MuriloVAlves/TG/Dados/MOTOR_1_ANTI.txt

PWM: 0.00 | RPM: 0.00;PWM: 0.10 | RPM: 0.00;PWM: 0.20 | RPM: 0.00;PWM: 0.29 | RPM: 0.00;PWM: 0.39 | RPM: 0.00;PWM: 0.49 | RPM: 0.00;PWM: 0.59 | RPM: 0.00;PWM: 0.68 | RPM: 0.00;PWM: 0.78 | RPM: 0.00;PWM: 0.88 | RPM: 0.00;PWM: 0.98 | RPM: 0.00;PWM: 1.08 | RPM: 0.00;PWM: 1.17 | RPM: 0.00;PWM: 1.27 | RPM: 0.00;PWM: 1.37 | RPM: 0.00;PWM: 1.47 | RPM: 0.00;PWM: 1.56 | RPM: 0.00;PWM: 1.66 | RPM: 0.00;PWM: 1.76 | RPM: 0.00;PWM: 1.86 | RPM: 0.00;PWM: 1.96 | RPM: 0.00;PWM: 2.05 | RPM: 0.00;PWM: 2.15 | RPM: 0.00;PWM: 2.25 | RPM: 0.00;PWM: 2.35 | RPM: 0.00;PWM: 2.44 | RPM: 0.00;PWM: 2.54 | RPM: 0.00;PWM: 2.64 | RPM: 0.00;PWM: 2.74 | RPM: 0.00;PWM: 2.83 | RPM: 0.00;PWM: 2.93 | RPM: 0.00;PWM: 3.03 | RPM: 0.00;PWM: 3.13 | RPM: 0.00;PWM: 3.23 | RPM: 0.00;PWM: 3.32 | RPM: 0.00;PWM: 3.42 | RPM: 0.00;PWM: 3.52 | RPM: 0.00;PWM: 3.62 | RPM: 0.00;PWM: 3.71 | RPM: 0.00;PWM: 3.81 | RPM: 0.00;PWM: 3.91 | RPM: 0.00;PWM: 4.01 | RPM: 0.00;PWM: 4.11 | RPM: 0.00;PWM: 4.20 | RPM: 0.00;PWM: 4.30 | RPM: 0.00;PWM: 4.40 | RPM: 0.00;PWM: 4.50 | RPM: 0.00;PWM: 4.59 | RPM: 0.00;PWM: 4.69 | RPM: 0.00;PWM: 4.79 | RPM: 0.00;PWM: 4.89 | RPM: 0.00;PWM: 4.99 | RPM: 0.00;PWM: 5.08 | RPM: 0.00;PWM: 5.18 | RPM: 0.00;PWM: 5.28 | RPM: 0.00;PWM: 5.38 | RPM: 0.00;PWM: 5.47 | RPM: 0.00;PWM: 5.57 | RPM: 0.00;PWM: 5.67 | RPM: 0.00;PWM: 5.77 | RPM: 0.00;PWM: 5.87 | RPM: 0.00;PWM: 5.96 | RPM: 0.00;PWM: 6.06 | RPM: 0.00;PWM: 6.16 | RPM: 0.00;PWM: 6.26 | RPM: 0.00;PWM: 6.35 | RPM: 0.00;PWM: 6.45 | RPM: 0.00;PWM: 6.55 | RPM: 0.00;PWM: 6.65 | RPM: 0.00;PWM: 6.74 | RPM: 0.00;PWM: 6.84 | RPM: 0.00;PWM: 6.94 | RPM: 0.00;PWM: 7.04 | RPM: 0.00;PWM: 7.14 | RPM: 0.00;PWM: 7.23 | RPM: 0.00;PWM: 7.33 | RPM: 0.00;PWM: 7.43 | RPM: 0.00;PWM: 7.53 | RPM: 0.00;PWM: 7.62 | RPM: 0.00;PWM: 7.72 | RPM: 0.00;PWM: 7.82 | RPM: 0.00;PWM: 7.92 | RPM: 0.00;PWM: 8.02 | RPM: 0.00;PWM: 8.11 | RPM: 0.00;PWM: 8.21 | RPM: 0.00;PWM: 8.31 | RPM: 0.00;PWM: 8.41 | RPM: 0.00;PWM: 8.50 | RPM: 0.00;PWM: 8.60 | RPM: 0.00;PWM: 8.70 | RPM: 0.00;PWM: 8.80 | RPM: 0.00;PWM: 8.90 | RPM: 0.00;PWM: 8.99 | RPM: 0.00;PWM: 9.09 | RPM: 0.00;PWM: 9.19 | RPM: 0.00;PWM: 9.29 | RPM: 0.00;PWM: 9.38 | RPM: 0.00;PWM: 9.48 | RPM: 0.00;PWM: 9.58 | RPM: 0.00;PWM: 9.68 | RPM: 0.00;PWM: 9.78 | RPM: 0.00;PWM: 9.87 | RPM: 0.00;PWM: 9.97 | RPM: 0.00;PWM: 10.07 | RPM: 0.00;PWM: 10.17 | RPM: 0.00;PWM: 10.26 | RPM: 0.00;PWM: 10.36 | RPM: 0.00;PWM: 10.46 | RPM: 0.00;PWM: 10.56 | RPM: 0.00;PWM: 10.65 | RPM: 0.00;PWM: 10.75 | RPM: 0.00;PWM: 10.85 | RPM: 0.00;PWM: 10.95 | RPM: 0.00;PWM: 11.05 | RPM: 0.00;PWM: 11.14 | RPM: 0.00;PWM: 11.24 | RPM: 0.00;PWM: 11.34 | RPM: 0.00;PWM: 11.44 | RPM: 0.00;PWM: 11.53 | RPM: 0.00;PWM: 11.63 | RPM: 0.00;PWM: 11.73 | RPM: 0.00;PWM: 11.83 | RPM: 0.00;PWM: 11.93 | RPM: 0.00;PWM: 12.02 | RPM: 0.00;PWM: 12.12 | RPM: 0.00;PWM: 12.22 | RPM: 0.00;PWM: 12.32 | RPM: 0.00;PWM: 12.41 | RPM: 0.00;PWM: 12.51 | RPM: 0.00;PWM: 12.61 | RPM: 0.00;PWM: 12.71 | RPM: 0.00;PWM: 12.81 | RPM: 0.00;PWM: 12.90 | RPM: 0.00;PWM: 13.00 | RPM: 0.00;PWM: 13.10 | RPM: 0.00;PWM: 13.20 | RPM: 0.00;PWM: 13.29 | RPM: 0.00;PWM: 13.39 | RPM: 0.00;PWM: 13.49 | RPM: 0.00;PWM: 13.59 | RPM: 0.00;PWM: 13.69 | RPM: 0.00;PWM: 13.78 | RPM: 0.00;PWM: 13.88 | RPM: 0.00;PWM: 13.98 | RPM: 0.00;PWM: 14.08 | RPM: 0.00;PWM: 14.17 | RPM: 0.00;PWM: 14.27 | RPM: 0.00;PWM: 14.37 | RPM: 0.00;PWM: 14.47 | RPM: 0.00;PWM: 14.57 | RPM: 0.00;PWM: 14.66 | RPM: 0.00;PWM: 14.76 | RPM: 0.00;PWM: 14.86 | RPM: 0.00;PWM: 14.96 | RPM: 0.00;PWM: 15.05 | RPM: 0.00;PWM: 15.15 | RPM: 0.00;PWM: 15.25 | RPM: 0.00;PWM: 15.35 | RPM: 0.00;PWM: 15.44 | RPM: 0.00;PWM: 15.54 | RPM: 0.00;PWM: 15.64 | RPM: 0.00;PWM: 15.74 | RPM: 0.00;PWM: 15.84 | RPM: 0.00;PWM: 15.93 | RPM: 0.00;PWM: 16.03 | RPM: 0.00;PWM: 16.13 | RPM: 0.00;PWM: 16.23 | RPM: 0.00;PWM: 16.32 | RPM: 0.00;PWM: 16.42 | RPM: 0.00;PWM: 16.52 | RPM: 0.00;PWM: 16.62 | RPM: 0.00;PWM: 16.72 | RPM: 0.00;PWM: 16.81 | RPM: 0.00;PWM: 16.91 | RPM: 0.00;PWM: 17.01 | RPM: 0.00;PWM: 17.11 | RPM: 0.00;PWM: 17.20 | RPM: 0.00;PWM: 17.30 | RPM: 0.00;PWM: 17.40 | RPM: 0.00;PWM: 17.50 | RPM: 0.00;PWM: 17.60 | RPM: 0.00;PWM: 17.69 | RPM: 0.00;PWM: 17.79 | RPM: 0.00;PWM: 17.89 | RPM: 0.00;PWM: 17.99 | RPM: 0.00;PWM: 18.08 | RPM: 0.00;PWM: 18.18 | RPM: 0.00;PWM: 18.28 | RPM: 0.00;PWM: 18.38 | RPM: 0.00;PWM: 18.48 | RPM: 0.00;PWM: 18.57 | RPM: 0.00;PWM: 18.67 | RPM: 0.00;PWM: 18.77 | RPM: 0.00;PWM: 18.87 | RPM: 0.00;PWM: 18.96 | RPM: 0.00;PWM: 19.06 | RPM: 0.00;PWM: 19.16 | RPM: 0.00;PWM: 19.26 | RPM: 0.00;PWM: 19.35 | RPM: 0.00;PWM: 19.45 | RPM: 0.00;PWM: 19.55 | RPM: 0.00;PWM: 19.65 | RPM: 0.00;PWM: 19.75 | RPM: 0.00;PWM: 19.84 | RPM: 0.00;PWM: 19.94 | RPM: 0.00;PWM: 20.04 | RPM: 0.00;PWM: 20.14 | RPM: 0.00;PWM: 20.23 | RPM: 0.00;PWM: 20.33 | RPM: 0.00;PWM: 20.43 | RPM: 0.00;PWM: 20.53 | RPM: 0.00;PWM: 20.63 | RPM: 0.00;PWM: 20.72 | RPM: 0.00;PWM: 20.82 | RPM: 0.00;PWM: 20.92 | RPM: 0.00;PWM: 21.02 | RPM: 0.00;PWM: 21.11 | RPM: 0.00;PWM: 21.21 | RPM: 0.00;PWM: 21.31 | RPM: 0.00;PWM: 21.41 | RPM: 0.00;PWM: 21.51 | RPM: 0.00;PWM: 21.60 | RPM: 0.00;PWM: 21.70 | RPM: 0.00;PWM: 21.80 | RPM: 0.00;PWM: 21.90 | RPM: 0.00;PWM: 21.99 | RPM: 0.00;PWM: 22.09 | RPM: 0.00;PWM: 22.19 | RPM: 0.00;PWM: 22.29 | RPM: 0.00;PWM: 22.39 | RPM: 0.00;PWM: 22.48 | RPM: 0.00;PWM: 22.58 | RPM: 0.00;PWM: 22.68 | RPM: 0.00;PWM: 22.78 | RPM: 0.00;PWM: 22.87 | RPM: 0.00;PWM: 22.97 | RPM: 0.00;PWM: 23.07 | RPM: 0.00;PWM: 23.17 | RPM: 0.00;PWM: 23.26 | RPM: 0.00;PWM: 23.36 | RPM: 0.00;PWM: 23.46 | RPM: 0.00;PWM: 23.56 | RPM: 0.00;PWM: 23.66 | RPM: 0.00;PWM: 23.75 | RPM: 0.00;PWM: 23.85 | RPM: 0.00;PWM: 23.95 | RPM: 0.00;PWM: 24.05 | RPM: 0.00;PWM: 24.14 | RPM: 0.00;PWM: 24.24 | RPM: 0.00;PWM: 24.34 | RPM: 0.00;PWM: 24.44 | RPM: 0.00;PWM: 24.54 | RPM: 0.00;PWM: 24.63 | RPM: 0.00;PWM: 24.73 | RPM: 0.00;PWM: 24.83 | RPM: 0.00;PWM: 24.93 | RPM: 0.00;PWM: 25.02 | RPM: 0.00;PWM: 25.12 | RPM: 0.00;PWM: 25.22 | RPM: 0.00;PWM: 25.32 | RPM: 0.00;PWM: 25.42 | RPM: 0.00;PWM: 25.51 | RPM: 0.00;PWM: 25.61 | RPM: 0.00;PWM: 25.71 | RPM: 0.00;PWM: 25.81 | RPM: 0.00;PWM: 25.90 | RPM: 0.00;PWM: 26.00 | RPM: 0.00;PWM: 26.10 | RPM: 0.00;PWM: 26.20 | RPM: 0.00;PWM: 26.30 | RPM: 0.00;PWM: 26.39 | RPM: 0.00;PWM: 26.49 | RPM: 0.00;PWM: 26.59 | RPM: 0.00;PWM: 26.69 | RPM: 0.00;PWM: 26.78 | RPM: 0.00;PWM: 26.88 | RPM: 0.00;PWM: 26.98 | RPM: 0.00;PWM: 27.08 | RPM: 0.00;PWM: 27.17 | RPM: 0.00;PWM: 27.27 | RPM: 0.00;PWM: 27.37 | RPM: 0.00;PWM: 27.47 | RPM: 0.00;PWM: 27.57 | RPM: 0.00;PWM: 27.66 | RPM: 0.00;PWM: 27.76 | RPM: 0.00;PWM: 27.86 | RPM: 0.00;PWM: 27.96 | RPM: 0.00;PWM: 28.05 | RPM: 0.00;PWM: 28.15 | RPM: 0.00;PWM: 28.25 | RPM: 0.00;PWM: 28.35 | RPM: 0.00;PWM: 28.45 | RPM: 0.00;PWM: 28.54 | RPM: 0.00;PWM: 28.64 | RPM: 0.00;PWM: 28.74 | RPM: 0.00;PWM: 28.84 | RPM: 0.00;PWM: 28.93 | RPM: 0.00;PWM: 29.03 | RPM: 0.00;PWM: 29.13 | RPM: 0.00;PWM: 29.23 | RPM: 0.00;PWM: 29.33 | RPM: 0.00;PWM: 29.42 | RPM: 0.00;PWM: 29.52 | RPM: 0.00;PWM: 29.62 | RPM: 0.00;PWM: 29.72 | RPM: 0.00;PWM: 29.81 | RPM: 0.00;PWM: 29.91 | RPM: 0.00;PWM: 30.01 | RPM: 0.00;PWM: 30.11 | RPM: 0.00;PWM: 30.21 | RPM: 0.00;PWM: 30.30 | RPM: 0.00;PWM: 30.40 | RPM: 0.00;PWM: 30.50 | RPM: 0.00;PWM: 30.60 | RPM: 0.00;PWM: 30.69 | RPM: 0.00;PWM: 30.79 | RPM: 0.00;PWM: 30.89 | RPM: 0.00;PWM: 30.99 | RPM: 0.00;PWM: 31.09 | RPM: 0.00;PWM: 31.18 | RPM: 0.00;PWM: 31.28 | RPM: 0.00;PWM: 31.38 | RPM: 0.00;PWM: 31.48 | RPM: 0.00;PWM: 31.57 | RPM: 0.00;PWM: 31.67 | RPM: 0.00;PWM: 31.77 | RPM: 0.00;PWM: 31.87 | RPM: 0.00;PWM: 31.96 | RPM: 0.00;PWM: 32.06 | RPM: 0.00;PWM: 32.16 | RPM: 0.00;PWM: 32.26 | RPM: 0.00;PWM: 32.36 | RPM: 0.00;PWM: 32.45 | RPM: 0.00;PWM: 32.55 | RPM: 0.00;PWM: 32.65 | RPM: 0.00;PWM: 32.75 | RPM: 0.00;PWM: 32.84 | RPM: 0.00;PWM: 32.94 | RPM: 0.00;PWM: 33.04 | RPM: 0.00;PWM: 33.14 | RPM: 0.00;PWM: 33.24 | RPM: 0.00;PWM: 33.33 | RPM: 0.00;PWM: 33.43 | RPM: 0.00;PWM: 33.53 | RPM: 0.00;PWM: 33.63 | RPM: 0.00;PWM: 33.72 | RPM: 0.00;PWM: 33.82 | RPM: 0.00;PWM: 33.92 | RPM: 0.00;PWM: 34.02 | RPM: 0.00;PWM: 34.12 | RPM: 0.00;PWM: 34.21 | RPM: 0.00;PWM: 34.31 | RPM: 0.00;PWM: 34.41 | RPM: 0.00;PWM: 34.51 | RPM: 0.00;PWM: 34.60 | RPM: 0.00;PWM: 34.70 | RPM: 0.00;PWM: 34.80 | RPM: 0.00;PWM: 34.90 | RPM: 0.00;PWM: 35.00 | RPM: 0.00;PWM: 35.09 | RPM: 0.00;PWM: 35.19 | RPM: 0.00;PWM: 35.29 | RPM: 0.00;PWM: 35.39 | RPM: 0.00;PWM: 35.48 | RPM: 0.00;PWM: 35.58 | RPM: 0.00;PWM: 35.68 | RPM: 0.00;PWM: 35.78 | RPM: 0.00;PWM: 35.87 | RPM: 0.00;PWM: 35.97 | RPM: 0.00;PWM: 36.07 | RPM: 0.00;PWM: 36.17 | RPM: 0.00;PWM: 36.27 | RPM: 0.00;PWM: 36.36 | RPM: 0.00;PWM: 36.46 | RPM: 0.00;PWM: 36.56 | RPM: 0.00;PWM: 36.66 | RPM: 0.00;PWM: 36.75 | RPM: 0.00;PWM: 36.85 | RPM: 0.00;PWM: 36.95 | RPM: 0.00;PWM: 37.05 | RPM: 0.00;PWM: 37.15 | RPM: 0.00;PWM: 37.24 | RPM: 0.00;PWM: 37.34 | RPM: 0.00;PWM: 37.44 | RPM: 0.00;PWM: 37.54 | RPM: 0.00;PWM: 37.63 | RPM: 0.00;PWM: 37.73 | RPM: 0.00;PWM: 37.83 | RPM: 0.00;PWM: 37.93 | RPM: 0.00;PWM: 38.03 | RPM: 0.00;PWM: 38.12 | RPM: 0.00;PWM: 38.22 | RPM: 0.00;PWM: 38.32 | RPM: 0.00;PWM: 38.42 | RPM: 0.00;PWM: 38.51 | RPM: 0.00;PWM: 38.61 | RPM: 0.00;PWM: 38.71 | RPM: 0.00;PWM: 38.81 | RPM: 0.00;PWM: 38.91 | RPM: 0.00;PWM: 39.00 | RPM: 0.00;PWM: 39.10 | RPM: 0.00;PWM: 39.20 | RPM: 0.00;PWM: 39.30 | RPM: 0.00;PWM: 39.39 | RPM: 0.00;PWM: 39.49 | RPM: 0.00;PWM: 39.59 | RPM: 0.00;PWM: 39.69 | RPM: 0.00;PWM: 39.78 | RPM: 0.00;PWM: 39.88 | RPM: 0.00;PWM: 39.98 | RPM: 0.00;PWM: 40.08 | RPM: 0.00;PWM: 40.18 | RPM: 0.00;PWM: 40.27 | RPM: 0.00;PWM: 40.37 | RPM: 0.00;PWM: 40.47 | RPM: 0.00;PWM: 40.57 | RPM: 0.00;PWM: 40.66 | RPM: 0.00;PWM: 40.76 | RPM: 0.00;PWM: 40.86 | RPM: 0.00;PWM: 40.96 | RPM: 0.00;PWM: 41.06 | RPM: 0.00;PWM: 41.15 | RPM: 0.00;PWM: 41.25 | RPM: 0.00;PWM: 41.35 | RPM: 0.00;PWM: 41.45 | RPM: 0.00;PWM: 41.54 | RPM: 0.00;PWM: 41.64 | RPM: 0.00;PWM: 41.74 | RPM: 0.00;PWM: 41.84 | RPM: 0.00;PWM: 41.94 | RPM: 0.00;PWM: 42.03 | RPM: 0.00;PWM: 42.13 | RPM: 0.00;PWM: 42.23 | RPM: 0.00;PWM: 42.33 | RPM: 16.67;PWM: 42.42 | RPM: 93.33;PWM: 42.52 | RPM: 136.67;PWM: 42.62 | RPM: 153.33;PWM: 42.72 | RPM: 150.00;PWM: 42.82 | RPM: 153.33;PWM: 42.91 | RPM: 153.33;PWM: 43.01 | RPM: 156.67;PWM: 43.11 | RPM: 156.67;PWM: 43.21 | RPM: 156.67;PWM: 43.30 | RPM: 160.00;PWM: 43.40 | RPM: 160.00;PWM: 43.50 | RPM: 160.00;PWM: 43.60 | RPM: 160.00;PWM: 43.70 | RPM: 163.33;PWM: 43.79 | RPM: 163.33;PWM: 43.89 | RPM: 163.33;PWM: 43.99 | RPM: 166.67;PWM: 44.09 | RPM: 166.67;PWM: 44.18 | RPM: 170.00;PWM: 44.28 | RPM: 170.00;PWM: 44.38 | RPM: 170.00;PWM: 44.48 | RPM: 173.33;PWM: 44.57 | RPM: 173.33;PWM: 44.67 | RPM: 176.67;PWM: 44.77 | RPM: 180.00;PWM: 44.87 | RPM: 176.67;PWM: 44.97 | RPM: 176.67;PWM: 45.06 | RPM: 176.67;PWM: 45.16 | RPM: 180.00;PWM: 45.26 | RPM: 180.00;PWM: 45.36 | RPM: 180.00;PWM: 45.45 | RPM: 183.33;PWM: 45.55 | RPM: 180.00;PWM: 45.65 | RPM: 186.67;PWM: 45.75 | RPM: 186.67;PWM: 45.85 | RPM: 186.67;PWM: 45.94 | RPM: 186.67;PWM: 46.04 | RPM: 193.33;PWM: 46.14 | RPM: 190.00;PWM: 46.24 | RPM: 193.33;PWM: 46.33 | RPM: 193.33;PWM: 46.43 | RPM: 193.33;PWM: 46.53 | RPM: 196.67;PWM: 46.63 | RPM: 196.67;PWM: 46.73 | RPM: 200.00;PWM: 46.82 | RPM: 203.33;PWM: 46.92 | RPM: 203.33;PWM: 47.02 | RPM: 200.00;PWM: 47.12 | RPM: 203.33;PWM: 47.21 | RPM: 200.00;PWM: 47.31 | RPM: 206.67;PWM: 47.41 | RPM: 203.33;PWM: 47.51 | RPM: 206.67;PWM: 47.61 | RPM: 206.67;PWM: 47.70 | RPM: 210.00;PWM: 47.80 | RPM: 210.00;PWM: 47.90 | RPM: 216.67;PWM: 48.00 | RPM: 216.67;PWM: 48.09 | RPM: 216.67;PWM: 48.19 | RPM: 223.33;PWM: 48.29 | RPM: 216.67;PWM: 48.39 | RPM: 220.00;PWM: 48.48 | RPM: 223.33;PWM: 48.58 | RPM: 216.67;PWM: 48.68 | RPM: 223.33;PWM: 48.78 | RPM: 226.67;PWM: 48.88 | RPM: 220.00;PWM: 48.97 | RPM: 223.33;PWM: 49.07 | RPM: 226.67;PWM: 49.17 | RPM: 223.33;PWM: 49.27 | RPM: 226.67;PWM: 49.36 | RPM: 226.67;PWM: 49.46 | RPM: 226.67;PWM: 49.56 | RPM: 230.00;PWM: 49.66 | RPM: 233.33;PWM: 49.76 | RPM: 230.00;PWM: 49.85 | RPM: 233.33;PWM: 49.95 | RPM: 233.33;PWM: 50.05 | RPM: 236.67;PWM: 50.15 | RPM: 240.00;PWM: 50.24 | RPM: 236.67;PWM: 50.34 | RPM: 240.00;PWM: 50.44 | RPM: 236.67;PWM: 50.54 | RPM: 243.33;PWM: 50.64 | RPM: 243.33;PWM: 50.73 | RPM: 243.33;PWM: 50.83 | RPM: 243.33;PWM: 50.93 | RPM: 243.33;PWM: 51.03 | RPM: 243.33;PWM: 51.12 | RPM: 243.33;PWM: 51.22 | RPM: 246.67;PWM: 51.32 | RPM: 250.00;PWM: 51.42 | RPM: 250.00;PWM: 51.52 | RPM: 253.33;PWM: 51.61 | RPM: 250.00;PWM: 51.71 | RPM: 253.33;PWM: 51.81 | RPM: 253.33;PWM: 51.91 | RPM: 256.67;PWM: 52.00 | RPM: 256.67;PWM: 52.10 | RPM: 256.67;PWM: 52.20 | RPM: 260.00;PWM: 52.30 | RPM: 263.33;PWM: 52.39 | RPM: 260.00;PWM: 52.49 | RPM: 263.33;PWM: 52.59 | RPM: 263.33;PWM: 52.69 | RPM: 263.33;PWM: 52.79 | RPM: 266.67;PWM: 52.88 | RPM: 266.67;PWM: 52.98 | RPM: 273.33;PWM: 53.08 | RPM: 276.67;PWM: 53.18 | RPM: 276.67;PWM: 53.27 | RPM: 273.33;PWM: 53.37 | RPM: 276.67;PWM: 53.47 | RPM: 273.33;PWM: 53.57 | RPM: 276.67;PWM: 53.67 | RPM: 283.33;PWM: 53.76 | RPM: 280.00;PWM: 53.86 | RPM: 276.67;PWM: 53.96 | RPM: 286.67;PWM: 54.06 | RPM: 286.67;PWM: 54.15 | RPM: 280.00;PWM: 54.25 | RPM: 283.33;PWM: 54.35 | RPM: 283.33;PWM: 54.45 | RPM: 290.00;PWM: 54.55 | RPM: 283.33;PWM: 54.64 | RPM: 293.33;PWM: 54.74 | RPM: 286.67;PWM: 54.84 | RPM: 290.00;PWM: 54.94 | RPM: 293.33;PWM: 55.03 | RPM: 290.00;PWM: 55.13 | RPM: 293.33;PWM: 55.23 | RPM: 293.33;PWM: 55.33 | RPM: 293.33;PWM: 55.43 | RPM: 293.33;PWM: 55.52 | RPM: 303.33;PWM: 55.62 | RPM: 296.67;PWM: 55.72 | RPM: 303.33;PWM: 55.82 | RPM: 310.00;PWM: 55.91 | RPM: 306.67;PWM: 56.01 | RPM: 303.33;PWM: 56.11 | RPM: 303.33;PWM: 56.21 | RPM: 306.67;PWM: 56.30 | RPM: 306.67;PWM: 56.40 | RPM: 306.67;PWM: 56.50 | RPM: 306.67;PWM: 56.60 | RPM: 306.67;PWM: 56.70 | RPM: 313.33;PWM: 56.79 | RPM: 316.67;PWM: 56.89 | RPM: 310.00;PWM: 56.99 | RPM: 316.67;PWM: 57.09 | RPM: 316.67;PWM: 57.18 | RPM: 320.00;PWM: 57.28 | RPM: 310.00;PWM: 57.38 | RPM: 310.00;PWM: 57.48 | RPM: 316.67;PWM: 57.58 | RPM: 316.67;PWM: 57.67 | RPM: 320.00;PWM: 57.77 | RPM: 323.33;PWM: 57.87 | RPM: 330.00;PWM: 57.97 | RPM: 323.33;PWM: 58.06 | RPM: 323.33;PWM: 58.16 | RPM: 330.00;PWM: 58.26 | RPM: 326.67;PWM: 58.36 | RPM: 330.00;PWM: 58.46 | RPM: 330.00;PWM: 58.55 | RPM: 333.33;PWM: 58.65 | RPM: 330.00;PWM: 58.75 | RPM: 336.67;PWM: 58.85 | RPM: 336.67;PWM: 58.94 | RPM: 336.67;PWM: 59.04 | RPM: 340.00;PWM: 59.14 | RPM: 336.67;PWM: 59.24 | RPM: 350.00;PWM: 59.34 | RPM: 340.00;PWM: 59.43 | RPM: 340.00;PWM: 59.53 | RPM: 343.33;PWM: 59.63 | RPM: 343.33;PWM: 59.73 | RPM: 343.33;PWM: 59.82 | RPM: 346.67;PWM: 59.92 | RPM: 356.67;PWM: 60.02 | RPM: 346.67;PWM: 60.12 | RPM: 360.00;PWM: 60.22 | RPM: 350.00;PWM: 60.31 | RPM: 350.00;PWM: 60.41 | RPM: 366.67;PWM: 60.51 | RPM: 356.67;PWM: 60.61 | RPM: 356.67;PWM: 60.70 | RPM: 363.33;PWM: 60.80 | RPM: 366.67;PWM: 60.90 | RPM: 366.67;PWM: 61.00 | RPM: 363.33;PWM: 61.09 | RPM: 360.00;PWM: 61.19 | RPM: 366.67;PWM: 61.29 | RPM: 363.33;PWM: 61.39 | RPM: 363.33;PWM: 61.49 | RPM: 370.00;PWM: 61.58 | RPM: 366.67;PWM: 61.68 | RPM: 370.00;PWM: 61.78 | RPM: 370.00;PWM: 61.88 | RPM: 370.00;PWM: 61.97 | RPM: 373.33;PWM: 62.07 | RPM: 370.00;PWM: 62.17 | RPM: 373.33;PWM: 62.27 | RPM: 376.67;PWM: 62.37 | RPM: 373.33;PWM: 62.46 | RPM: 373.33;PWM: 62.56 | RPM: 383.33;PWM: 62.66 | RPM: 373.33;PWM: 62.76 | RPM: 376.67;PWM: 62.85 | RPM: 373.33;PWM: 62.95 | RPM: 373.33;PWM: 63.05 | RPM: 380.00;PWM: 63.15 | RPM: 380.00;PWM: 63.25 | RPM: 376.67;PWM: 63.34 | RPM: 386.67;PWM: 63.44 | RPM: 390.00;PWM: 63.54 | RPM: 380.00;PWM: 63.64 | RPM: 383.33;PWM: 63.73 | RPM: 386.67;PWM: 63.83 | RPM: 393.33;PWM: 63.93 | RPM: 393.33;PWM: 64.03 | RPM: 390.00;PWM: 64.13 | RPM: 390.00;PWM: 64.22 | RPM: 390.00;PWM: 64.32 | RPM: 393.33;PWM: 64.42 | RPM: 390.00;PWM: 64.52 | RPM: 393.33;PWM: 64.61 | RPM: 393.33;PWM: 64.71 | RPM: 396.67;PWM: 64.81 | RPM: 376.67;PWM: 64.91 | RPM: 393.33;PWM: 65.00 | RPM: 393.33;PWM: 65.10 | RPM: 370.00;PWM: 65.20 | RPM: 360.00;PWM: 65.30 | RPM: 370.00;PWM: 65.40 | RPM: 366.67;PWM: 65.49 | RPM: 366.67;PWM: 65.59 | RPM: 370.00;PWM: 65.69 | RPM: 370.00;PWM: 65.79 | RPM: 366.67;PWM: 65.88 | RPM: 370.00;PWM: 65.98 | RPM: 370.00;PWM: 66.08 | RPM: 370.00;PWM: 66.18 | RPM: 366.67;PWM: 66.28 | RPM: 380.00;PWM: 66.37 | RPM: 400.00;PWM: 66.47 | RPM: 413.33;PWM: 66.57 | RPM: 413.33;PWM: 66.67 | RPM: 416.67;PWM: 66.76 | RPM: 406.67;PWM: 66.86 | RPM: 403.33;PWM: 66.96 | RPM: 406.67;PWM: 67.06 | RPM: 410.00;PWM: 67.16 | RPM: 406.67;PWM: 67.25 | RPM: 400.00;PWM: 67.35 | RPM: 400.00;PWM: 67.45 | RPM: 413.33;PWM: 67.55 | RPM: 426.67;PWM: 67.64 | RPM: 430.00;PWM: 67.74 | RPM: 433.33;PWM: 67.84 | RPM: 433.33;PWM: 67.94 | RPM: 436.67;PWM: 68.04 | RPM: 436.67;PWM: 68.13 | RPM: 440.00;PWM: 68.23 | RPM: 440.00;PWM: 68.33 | RPM: 440.00;PWM: 68.43 | RPM: 440.00;PWM: 68.52 | RPM: 440.00;PWM: 68.62 | RPM: 443.33;PWM: 68.72 | RPM: 450.00;PWM: 68.82 | RPM: 446.67;PWM: 68.91 | RPM: 446.67;PWM: 69.01 | RPM: 450.00;PWM: 69.11 | RPM: 453.33;PWM: 69.21 | RPM: 453.33;PWM: 69.31 | RPM: 450.00;PWM: 69.40 | RPM: 456.67;PWM: 69.50 | RPM: 453.33;PWM: 69.60 | RPM: 453.33;PWM: 69.70 | RPM: 456.67;PWM: 69.79 | RPM: 463.33;PWM: 69.89 | RPM: 463.33;PWM: 69.99 | RPM: 466.67;PWM: 70.09 | RPM: 460.00;PWM: 70.19 | RPM: 470.00;PWM: 70.28 | RPM: 463.33;PWM: 70.38 | RPM: 463.33;PWM: 70.48 | RPM: 473.33;PWM: 70.58 | RPM: 470.00;PWM: 70.67 | RPM: 473.33;PWM: 70.77 | RPM: 480.00;PWM: 70.87 | RPM: 470.00;PWM: 70.97 | RPM: 470.00;PWM: 71.07 | RPM: 473.33;PWM: 71.16 | RPM: 470.00;PWM: 71.26 | RPM: 473.33;PWM: 71.36 | RPM: 476.67;PWM: 71.46 | RPM: 480.00;PWM: 71.55 | RPM: 476.67;PWM: 71.65 | RPM: 480.00;PWM: 71.75 | RPM: 493.33;PWM: 71.85 | RPM: 476.67;PWM: 71.95 | RPM: 483.33;PWM: 72.04 | RPM: 483.33;PWM: 72.14 | RPM: 493.33;PWM: 72.24 | RPM: 490.00;PWM: 72.34 | RPM: 490.00;PWM: 72.43 | RPM: 480.00;PWM: 72.53 | RPM: 483.33;PWM: 72.63 | RPM: 490.00;PWM: 72.73 | RPM: 490.00;PWM: 72.83 | RPM: 490.00;PWM: 72.92 | RPM: 483.33;PWM: 73.02 | RPM: 483.33;PWM: 73.12 | RPM: 476.67;PWM: 73.22 | RPM: 476.67;PWM: 73.31 | RPM: 476.67;PWM: 73.41 | RPM: 486.67;PWM: 73.51 | RPM: 490.00;PWM: 73.61 | RPM: 496.67;PWM: 73.70 | RPM: 503.33;PWM: 73.80 | RPM: 493.33;PWM: 73.90 | RPM: 500.00;PWM: 74.00 | RPM: 500.00;PWM: 74.10 | RPM: 510.00;PWM: 74.19 | RPM: 506.67;PWM: 74.29 | RPM: 520.00;PWM: 74.39 | RPM: 510.00;PWM: 74.49 | RPM: 510.00;PWM: 74.58 | RPM: 510.00;PWM: 74.68 | RPM: 506.67;PWM: 74.78 | RPM: 506.67;PWM: 74.88 | RPM: 516.67;PWM: 74.98 | RPM: 510.00;PWM: 75.07 | RPM: 516.67;PWM: 75.17 | RPM: 520.00;PWM: 75.27 | RPM: 526.67;PWM: 75.37 | RPM: 526.67;PWM: 75.46 | RPM: 526.67;PWM: 75.56 | RPM: 536.67;PWM: 75.66 | RPM: 520.00;PWM: 75.76 | RPM: 520.00;PWM: 75.86 | RPM: 523.33;PWM: 75.95 | RPM: 516.67;PWM: 76.05 | RPM: 513.33;PWM: 76.15 | RPM: 513.33;PWM: 76.25 | RPM: 526.67;PWM: 76.34 | RPM: 513.33;PWM: 76.44 | RPM: 510.00;PWM: 76.54 | RPM: 513.33;PWM: 76.64 | RPM: 510.00;PWM: 76.74 | RPM: 510.00;PWM: 76.83 | RPM: 513.33;PWM: 76.93 | RPM: 506.67;PWM: 77.03 | RPM: 513.33;PWM: 77.13 | RPM: 516.67;PWM: 77.22 | RPM: 506.67;PWM: 77.32 | RPM: 516.67;PWM: 77.42 | RPM: 520.00;PWM: 77.52 | RPM: 520.00;PWM: 77.61 | RPM: 510.00;PWM: 77.71 | RPM: 510.00;PWM: 77.81 | RPM: 523.33;PWM: 77.91 | RPM: 510.00;PWM: 78.01 | RPM: 516.67;PWM: 78.10 | RPM: 510.00;PWM: 78.20 | RPM: 520.00;PWM: 78.30 | RPM: 513.33;PWM: 78.40 | RPM: 503.33;PWM: 78.49 | RPM: 500.00;PWM: 78.59 | RPM: 500.00;PWM: 78.69 | RPM: 506.67;PWM: 78.79 | RPM: 503.33;PWM: 78.89 | RPM: 503.33;PWM: 78.98 | RPM: 506.67;PWM: 79.08 | RPM: 513.33;PWM: 79.18 | RPM: 506.67;PWM: 79.28 | RPM: 506.67;PWM: 79.37 | RPM: 510.00;PWM: 79.47 | RPM: 510.00;PWM: 79.57 | RPM: 513.33;PWM: 79.67 | RPM: 513.33;PWM: 79.77 | RPM: 503.33;PWM: 79.86 | RPM: 520.00;PWM: 79.96 | RPM: 513.33;PWM: 80.06 | RPM: 510.00;PWM: 80.16 | RPM: 510.00;PWM: 80.25 | RPM: 510.00;PWM: 80.35 | RPM: 493.33;PWM: 80.45 | RPM: 496.67;PWM: 80.55 | RPM: 503.33;PWM: 80.65 | RPM: 493.33;PWM: 80.74 | RPM: 490.00;PWM: 80.84 | RPM: 496.67;PWM: 80.94 | RPM: 490.00;PWM: 81.04 | RPM: 496.67;PWM: 81.13 | RPM: 503.33;PWM: 81.23 | RPM: 506.67;PWM: 81.33 | RPM: 513.33;PWM: 81.43 | RPM: 520.00;PWM: 81.52 | RPM: 516.67;PWM: 81.62 | RPM: 516.67;PWM: 81.72 | RPM: 523.33;PWM: 81.82 | RPM: 526.67;PWM: 81.92 | RPM: 516.67;PWM: 82.01 | RPM: 516.67;PWM: 82.11 | RPM: 520.00;PWM: 82.21 | RPM: 533.33;PWM: 82.31 | RPM: 533.33;PWM: 82.40 | RPM: 543.33;PWM: 82.50 | RPM: 540.00;PWM: 82.60 | RPM: 546.67;PWM: 82.70 | RPM: 540.00;PWM: 82.80 | RPM: 543.33;PWM: 82.89 | RPM: 543.33;PWM: 82.99 | RPM: 553.33;PWM: 83.09 | RPM: 550.00;PWM: 83.19 | RPM: 556.67;PWM: 83.28 | RPM: 560.00;PWM: 83.38 | RPM: 570.00;PWM: 83.48 | RPM: 570.00;PWM: 83.58 | RPM: 556.67;PWM: 83.68 | RPM: 563.33;PWM: 83.77 | RPM: 573.33;PWM: 83.87 | RPM: 570.00;PWM: 83.97 | RPM: 570.00;PWM: 84.07 | RPM: 570.00;PWM: 84.16 | RPM: 576.67;PWM: 84.26 | RPM: 580.00;PWM: 84.36 | RPM: 576.67;PWM: 84.46 | RPM: 580.00;PWM: 84.56 | RPM: 583.33;PWM: 84.65 | RPM: 586.67;PWM: 84.75 | RPM: 583.33;PWM: 84.85 | RPM: 593.33;PWM: 84.95 | RPM: 593.33;PWM: 85.04 | RPM: 603.33;PWM: 85.14 | RPM: 606.67;PWM: 85.24 | RPM: 603.33;PWM: 85.34 | RPM: 610.00;PWM: 85.43 | RPM: 606.67;PWM: 85.53 | RPM: 606.67;PWM: 85.63 | RPM: 606.67;PWM: 85.73 | RPM: 616.67;PWM: 85.83 | RPM: 610.00;PWM: 85.92 | RPM: 620.00;PWM: 86.02 | RPM: 630.00;PWM: 86.12 | RPM: 623.33;PWM: 86.22 | RPM: 613.33;PWM: 86.31 | RPM: 630.00;PWM: 86.41 | RPM: 623.33;PWM: 86.51 | RPM: 630.00;PWM: 86.61 | RPM: 630.00;PWM: 86.71 | RPM: 636.67;PWM: 86.80 | RPM: 640.00;PWM: 86.90 | RPM: 643.33;PWM: 87.00 | RPM: 650.00;PWM: 87.10 | RPM: 646.67;PWM: 87.19 | RPM: 643.33;PWM: 87.29 | RPM: 643.33;PWM: 87.39 | RPM: 653.33;PWM: 87.49 | RPM: 653.33;PWM: 87.59 | RPM: 656.67;PWM: 87.68 | RPM: 650.00;PWM: 87.78 | RPM: 656.67;PWM: 87.88 | RPM: 663.33;PWM: 87.98 | RPM: 663.33;PWM: 88.07 | RPM: 660.00;PWM: 88.17 | RPM: 656.67;PWM: 88.27 | RPM: 673.33;PWM: 88.37 | RPM: 660.00;PWM: 88.47 | RPM: 680.00;PWM: 88.56 | RPM: 670.00;PWM: 88.66 | RPM: 686.67;PWM: 88.76 | RPM: 680.00;PWM: 88.86 | RPM: 686.67;PWM: 88.95 | RPM: 690.00;PWM: 89.05 | RPM: 703.33;PWM: 89.15 | RPM: 703.33;PWM: 89.25 | RPM: 696.67;PWM: 89.35 | RPM: 706.67;PWM: 89.44 | RPM: 706.67;PWM: 89.54 | RPM: 710.00;PWM: 89.64 | RPM: 706.67;PWM: 89.74 | RPM: 713.33;PWM: 89.83 | RPM: 710.00;PWM: 89.93 | RPM: 720.00;PWM: 90.03 | RPM: 723.33;PWM: 90.13 | RPM: 723.33;PWM: 90.22 | RPM: 713.33;PWM: 90.32 | RPM: 713.33;PWM: 90.42 | RPM: 720.00;PWM: 90.52 | RPM: 726.67;PWM: 90.62 | RPM: 743.33;PWM: 90.71 | RPM: 736.67;PWM: 90.81 | RPM: 736.67;PWM: 90.91 | RPM: 740.00;PWM: 91.01 | RPM: 730.00;PWM: 91.10 | RPM: 740.00;PWM: 91.20 | RPM: 746.67;PWM: 91.30 | RPM: 750.00;PWM: 91.40 | RPM: 753.33;PWM: 91.50 | RPM: 746.67;PWM: 91.59 | RPM: 753.33;PWM: 91.69 | RPM: 743.33;PWM: 91.79 | RPM: 753.33;PWM: 91.89 | RPM: 766.67;PWM: 91.98 | RPM: 760.00;PWM: 92.08 | RPM: 770.00;PWM: 92.18 | RPM: 773.33;PWM: 92.28 | RPM: 766.67;PWM: 92.38 | RPM: 770.00;PWM: 92.47 | RPM: 763.33;PWM: 92.57 | RPM: 766.67;PWM: 92.67 | RPM: 783.33;PWM: 92.77 | RPM: 776.67;PWM: 92.86 | RPM: 776.67;PWM: 92.96 | RPM: 780.00;PWM: 93.06 | RPM: 793.33;PWM: 93.16 | RPM: 783.33;PWM: 93.26 | RPM: 783.33;PWM: 93.35 | RPM: 793.33;PWM: 93.45 | RPM: 796.67;PWM: 93.55 | RPM: 800.00;PWM: 93.65 | RPM: 796.67;PWM: 93.74 | RPM: 810.00;PWM: 93.84 | RPM: 793.33;PWM: 93.94 | RPM: 793.33;PWM: 94.04 | RPM: 796.67;PWM: 94.13 | RPM: 796.67;PWM: 94.23 | RPM: 810.00;PWM: 94.33 | RPM: 810.00;PWM: 94.43 | RPM: 800.00;PWM: 94.53 | RPM: 803.33;PWM: 94.62 | RPM: 813.33;PWM: 94.72 | RPM: 823.33;PWM: 94.82 | RPM: 813.33;PWM: 94.92 | RPM: 823.33;PWM: 95.01 | RPM: 820.00;PWM: 95.11 | RPM: 823.33;PWM: 95.21 | RPM: 846.67;PWM: 95.31 | RPM: 836.67;PWM: 95.41 | RPM: 833.33;PWM: 95.50 | RPM: 830.00;PWM: 95.60 | RPM: 846.67;PWM: 95.70 | RPM: 836.67;PWM: 95.80 | RPM: 846.67;PWM: 95.89 | RPM: 843.33;PWM: 95.99 | RPM: 843.33;PWM: 96.09 | RPM: 856.67;PWM: 96.19 | RPM: 853.33;PWM: 96.29 | RPM: 873.33;PWM: 96.38 | RPM: 866.67;PWM: 96.48 | RPM: 873.33;PWM: 96.58 | RPM: 870.00;PWM: 96.68 | RPM: 876.67;PWM: 96.77 | RPM: 873.33;PWM: 96.87 | RPM: 886.67;PWM: 96.97 | RPM: 900.00;PWM: 97.07 | RPM: 893.33;PWM: 97.17 | RPM: 890.00;PWM: 97.26 | RPM: 890.00;PWM: 97.36 | RPM: 886.67;PWM: 97.46 | RPM: 883.33;PWM: 97.56 | RPM: 893.33;PWM: 97.65 | RPM: 893.33;PWM: 97.75 | RPM: 906.67;PWM: 97.85 | RPM: 906.67;PWM: 97.95 | RPM: 906.67;PWM: 98.04 | RPM: 913.33;PWM: 98.14 | RPM: 913.33;PWM: 98.24 | RPM: 936.67;PWM: 98.34 | RPM: 923.33;PWM: 98.44 | RPM: 946.67;PWM: 98.53 | RPM: 926.67;PWM: 98.63 | RPM: 926.67;PWM: 98.73 | RPM: 943.33;PWM: 98.83 | RPM: 950.00;PWM: 98.92 | RPM: 946.67;PWM: 99.02 | RPM: 946.67;PWM: 99.12 | RPM: 943.33;PWM: 99.22 | RPM: 930.00;PWM: 99.32 | RPM: 930.00;PWM: 99.41 | RPM: 930.00;PWM: 99.51 | RPM: 933.33;PWM: 99.61 | RPM: 926.67;PWM: 99.71 | RPM: 936.67;PWM: 99.80 | RPM: 933.33;PWM: 99.90 | RPM: 920.00;PWM: 100.00 | RPM: 933.33;-*-*-*-Finalizado Crecrescente-*-*-*-
PWM: 100.00 | RPM: 930.00;PWM: 99.90 | RPM: 936.67;PWM: 99.80 | RPM: 926.67;PWM: 99.71 | RPM: 913.33;PWM: 99.61 | RPM: 920.00;PWM: 99.51 | RPM: 946.67;PWM: 99.41 | RPM: 933.33;PWM: 99.32 | RPM: 930.00;PWM: 99.22 | RPM: 930.00;PWM: 99.12 | RPM: 930.00;PWM: 99.02 | RPM: 940.00;PWM: 98.92 | RPM: 923.33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
