MuriloVAlves/TG/Dados/MOTOR_2_ANTI.txt

PWM: 0.00 | RPM: 0.00;PWM: 0.10 | RPM: 0.00;PWM: 0.20 | RPM: 0.00;PWM: 0.29 | RPM: 0.00;PWM: 0.39 | RPM: 0.00;PWM: 0.49 | RPM: 0.00;PWM: 0.59 | RPM: 0.00;PWM: 0.68 | RPM: 0.00;PWM: 0.78 | RPM: 0.00;PWM: 0.88 | RPM: 0.00;PWM: 0.98 | RPM: 0.00;PWM: 1.08 | RPM: 0.00;PWM: 1.17 | RPM: 0.00;PWM: 1.27 | RPM: 0.00;PWM: 1.37 | RPM: 0.00;PWM: 1.47 | RPM: 0.00;PWM: 1.56 | RPM: 0.00;PWM: 1.66 | RPM: 0.00;PWM: 1.76 | RPM: 0.00;PWM: 1.86 | RPM: 0.00;PWM: 1.96 | RPM: 0.00;PWM: 2.05 | RPM: 0.00;PWM: 2.15 | RPM: 0.00;PWM: 2.25 | RPM: 0.00;PWM: 2.35 | RPM: 0.00;PWM: 2.44 | RPM: 0.00;PWM: 2.54 | RPM: 0.00;PWM: 2.64 | RPM: 0.00;PWM: 2.74 | RPM: 0.00;PWM: 2.83 | RPM: 0.00;PWM: 2.93 | RPM: 0.00;PWM: 3.03 | RPM: 0.00;PWM: 3.13 | RPM: 0.00;PWM: 3.23 | RPM: 0.00;PWM: 3.32 | RPM: 0.00;PWM: 3.42 | RPM: 0.00;PWM: 3.52 | RPM: 0.00;PWM: 3.62 | RPM: 0.00;PWM: 3.71 | RPM: 0.00;PWM: 3.81 | RPM: 0.00;PWM: 3.91 | RPM: 0.00;PWM: 4.01 | RPM: 0.00;PWM: 4.11 | RPM: 0.00;PWM: 4.20 | RPM: 0.00;PWM: 4.30 | RPM: 0.00;PWM: 4.40 | RPM: 0.00;PWM: 4.50 | RPM: 0.00;PWM: 4.59 | RPM: 0.00;PWM: 4.69 | RPM: 0.00;PWM: 4.79 | RPM: 0.00;PWM: 4.89 | RPM: 0.00;PWM: 4.99 | RPM: 0.00;PWM: 5.08 | RPM: 0.00;PWM: 5.18 | RPM: 0.00;PWM: 5.28 | RPM: 0.00;PWM: 5.38 | RPM: 0.00;PWM: 5.47 | RPM: 0.00;PWM: 5.57 | RPM: 0.00;PWM: 5.67 | RPM: 0.00;PWM: 5.77 | RPM: 0.00;PWM: 5.87 | RPM: 0.00;PWM: 5.96 | RPM: 0.00;PWM: 6.06 | RPM: 0.00;PWM: 6.16 | RPM: 0.00;PWM: 6.26 | RPM: 0.00;PWM: 6.35 | RPM: 0.00;PWM: 6.45 | RPM: 0.00;PWM: 6.55 | RPM: 0.00;PWM: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
6.67;PWM: 97.85 | RPM: 786.67;PWM: 97.95 | RPM: 800.00;PWM: 98.04 | RPM: 813.33;PWM: 98.14 | RPM: 820.00;PWM: 98.24 | RPM: 836.67;PWM: 98.34 | RPM: 836.67;PWM: 98.44 | RPM: 846.67;PWM: 98.53 | RPM: 856.67;PWM: 98.63 | RPM: 863.33;PWM: 98.73 | RPM: 860.00;PWM: 98.83 | RPM: 873.33;PWM: 98.92 | RPM: 873.33;PWM: 99.02 | RPM: 896.67;PWM: 99.12 | RPM: 883.33;PWM: 99.22 | RPM: 886.67;PWM: 99.32 | RPM: 880.00;PWM: 99.41 | RPM: 886.67;PWM: 99.51 | RPM: 876.67;PWM: 99.61 | RPM: 880.00;PWM: 99.71 | RPM: 883.33;PWM: 99.80 | RPM: 886.67;PWM: 99.90 | RPM: 893.33;PWM: 100.00 | RPM: 890.00;-*-*-*-Finalizado Crecrescente-*-*-*-
PWM: 100.00 | RPM: 873.33;PWM: 99.90 | RPM: 850.00;PWM: 99.80 | RPM: 826.67;PWM: 99.71 | RPM: 826.67;PWM: 99.61 | RPM: 886.67;PWM: 99.51 | RPM: 896.67;PWM: 99.41 | RPM: 890.00;PWM: 99.32 | RPM: 883.33;PWM: 99.22 | RPM: 896.67;PWM: 99.12 | RPM: 886.67;PWM: 99.02 | RPM: 906.67;PWM: 98.92 | RPM: 890.00;PWM: 98.83 | RPM: 886.67;PWM: 98.73 | RPM: 883.33;PWM: 98.63 | RPM: 870.00;PWM: 98.53 | RPM: 876.67;PWM: 98.44 | RPM: 873.33;PWM: 98.34 | RPM: 863.33;PWM: 98.24 | RPM: 843.33;PWM: 98.14 | RPM: 806.67;PWM: 98.04 | RPM: 713.33;PWM: 97.95 | RPM: 543.33;PWM: 97.85 | RPM: 440.00;PWM: 97.75 | RPM: 350.00;PWM: 97.65 | RPM: 316.67;PWM: 97.56 | RPM: 313.33;PWM: 97.46 | RPM: 316.67;PWM: 97.36 | RPM: 320.00;PWM: 97.26 | RPM: 526.67;PWM: 97.17 | RPM: 823.33;PWM: 97.07 | RPM: 843.33;PWM: 96.97 | RPM: 830.00;PWM: 96.87 | RPM: 830.00;PWM: 96.77 | RPM: 826.67;PWM: 96.68 | RPM: 823.33;PWM: 96.58 | RPM: 823.33;PWM: 96.48 | RPM: 823.33;PWM: 96.38 | RPM: 823.33;PWM: 96.29 | RPM: 816.67;PWM: 96.19 | RPM: 810.00;PWM: 96.09 | RPM: 806.67;PWM: 95.99 | RPM: 813.33;PWM: 95.89 | RPM: 810.00;PWM: 95.80 | RPM: 810.00;PWM: 95.70 | RPM: 806.67;PWM: 95.60 | RPM: 813.33;PWM: 95.50 | RPM: 803.33;PWM: 95.41 | RPM: 800.00;PWM: 95.31 | RPM: 803.33;PWM: 95.21 | RPM: 796.67;PWM: 95.11 | RPM: 793.33;PWM: 95.01 | RPM: 793.33;PWM: 94.92 | RPM: 786.67;PWM: 94.82 | RPM: 793.33;PWM: 94.72 | RPM: 786.67;PWM: 94.62 | RPM: 793.33;PWM: 94.53 | RPM: 786.67;PWM: 94.43 | RPM: 780.00;PWM: 94.33 | RPM: 783.33;PWM: 94.23 | RPM: 780.00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
3 | RPM: 0.00;PWM: 3.13 | RPM: 0.00;PWM: 3.03 | RPM: 0.00;PWM: 2.93 | RPM: 0.00;PWM: 2.83 | RPM: 0.00;PWM: 2.74 | RPM: 0.00;PWM: 2.64 | RPM: 0.00;PWM: 2.54 | RPM: 0.00;PWM: 2.44 | RPM: 0.00;PWM: 2.35 | RPM: 0.00;PWM: 2.25 | RPM: 0.00;PWM: 2.15 | RPM: 0.00;PWM: 2.05 | RPM: 0.00;PWM: 1.96 | RPM: 0.00;PWM: 1.86 | RPM: 0.00;PWM: 1.76 | RPM: 0.00;PWM: 1.66 | RPM: 0.00;PWM: 1.56 | RPM: 0.00;PWM: 1.47 | RPM: 0.00;PWM: 1.37 | RPM: 0.00;PWM: 1.27 | RPM: 0.00;PWM: 1.17 | RPM: 0.00;PWM: 1.08 | RPM: 0.00;PWM: 0.98 | RPM: 0.00;PWM: 0.88 | RPM: 0.00;PWM: 0.78 | RPM: 0.00;PWM: 0.68 | RPM: 0.00;PWM: 0.59 | RPM: 0.00;PWM: 0.49 | RPM: 0.00;PWM: 0.39 | RPM: 0.00;PWM: 0.29 | RPM: 0.00;PWM: 0.20 | RPM: 0.00;PWM: 0.10 | RPM: 0.00;PWM: 0.00 | RPM: 0.00;-*-*-*-Finalizado Decrescente-*-*-*-
