MuriloVAlves/TG/Docs/TG_IAR_Dissertacao/capitulos/Metodologia.tex

\chapter{Metodologia}\label{cap:metod}
Após a apresentação do referencial teórico utilizado neste projeto, serão discutidos os componentes e equipamentos necessários para criar um protótipo funcional.
Nas seções seguintes, será explicado como se deu a seleção de determinados softwares de rastreio, softwares de simulação, peça mecânica, componente eletrônico, ou ações tomadas para a criação do protótipo.

\section{Software de Rastreio e Decodificação}\label{sec:software}
O aplicativo de rastreio de satélites principal selecionado para o trabalho é o SatDump.
Esse programa foi utilizado porque ele possui um conglomerado de ferramentas para permitir o rastreio de satélites e a decodificação dos sinais recebidos pela antena da estação de solo.
Na Figura \ref{fig:satdump}, é possível observar a interface do Software. O software está dividido em duas partes principais: o painel de controle/rastreio (à esquerda) e o analisador de espectro/cachoeira RF (à direita).

\begin{figure}[htbp]
    \centering
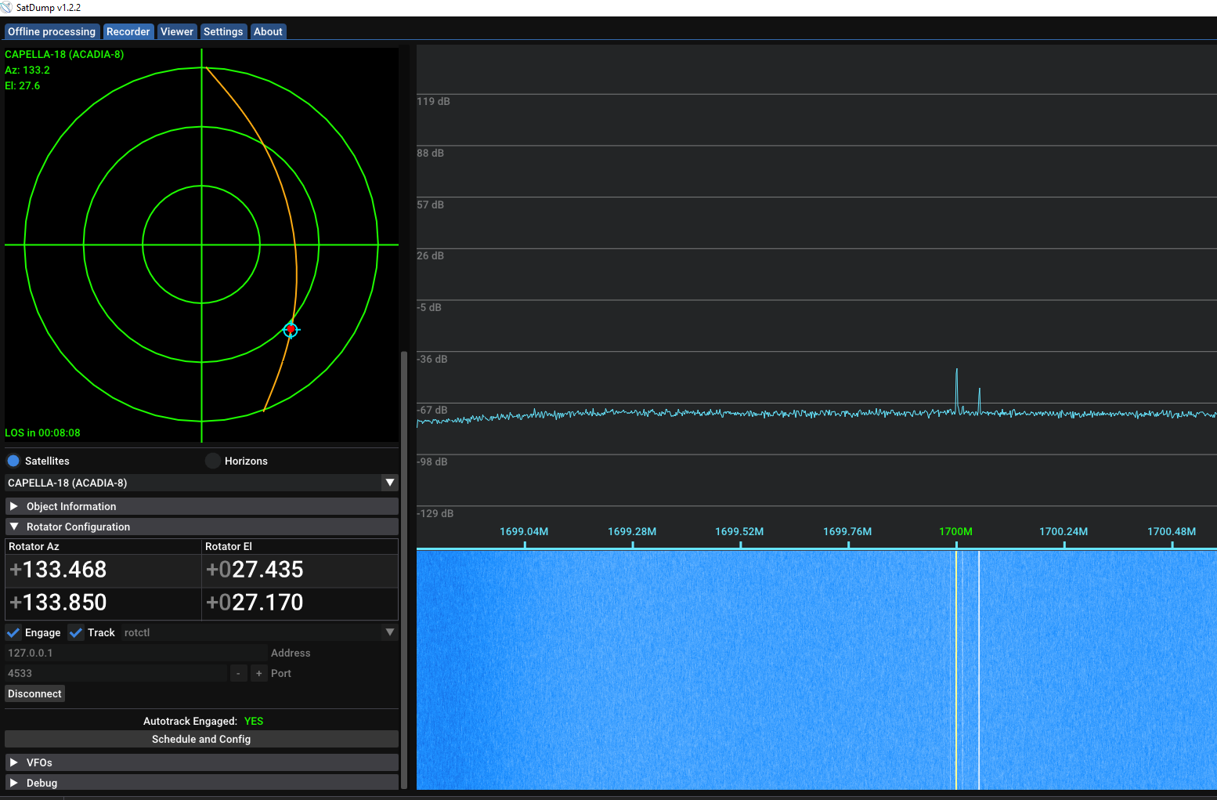
[picture p1: Docs/TG_IAR_Dissertacao/figs/satdump_example.png]
    
    \caption{Interface do software SatDump}
    \legend{Fonte: Autor(2026)}
    \label{fig:satdump}
\end{figure}

Na região esquerda, detalhada na Figura \ref{fig:satdump_track_ui}, existe uma roda polar no topo, que indica algumas informações sobre o satélite rastreado. O texto acima da roda indica o satélite que está sendo rastreado (no caso, o CAPELLA-18), além de suas informações de azimute e elevação.
Abaixo do texto, está a roda polar de fato. A roda polar é uma representação bidimensional de 360° de toda a abóbada celeste visível a partir da localização da estação em solo. O centro do círculo, onde há a intersecção dos eixos, representa o Zênite (elevação de $90^{\circ}$), enquanto os círculos concêntricos indicam as elevações intermediárias de $0^{\circ}$, $30^{\circ}$ e $60^{\circ}$ (do mais externo para o mais interno).
A cruz interna representa a direção cardeal, ou seja, em qual direção do horizonte a antena deve apontar. A seção superior da cruz indica $0/360^{\circ}$, representando o Norte, e o ângulo de azimute é crescente no sentido horário. Seguindo, a linha direita indica $90^{\circ}$ (Leste), a linha inferior indica $180^{\circ}$ (Sul), e a linha esquerda indica $270^{\circ}$ (Oeste).
A linha amarela representa todo o arco que o satélite faz durante essa passagem. O ponto vermelho indica a posição real do satélite. O ícone de mira azul indica a posição que foi passada ao rotor da antena, enquanto o círculo azul representa a posição que o rotor acusa estar.
Mais abaixo há um texto com a informação de tempo estimado até ocorrer a LOS (Loss of signal, ou perda de sinal) do satélite quando este se encontrar abaixo do horizonte.
Na seção de nome "Rotator Configuration" (configuração de rotor), esta área está destinada à conexão do programa com o rotor. Os números de azimute e elevação da linha superior é a posição teórica onde o satélite está, calculada com base nas informações de órbita e a posição da estação de solo.
A linha inferior indica a posição real de apontamento da antena indicada pelo rotor. Abaixo disso, há a configuração do servidor de controle dos rotores, na qual estão configurados o endereço de IP e a porta para a comunicação. Além disso, existem as opções de "Engage" (engajar), que inicia a conexão com servidor, e "Track" (rastrear), que envia posições atualizadas ao mecanismo de apontamento.
\begin{figure}[htbp]
    \centering
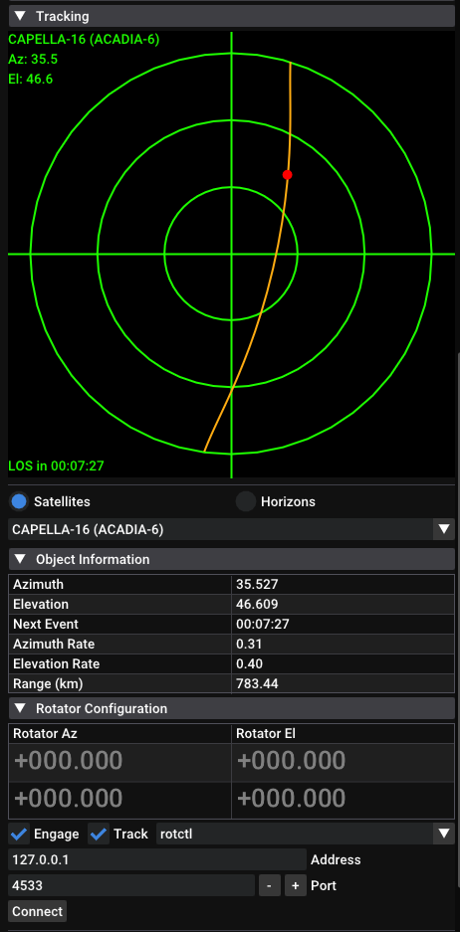
[picture p2: Docs/TG_IAR_Dissertacao/figs/satdump_track_screen.png]
    
    \caption{Interface de Rastreio do SatDump}
    \legend{Fonte: Autor(2026)}
    \label{fig:satdump_track_ui}
\end{figure}

A região direita é dedicada ao processamento e à representação visual do sinal de radiofrequência (RF) recebido pelo aplicativo. Este painel fornece diagnóstico em tempo real da qualidade do enlace de comunicação e é composto por dois elementos gráficos fundamentais alinhados no domínio da frequência: o Analisador de Espectro e o Exibidor em Cachoeira (Waterfall).
O gráfico superior exibe a densidade de potência do sinal capturado em função da frequência, calculada por meio da Transformada Rápida de Fourier (FFT). Seu eixo vertical representa a amplitude (em \text{dB}, decibel) do sinal recebido para cada frequência, enquanto o eixo horizontal indica a frequência em $\text{MHz}$.
O gráfico inferior é conhecido como visualizador em cachoeira representa a variação observada no gráfico acima em função do tempo (eixo y). Esse visualizador é atualizado com as informações mais novas sendo inseridas em cima e as mais antigas "deslizando" para regiões mais abaixo. Esse gráfico é mapeado por cores, nos quais cores próximas ao azul indicam uma intensidade baixa, enquanto cores próximas ao vermelho indicam uma maior intensidade de sinal recebida.
Em geral, essa interface é utilizada para garantir a estabilidade da transmissão durante a passagem, além de permitir observar variações na largura do sinal ou desvios na frequência central da linha ao longo do rastreio.

O aplicativo foi selecionado por concentrar todas as informações necessárias para realizar o rastreio e a decodificação do sinal recebido.
O software integra a informação de rastreio de satélites com o recebimento de sinais de rádio (descrito na seção \ref{sec:sistema_comunicacao}) e a decodificação da imagem em um único lugar.
Isso permite uma grande possibilidade de automatização dos processos de captura e decodificação, permitindo que o sistema realize o rastreio e a geração da imagem correspondente sem a necessidade de passos que envolvam uma pessoa responsável pelos passos intermediários.
Apesar do software SatDump possuir todas as integrações necessárias para o rastreio, o usuário tem a opção de selecionar outros softwares para o controle do sistema, já que este é compatível com a principal biblioteca de controle de rotores.

\section{Atuadores}\label{sec:motor_passo}
O sistema de controle da antena foi baseado em um pedestal convencional controlado por dois parâmetros ortogonais principais, sendo estes: azimute e elevação.
Para efetuar o controle desses fatores em uma antena, serão necessários dois motores que atuarão modificando
os ângulos mencionados anteriormente. Como discutido na seção \ref{sec:ground_tracking}, o movimento do azimute pode apontar para todos os 360 graus, enquanto o
mecanismo de elevação atua somente em 90 graus. Desta maneira, o ângulo de visada total do mecanismo
é dado por uma meia-esfera superior. Essa geometria é considerada suficiente para a detecção e o rastreio de qualquer satélite necessário pela estação de solo.

Os motores de passo utilizados no trabalho são de classe NEMA (National Electrical Manufacturers Association, Associação Nacional de Fabricantes de Equipamentos Elétricos), que padroniza as dimensões e as características de motores em geral. O modelo selecionado é o motor de passo 17HS4401, da classe NEMA 17 (vistos na Figura \ref{fig:motores_drivers}).
Ele possui ângulo de passo de $1.8^{\circ}\pm5\%$, torque de $4,2\text{kgf}\cdot\text{cm}$, e corrente por fase de $1,5A$.
\begin{figure}[htbp]
    \centering
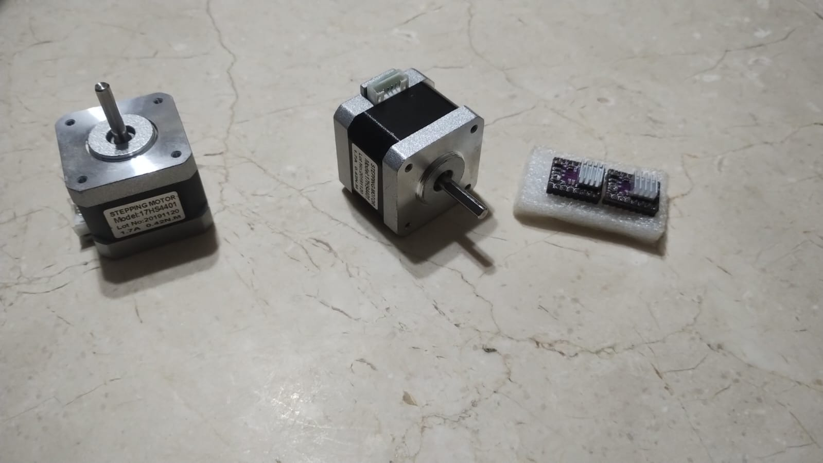
[picture p3: Docs/TG_IAR_Dissertacao/figs/motores_drivers.jpeg]
    
    \caption{Motores 17HS4401 e drivers DRV8825}
    \legend{Fonte: Autor(2026)}
    \label{fig:motores_drivers}
\end{figure}

Para o acionamento dos motores, serão utilizados drivers dedicados DRV8825, configurados para conseguirem atingir a resolução de $1/32$ passo, permitindo elevar a resolução angular teórica de acionamento dos motores para $0{,}05625^\circ$ por micropasso.
A calibração da posição inicial (homing) dos eixos de azimute e elevação é realizada por meio de sensores ópticos, que serão desenvolvidos a partir de LDRs e LEDs. O controlador executa um algoritmo de varredura para verificar quando o LDR receberá a maior intensidade luminosa. Esse valor máximo indicará o zero do azimute e da elevação.
O acoplamento entre o eixo dos motores e a estrutura da antena foi feito utilizando um sistema de redução por correias de padrão GT2 de relação 2:1, fazendo com que a resolução real na estrutura seja metade da resolução angular desenvolvida pelo motor.

\section{Sistema de Comunicação}\label{sec:sistema_comunicacao}
Para o recebimento do sinal de satélite, foi utilizando um rádio definido por software (Software Defined Radio, ou SDR), de modelo RTL-SDR V4. Esse dispositivo é capaz de ser programado via software para sintonizar com diversas frequências sem modificação de hardware, tornando-o extremamente versátil para receber comunicação de diversos satélites.
O modelo em questão é capaz de operar em frequências de \SI{500}{\kilo\hertz} a \SI{1766}{\mega\hertz}. Além disso, há um circuito Bias-Tee interno ativável por software, que é capaz de fornecer uma tensão contínua de 4,5 V no conector SMA para alimentação de pré-amplificadores localizados na linha de transmissão utilizando o mesmo cabo coaxial por onde o sinal é recebido.

Devido à extrema atenuação sofrida pelos sinais emitidos pelos satélites ao se propagarem através da atmosfera até a antena de recepção, foi utilizado um módulo pré-amplificador e filtro Nooelec SAWBird+ GOES.
O módulo é composto por dois estágios de amplificação de baixo ruído (LNA) em cascata com um filtro de Onda Acústica de Superfície (SAW) intercalado. Esses componentes são responsáveis por tratar, filtrar e amplificar os sinais recebidos pela antena.
O conjunto apresenta frequência central em aproximadamente \SI{1688}{\mega\hertz}, com banda passante ajustada para a recepção de \SI{1694,1}{\mega\hertz} e ganho típico de 35 dB, reduzindo interferências de sinais fora da faixa de interesse e compensando as perdas de transmissão.

Todo o sistema foi montado dentro do cabo da antena, com um cabo extensor USB de \SI{2}{\meter} para realizar a conexão com o computador. O sistema de recepção está representado na Figura \ref{fig:sistema_coms}.

\begin{figure}[htbp]
    \centering
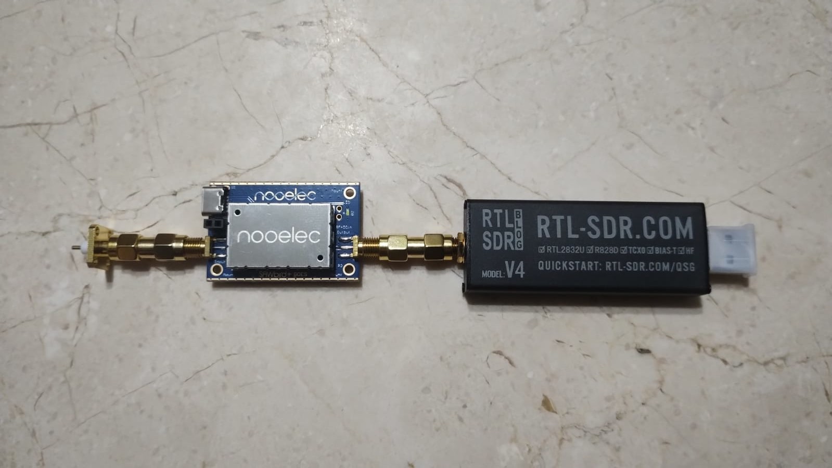
[picture p4: Docs/TG_IAR_Dissertacao/figs/sistema_comunicacao.jpeg]
    
    \caption{Sistema de comunicação com ponto de alimentação da antena (dourado) à esquerda, filtro Nooelec (azul) ao centro e SDR (preto) à direita}
    \legend{Fonte: Autor(2026)}
    \label{fig:sistema_coms}
\end{figure}

\section{Antena}\label{sec:antena}

\begin{figure}[htbp]
    \centering
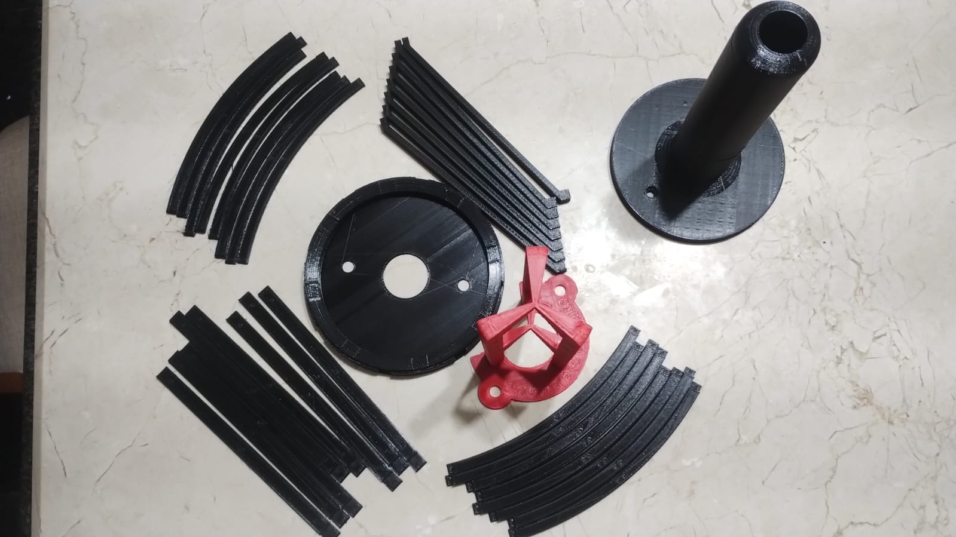
[picture p5: Docs/TG_IAR_Dissertacao/figs/antena_peças.jpeg]
    
    \caption{Peças que formam a estrutura da antena, feitas com o auxílio de uma impressora 3D}
    \legend{Fonte: Autor(2026)}
    \label{fig:pecas_antena}
\end{figure}

A antena utilizada foi apresentada inicialmente no projeto de \cite{tonito2024}. Esta é uma Antena Helicone projetada especificamente para a recepção de sinais de alta resolução de satélites meteorológicos na faixa de 1,7 GHz, desenvolvida para a captura de imagens enviadas no modo HRPT (High Resolution Picture Transmission).
Este modelo combina a simplicidade construtiva com características eletromagnéticas de alto ganho e alta diretividade, sendo ideal tanto para uso  montado no sistema de rastreio automatizado desenvolvido nesse trabalho.
A antena helicone é uma variação da antena helicoidal no modo axial combinada com um plano Terra (ground plane) levemente cônico.
Como as peças desenvolvidas por \cite{tonito2024} foram feitas para serem manufaturadas com o auxílio de uma impressora 3D, vide Figura \ref{fig:pecas_antena}, é possível iterar rapidamente no design das peças, permitindo a fabricação rápida de novos componentes caso um venha a quebrar.
Além disso, como as peças serão fabricadas em plástico, é esperado que elas tenham um peso menor que o equivalente em metal.

A seleção de uma antena de geometria helicoidal foi feita para garantir uma melhor recepção do sinal, já que satélites que transmitem em HRPT operam majoritariamente com Polarização Circular (normalmente RHCP — Right-Hand Circular Polarization).
Uma antena em formato de hélice garante o casamento de polarização correto com a onda incidente, evitando perdas severas de sinal por descasamento de polarização (Polarization Mismatch Loss), comuns em antenas de polarização linear em movimento.
Quando a circunferência de cada volta da hélice é próxima ao comprimento de onda da frequência central ($\mathbf{C \approx \lambda}$), a antena passa a emitir e receber no modo axial.
Nesse regime, o feixe de radiação principal fica concentrado na direção do eixo da hélice. O comprimento de onda da onda eletromagnética pode ser calculado utilizando a velocidade da luz no vácuo e a frequência de operação da antena, conforme exemplificado na equação \eqref{eq:calculo_lambda} para os parâmetros usados na antena do projeto.
\begin{equation}
    \lambda = \frac{c}{f} = \frac{3 \times 10^8\text{ m/s}}{1,7 \times 10^9\text{ Hz}} \approx 176,4\text{ mm}\label{eq:calculo_lambda}
\end{equation}
Com o diâmetro da hélice do projeto fixado em torno de $56\text{ mm}$, a circunferência $C = \pi \cdot d = \pi \cdot 56\text{ mm} \approx 175,9\text{ mm}$, o que corresponde ao regime do modo axial da antena.

\section{Sistema Embarcado}\label{sec:sistema_embarcado}
Com o intuito de manter o servidor de controle do rotor embarcado no pedestal, foi utilizado um microcontrolador de modelo de desenvolvimento ESP32 WROOM-32, observado no lado esquerdo da Figura \ref{fig:embarcados_pecas}, e com seu manual técnico disponível na referência \cite{espressif2026esp32tech}.
Além disso, para manter uma interface gráfica disponível para fácil entendimento de seu operador, o sistema conta com um display de LCD (Liquid Crystal Display, ou tela de cristal líquido) para mostrar telemetria de apontamento e informações de conexão.
\begin{figure}[htbp]
    \centering
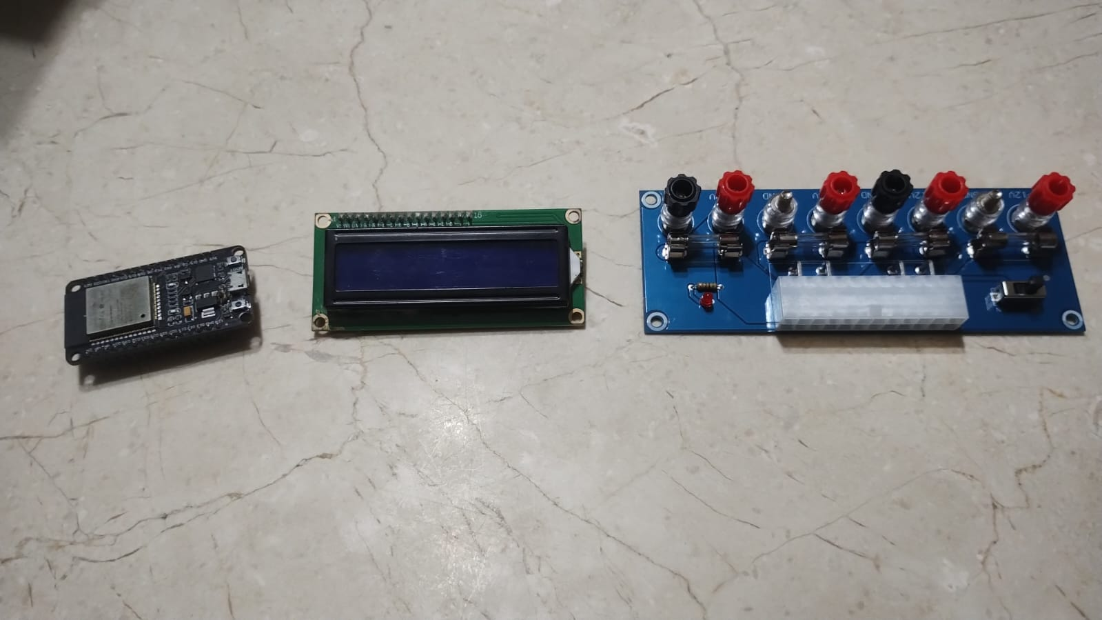
[picture p6: Docs/TG_IAR_Dissertacao/figs/embarcados_peças.jpeg]
    
    \caption{Componentes parte do sistema embarcado, sendo o ESP32 (esquerda), display de LCD (centro), e adaptador de fonte 24 pinos de computador (direita).}
    \legend{Fonte: Autor(2026)}
    \label{fig:embarcados_pecas}
\end{figure}

A arquitetura do sistema foi desenvolvida aproveitando a estrutura dual-core do ESP32, permitindo o processamento paralelo de tarefas por meio do FreeRTOS (Real-Time Operating System), cujo manual é disponibilizado pela empresa Espressif \citeyear{espressif2026}.
Esse sistema operacional em tempo real e de código aberto permite a divisão do programa em tarefas independentes, alocadas em cada um dos núcleos do microcontrolador.
A carga de trabalho do projeto está dividida da seguinte maneira: o núcleo 0 (vindo da contagem a partir da base 0) é responsável por toda a interface de comunicação, sendo essas o controle do servidor TCP e a interface com o LCD, enquanto o núcleo 1 é responsável pelo controle do motor e do filtro $\alpha-\beta-\gamma$ embarcado (exemplificado no diagrama da Figura \ref{fig:divisao_tarefas_esp}).
Dessa forma, essa arquitetura garante que um processador esteja exclusivamente destinado ao controle das malhas do motor, evitando que interferências ou latências de comunicação afetem a estabilidade e a precisão do rotor.

\begin{figure}[htbp]
    \centering
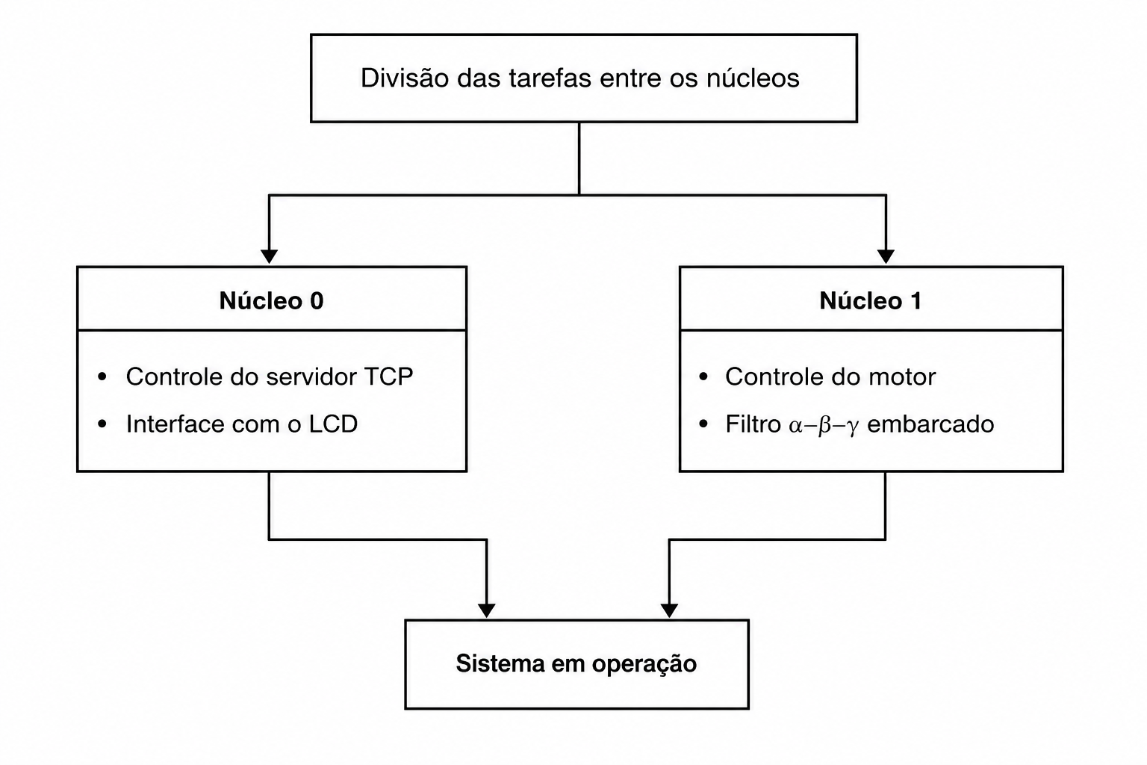
[picture p7: Docs/TG_IAR_Dissertacao/figs/divisao_tarefas_nucleos_esp.png]
    
    \caption{Diagrama de divisão de tarefas entre os núcleos do microcontrolador.}
    \legend{Fonte: Autor(2026)}
    \label{fig:divisao_tarefas_esp}
\end{figure}

\section{Implementação do Filtro Preditor}\label{sec:implementacao_filtro}
Para determinar os parâmetros do filtro preditor embarcado no processador, foram feitos alguns testes a partir de um servidor \textit{dummy} (simulado) em um computador. Esse servidor era encarregado de receber todos os comandos enviados pelo software e catalogar as posições esperadas em diversos rastreios.
As capturas serão realizadas através de diversos dias, garantindo uma grande variação nas órbitas obtidas.
A partir desses dados, foi desenvolvido um algoritmo capaz de utilizar os valores dentro do limite de estabilidade discutido na seção \ref{sec:estimation} para encontrar o filtro cujos parâmetros geram o menor Erro Quadrático Médio (EQM ou MSE, na sigla em inglês).
Esse algoritmo altera os parâmetros alfa, beta e gama de acordo com um certo passo determinado e expõe todos os filtros aos mesmos dados, garantindo que a entrada não tenha um viés e os filtros estejam expostos às mesmas condições.
Com o Erro Quadrático Médio calculado para cada parâmetro, é possível estipular valores para o $\alpha$, $\beta$ e $\gamma$ que obtenha o melhor resultado preditivo de forma generalizada.
A partir do melhor resultado obtido pelo cálculo do Erro Quadrático Médio, um segundo algoritmo irá procurar valores melhores para o filtro utilizando a vizinhança do ponto como base. Isso permitirá encontrar um valor ótimo para o filtro $\alpha-\beta-\gamma$ de forma estocástica.
Deste modo, esses parâmetros calibrados serão embarcados na arquitetura do sistema apresentada na Seção \ref{sec:sistema_embarcado}.

\section{Controle de Velocidade e posição do Motor de Passo}\label{sec:controle_motor_passo}
A posição da estrutura é determinada de forma incremental a partir da posição inicial do motor, da relação de transmissão do sistema e da contagem dos pulsos emitidos pelo driver.
Embora o driver DRV8825 suporte frequências de pulso elevadas (de até aproximadamente 250 kHz), a resposta dinâmica dos motores de passo NEMA é mais restrita, limitando sua operação contínua a frequências na faixa de 1000 Hz.
Portanto, o controlador deve gerar sinal em uma frequência compatível com o motor, aproveitando a capacidade de micropasso (microstepping) do driver para aumentar a resolução e suavizar o deslocamento.
A partir dos valores de posição, velocidade e aceleração estimados pelo filtro $\alpha-\beta-\gamma$, o sistema calcula posições intermediárias preditas e determina as tensões necessárias em cada bobina do motor para realizar tal ação.
Essa interpolação reduz trancos na estrutura e garante um alinhamento mais estável e contínuo com o satélite.
