MuriloVAlves/TG/Docs/TG_IAR_Dissertacao/pretextual/capa.tex

% ---
% Impressão da Capa
% ---
  \begin{capa}%
    \begin{figure}[h!]%
        \centering%
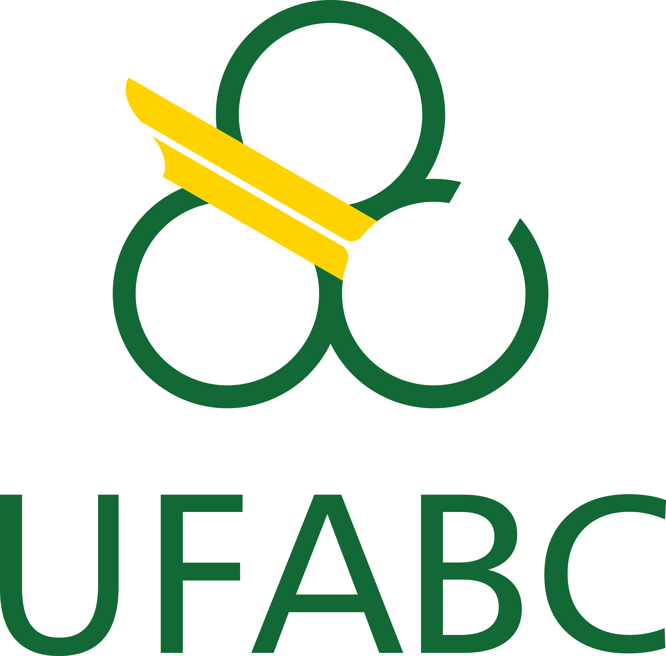
[picture p8: Docs/TG_IAR_Dissertacao/figs/logo.png]
        %
      \end{figure}%
    \center
	\ABNTEXchapterfont\large{Universidade Federal do ABC \\ Centro de Engenharia, Modelagem e Ciências Sociais Aplicadas \\ Programa de Graduação em Engenharia de Instrumenta{\c c}\~ao, Automação e Robótica}
	%\vspace{1.5cm}

    \vfill
    \ABNTEXchapterfont\bfseries\LARGE\imprimirtitulo
    \vfill

	%\vfill
	\ABNTEXchapterfont\large\imprimirautor
	\vfill
%
	
    \large\imprimirlocal, \large\imprimirdata

    \vspace*{1cm}
  \end{capa}
% ---
