MuriloVAlves/TG/Docs/TG_IAR_Dissertacao/dissertacao.tex

% ---------------------------------------------------------------------------
% ---------------------------------------------------------------------------
% Junção de templates encontrados no Overleaf
% facilitando a vida do aluno de pós da UFABC
% Modelo LaTex para preparação do documento final de Dissertação de Mestrado
% ninguém do programa de pós da informação validou se presta
% ---------------------------------------------------------------------------
% ---------------------------------------------------------------------------

\documentclass[
	% -- opções da classe memoir --
	12pt,					% tamanho da fonte
	openright,				% capítulos começam em pág ímpar (insere página vazia caso preciso)
	oneside,					% para impressão em verso e anverso. Oposto a oneside
	a4paper,					% tamanho do papel. 
	% -- opções da classe abntex2 --
	%chapter=TITLE,			% títulos de capítulos convertidos em letras maiúsculas
	%section=TITLE,			% títulos de seções convertidos em letras maiúsculas
	%subsection=TITLE,		% títulos de subseções convertidos em letras maiúsculas
	%subsubsection=TITLE,	% títulos de subsubseções convertidos em letras maiúsculas
	% -- opções do pacote babel --
	english,					% idioma adicional para hifenização
	%french,					% idioma adicional para hifenização
	%spanish,				% idioma adicional para hifenização
	brazilian				% o último idioma é o principal do documento
	]{abntex2}

% ---------------------
% Pacotes OBRIGATÓRIOS
% ---------------------
\usepackage{lmodern}				% Usa a fonte Latin Modern			
\usepackage[T1]{fontenc}			% Selecao de codigos de fonte.
\usepackage[utf8]{inputenc}		% Codificacao do documento (conversão automática dos acentos)
\usepackage{lastpage}			% Usado pela Ficha catalográfica
\usepackage{indentfirst}			% Indenta o primeiro parágrafo de cada seção.
\usepackage{color}				% Controle das cores
\usepackage{graphicx}			% Inclusão de gráficos
\usepackage{caption}
\usepackage{subcaption}
\usepackage{microtype} 			% Melhorias de justificação
% ---------------------
		
% ---------------------
% Pacotes ADICIONAIS
% ---------------------
\usepackage{lipsum}						% Geração de dummy text
\usepackage{amsmath,amssymb,mathrsfs}	% Comandos matemáticos avançados 
\usepackage{setspace}  					% Para permitir espaçamento simples, 1 1/2 e duplo
\usepackage{verbatim}					% Para poder usar o ambiente "comment"
\usepackage{tabularx} 					% Para poder ter tabelas com colunas de largura auto-ajustável
\usepackage{afterpage} 					% Para executar um comando depois do fim da página corrente
\usepackage{url} 						% Para formatar URLs (endereços da Web)
% ---------------------

% ---------------------
% Pacotes de CITAÇÕES
% ---------------------
% \usepackage[brazilian,hyperpageref]{backref}	% Paginas com as citações na bibl
% \usepackage[alf]{abntex2cite}				% Citações padrão ABNT (alfa)
%\usepackage[num]{abntex2cite}				% Citações padrão ABNT (numericas)
% ---------------------
% \usepackage[style=authoryear,backend=biber]{biblatex}
\usepackage{siunitx}
\usepackage[style=abnt, backend=biber]{biblatex}
\addbibresource{bibliografia.bib} % Verifique se o nome do seu arquivo .bib é este
\usepackage{csquotes}
\usepackage{float}
% Configurações de CITAÇÕES para abntex2
\input{extras/conf_citacoes}

% Inclusão de dados para CAPA e FOLHA DE ROSTO (título, autor, orientador, etc.)
\input{extras/dados}

% Inclui Configurações de aparência do PDF Final
\input{extras/conf_pdf}

% O tamanho da identação do parágrafo é dado por:
\setlength{\parindent}{1.3cm}

% Controle do espaçamento entre um parágrafo e outro:
\setlength{\parskip}{0.2cm}  % tente também \onelineskip

% ---------------------
% Compila o indice
% ---------------------
% \makeindex
% ---------------------

%%%%%%%%%%%%%%%%%%%%%%%%%%%
%%  INICIO DO DOCUMENTO  %%
%%%%%%%%%%%%%%%%%%%%%%%%%%%
\begin{document}

% Retira espaço extra obsoleto entre as frases.
\frenchspacing

% ----------------------------------------------------------
% ELEMENTOS PRÉ-TEXTUAIS (Capa, Resumo, Abstract, etc.)
% ----------------------------------------------------------
\pretextual

% Capa
\input{pretextual/capa}

% Folha de rosto (o * indica que haverá a ficha bibliográfica)
\imprimirfolhaderosto*

% Imprimir Ficha Catalografica
\input{pretextual/catalografica}

% Inserir Folha de Aprovação
% \input{pretextual/assinaturas}

% Dedicatória
\input{pretextual/dedicatoria}

% Agradecimentos
\input{pretextual/agradecimentos}

% Epígrafe
\input{pretextual/epigrafe}

% Resumo e Abstract
\input{pretextual/resumos}
\newpage

% Lista de ilustrações
\pdfbookmark[0]{\listfigurename}{lof}
\listoffigures*
\cleardoublepage

% Lista de tabelas
\pdfbookmark[0]{\listtablename}{lot}
\listoftables*
\cleardoublepage

% ---
% LISTA DE ABREVIATURAS E SIGLAS
% ---
\begin{siglas}
  \item[D-H] Denavit-Hartenberg
  \item[EQM] Erro Quadrático Médio
  \item[ESP32] Microcontrolador de Sistema em Chip da Espressif Systems
  \item[FreeRTOS] \textit{Free Real-Time Operating System}
  \item[HRPT] \textit{High Resolution Picture Transmission}
  \item[LCD] \textit{Liquid Crystal Display} (Mostrador de Cristal Líquido)
  \item[LEO] \textit{Low-Earth Orbit} (Órbita Terrestre Baixa)
  \item[LNA] \textit{Low Noise Amplifier} (Amplificador de Baixo Ruído)
  \item[NEMA] \textit{National Electrical Manufacturers Association}
  \item[PWM] \textit{Pulse Width Modulation} (Modulação por Largura de Pulso)
  \item[RF] Radiofrequência
  \item[RMS] Root Mean Square (Erro Quadrático Médio em inglês)
  \item[SAW] \textit{Surface Acoustic Wave} (Onda Acústica de Superfície)
  \item[SDR] \textit{Software Defined Radio} (Rádio Definido por Software)
  \item[TCP] \textit{Transmission Control Protocol}
\end{siglas}

% ---
% LISTA DE SÍMBOLOS
% ---
\begin{simbolos}
  \item[$ \alpha $] Parâmetro de suavização de posição do filtro $\alpha-\beta-\gamma$
  \item[$ \beta $] Parâmetro de suavização de velocidade do filtro $\alpha-\beta-\gamma$
  \item[$ \gamma $] Parâmetro de suavização de aceleração do filtro $\alpha-\beta-\gamma$
  \item[$ \theta_i $] Ângulo da junta articulada $i$ nos parâmetros de Denavit-Hartenberg
  \item[$ d_i $] Deslocamento do elo ao longo do eixo $z_i$ na convenção D-H
  \item[$ a_i $] Comprimento do elo ao longo do eixo $x_i$ na convenção D-H
  \item[$ \alpha_i $] Ângulo de torção do elo no eixo $x_i$ na convenção D-H
  \item[$ f $] Frequência da onda de radiofrequência
  \item[$ T_s $] Período de amostragem do sistema de controle
\end{simbolos}

% Inserir o SUMÁRIO
\pdfbookmark[0]{\contentsname}{toc}
\tableofcontents*
\cleardoublepage

% ----------------------------------------------------------
% ELEMENTOS TEXTUAIS (Capítulos)
% ----------------------------------------------------------
\textual
% Elementos textuais com numeração arábica
\pagenumbering{arabic}
% Reinicia a contagem do número de páginas
\setcounter{page}{1}

% Inclui cada capitulo da Dissertação
\input{capitulos/introducao}
% \input{capitulos/estadodaarte}
\input{capitulos/Objetivos}
\input{capitulos/ReferencialTeorico}
\input{capitulos/Metodologia}

% PARTE - Define a divisão do documento em partes (Não é obrigatório)
%\part{Preparação da pesquisa}
%\input{capitulos/referencias}
%\input{capitulos/ferramentas}

% PARTE
%\part{Proposta}
%\input{capitulos/proposta}

% PARTE
%\part{Parte Final}
\input{capitulos/resultados}
\input{capitulos/conclusao}

% ----------------------------------------------------------
% ELEMENTOS PÓS-TEXTUAIS (Referências, Glossário, Apêndices)
% ----------------------------------------------------------
\postextual

% Referências bibliográficas
% \bibliographystyle{ieeetran}
% \bibliography{bibliografia}
\printbibliography

% Glossário (Consulte o manual)
%\glossary

% Apêndices
\input{postextual/apendices}

% Anexos
% \input{postextual/anexos}

% Índice remissivo (Consultar manual)
%\phantompart
%\printindex

\end{document}
