MuriloVAlves/TG/Docs/TG_IAR_Dissertacao/capitulos/ReferencialTeorico.tex

\chapter{Referencial Teórico}\label{cap:teo}
Nessa seção, serão estudadas formas de interpretar e modelar o sistema.
Para isso, primeiramente será estudado como o sistema deverá interpretar os valores de azimute e elevação, levando em conta sua posição no globo e a posição do satélite que será rastreado.
Em seguida, o pedestal será analisado utilizando parâmetros de Denavit-Hartenberg para modelar a movimentação dos componentes da antena em relação à sua base.
Por fim, serão investigados filtros de estimação e predição para permitir o melhor rastreio dos satélites.

\section{Referencial e Rastreio de Satélites}\label{sec:ground_tracking}
Para modelar o sistema, é necessário descrever o referencial e entender como a estação de solo e o satélite se localizam no espaço.
Segundo Soler e Eisemann \citeyear{soler1994}, utilizando um modelo esférico aproximado da Terra, conforme a Figura \ref{fig:modelagem_ang_visada}, e sabendo a localização de latitude $\phi_S$ e longitude $\lambda_S$ da antena na estação, é possível estipular a direção em azimute e elevação para o apontamento da antena.
O raio da Terra para o modelo esférico será considerado de $R=6371 km$ e a distância do satélite em relação ao centro do modelo será considerada como $r = R+h$, com $h$ sendo a altitude de sua órbita.
Pode-se obter a longitude $\lambda_S$ na qual o vetor $\vec{r}$ intercepta a superfície da Terra, sendo possível traçar um triângulo reto esférico e utilizar a lei dos cossenos para triângulos esféricos \eqref{eq:lei_cossenos_esferica} e obter a relação $\cos\gamma=\cos\phi_S\cos(\lambda_S-\lambda)$ \cite{soler1994}. A distância entre o satélite e a estação de solo é dada pela equação \eqref{eq:d_sat_solo} \cite{soler1994}.
\begin{align}
\cos(AB) = \cos(CA)\cos(CB)\label{eq:lei_cossenos_esferica} \\
d = r[1+(R/r)^2-2(R/r)\cos\gamma]^{1/2} \label{eq:d_sat_solo}
\end{align}
\begin{figure}[htbp]
    \centering
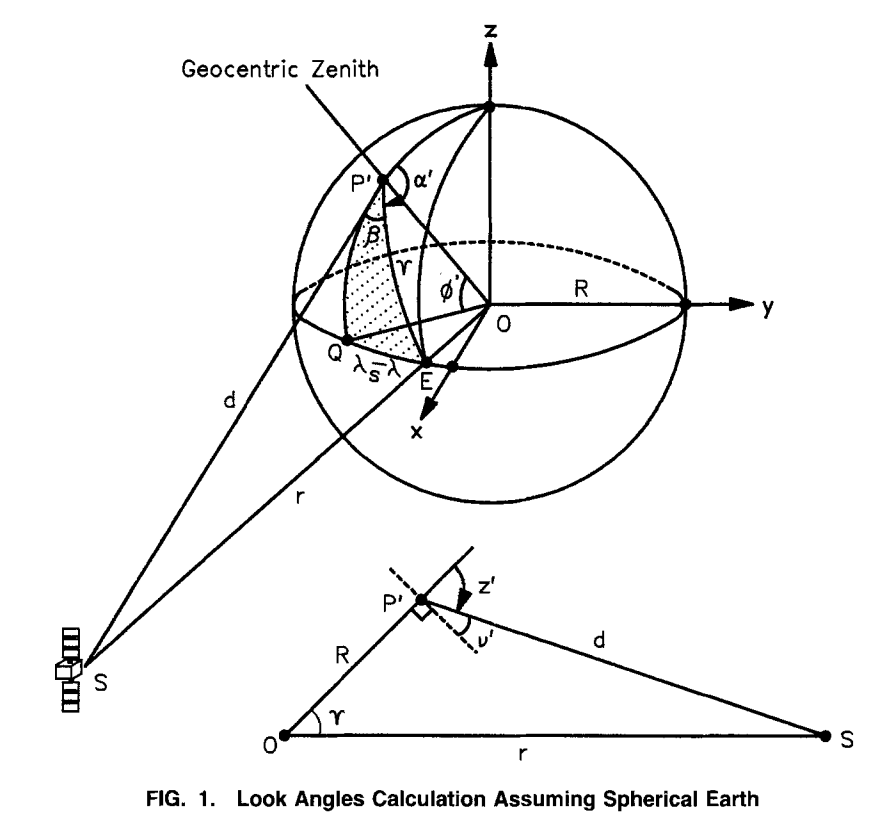
[picture p11: Docs/TG_IAR_Dissertacao/figs/Interpretacao_geodesica.png]
    
    \caption{Modelagem matemática do ângulo de visada}
    \legend{Fonte: \cite{soler1994}.}
    \label{fig:modelagem_ang_visada}
\end{figure}
A partir da equação \eqref{eq:d_sat_solo}, é possível calcular a elevação $\nu_S$ e o azimute $\beta_S$ do satélite em relação à estação de solo a partir das equações \eqref{eq:nu_s} e \eqref{eq:beta_s}.
\begin{align}
\nu_S = \arccos[(r/d)sin\gamma]\label{eq:nu_s} \\
\beta_S = \arccos(\cot\gamma\tan\phi_S)\label{eq:beta_s}
\end{align}

Essa modelagem foi feita considerando uma Terra esférica. Todavia, a Terra possui uma forma aproximada de um elipsoide de revolução. Embora o modelo esférico ofereça uma aproximação inicial simples, ele introduz erros no cálculo do ângulo de elevação (ou distância zenital).
O formato faz com que o modelo esférico tenha algumas discrepâncias com as posições reais. No entanto, como o escopo do trabalho não é o modelo da Terra, mas sim o sistema de controle de apontamento da antena, bastará dizer que há a dedução para o modelo elíptico na literatura de \cite{soler1994} caso necessária a consulta.
Além disso, é esperado que os aplicativos de rastreio de satélites com os quais o equipamento irá se comunicar sejam baseados nos modelos mais completos, enviando a posição de azimute e elevação correta para o alinhamento com o satélite.

Pode-se descrever o mecanismo de apontamento da antena do pedestal a partir de dois movimentos independentes ortogonais, sendo um de azimute e um de elevação.
O espaço de trabalho necessário para o acompanhamento contínuo de passagens de satélites corresponde ao hemisfério superior delimitado pelo horizonte local do plano tangente à estação de solo encontrado a 0$^\circ$ de elevação.
Para cobrir integralmente essa semiesfera, o mecanismo deve ser capaz de efetuar uma rotação completa de $0$ até $2\pi$ (0$^\circ$ até 360$^\circ$) em azimute (referenciado pelo ângulo $\theta$) e uma articulação de $0$ até $\frac{\pi}{2}$ (0$^\circ$ até 90$^\circ$) na elevação (referenciado pelo ângulo $\phi$), como é possível ver na Figura \ref{fig:horizonte_local}.
Embora existam diversos mecanismos que tenham seu ângulo de elevação encurtado, já que em baixas elevações há a obstrução de relevo, estruturas ou atmosfera, o mecanismo desenvolvido nesse trabalho garantirá a varredura de toda região angular teórica.
\begin{figure}[htbp]
    \centering
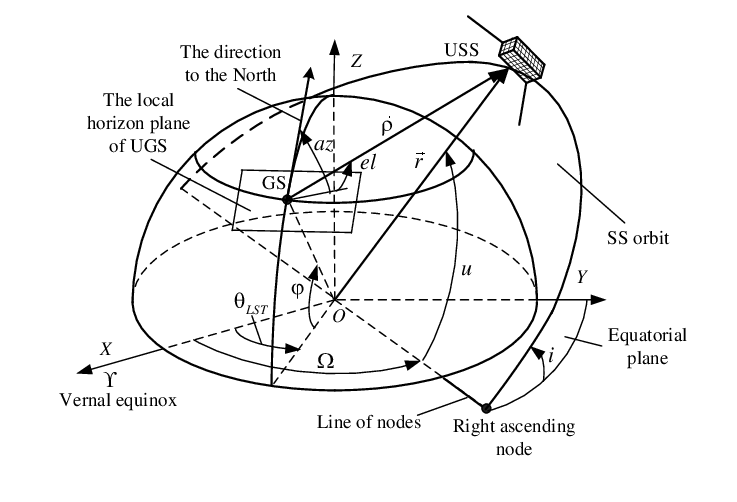
[picture p12: Docs/TG_IAR_Dissertacao/figs/horizonte_local.png]
    
    \caption{Ilustração de horizonte local visto pela estação de solo}
    \legend{Fonte: \cite{Spiridonov2020}.}
    \label{fig:horizonte_local}
\end{figure}
É importante salientar que a partir das próximas modelagens as variáveis $\theta$ e $\phi$ serão também utilizadas ao se referir ao azimute e à elevação do mecanismo da antena.

\section{Modelagem do Pedestal}\label{sec:modelagem_pedestal}
Segundo Ford \citeyear{Ford2008}, o sistema do pedestal que irá direcionar a antena pode ser modelado utilizando como base um manipulador esférico de dois graus de liberdade.
Utilizando o modelo pela Figura \ref{fig:pedestal}, e utilizando como referência a modelagem de \cite{Bien2021}, o ponto fixo que dará a referência do mecanismo com o solo será o da base, dado pelo referencial de coordenadas $O_0$, com versores $[x_0,y_0,z_0]$.
\begin{figure}[htbp]
    \centering
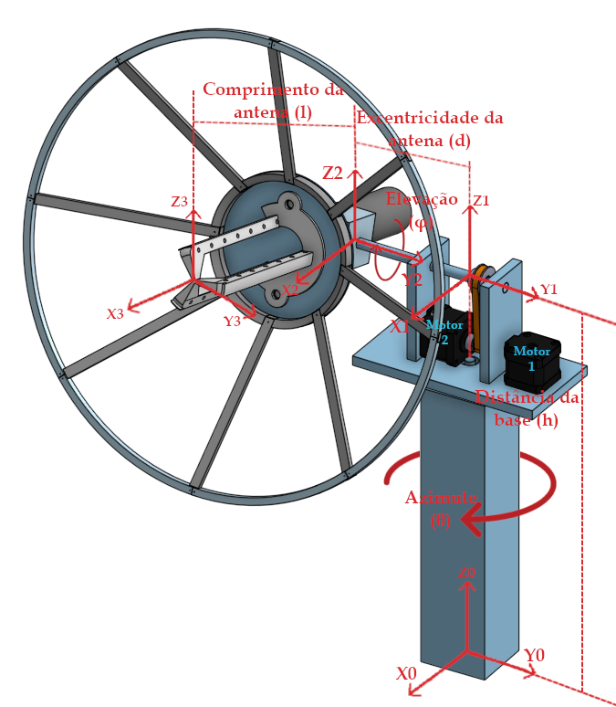
[picture p13: Docs/TG_IAR_Dissertacao/figs/pedestal_3D_motores.png]
    
    \caption{Modelo do pedestal com controle em azimute e elevação}
    \legend{Fonte: Elaborado pelo autor (2026).}
    \label{fig:pedestal}
\end{figure}

Um motor é ligado por uma polia à base da antena, permitindo a rotação em torno do eixo Z. O ângulo de rotação do azimute é dado por $\theta$.
O segundo motor está localizado na região na qual a antena se encaixa ao poste do pedestal e é ligado ao eixo da elevação também através do mecanismo de polia. A junção da polia movida com o eixo da elevação tem coordenadas dadas pela origem $O_1$ ($[x_1,y_1,z_1]$) e distância da base dada pelo valor "h".
Além dos referenciais motorizados, será utilizando mais um referencial para descrever a excentricidade da antena, dado por $O_2$ ($[x_2,y_2,z_2]$) e distância de excentricidade "d"; e a região mais extrema que representa a ponta da antena, encontrada em  $O_3$ ($[x_3,y_3,z_3]$) e distância de braço "l".
O modelo da cinemática direta do sistema pode ser obtido a partir dos parâmetros de Denavit-Hatenberg (D-H). Utilizando como referenciais $O_i$ descrita pelos versores de referencial $[x_i,y_i,z_i]$ obtendo a Tabela \ref{tab:params_d_h}
\begin{table}[htbp]
\centering
\caption{Tabela de parâmetros D-H para o sistema}
\begin{tabular}{rrrrr}
    \hline
    Parâmetro & $\theta_i$ & $d_i$ & $a_i$ & $\alpha_i$ \\
    \hline
    $O_0O_1$ & $\theta$ & h & 0 & $\frac{\pi}{2}$ \\
    $O_1O_2$ & $\phi$ & -d & 0 & 0 \\
    $O_2O_3$ & 0 & 0 & l & 0 \\
\end{tabular}
\label{tab:params_d_h}
\end{table}

A partir da Tabela D-H \ref{tab:params_d_h}, a cinemática do sistema está completamente descrita.
É possível determinar as matrizes de transformação homogênea de cada ponto utilizando o parâmetro de cada junta modelada através da equação \ref{eq:matriz_rotacao} \cite{Siciliano2008}.
\begin{equation}
A^{i-1}_{i} = \begin{bmatrix}
\cos \theta_i & -\sin \theta_i \cos \alpha_i & \sin \theta_i \sin \alpha_i & a_i \cos \theta_i \\
\sin \theta_i & \cos \theta_i \cos \alpha_i & -\cos \theta_i \sin \alpha_i & a_i \sin \theta_i \\
0 & \sin \alpha_i & \cos \alpha_i & d_i \\
0 & 0 & 0 & 1
\end{bmatrix}\label{eq:matriz_rotacao}
\end{equation}
Assim, é possível calcular como referenciais intermediários obtendo as matrizes \eqref{eq:matriz_rotacao_a01}, \eqref{eq:matriz_rotacao_a12} e \eqref{eq:matriz_rotacao_a23}.
\begin{equation}
A^{0}_{1} = \begin{bmatrix}
\cos \theta & 0 & \sin \theta & 0 \\
\sin \theta & 0 & -\cos \theta & 0 \\
0 & 1 & 0 & h \\
0 & 0 & 0 & 1
\end{bmatrix}\label{eq:matriz_rotacao_a01}
\end{equation}

\begin{equation}
A^{1}_{2} = \begin{bmatrix}
\cos \phi & -\sin \phi & 0 & 0 \\
\sin \phi & \cos \phi & 0 & 0 \\
0 & 0 & 1 & -d \\
0 & 0 & 0 & 1
\end{bmatrix}\label{eq:matriz_rotacao_a12}
\end{equation}

\begin{equation}
A^{2}_{3} = \begin{bmatrix}
1 & 0 & 0 & l \\
0 & 1 & 0 & 0 \\
0 & 0 & 1 & 0 \\
0 & 0 & 0 & 1
\end{bmatrix}\label{eq:matriz_rotacao_a23}
\end{equation}

Como cada matriz descreve o referencial do próximo membro a partir do membro anterior, segundo Siciliano \citeyear{Siciliano2008}, pode-se multiplicar cada matriz para obter a transformação homogênea de estado $T_{i}^{0} = A_{i}^{i-1} A_{i-1}^{i-2}(...)A_{1}^{0}$, obtendo as matrizes \eqref{eq:matriz_rotacao_t01}, \eqref{eq:matriz_rotacao_t02} e \eqref{eq:matriz_rotacao_t03}.
\begin{equation}
T^{0}_{1} = \begin{bmatrix}
\cos \theta & 0 & \sin \theta & 0 \\
\sin \theta & 0 & -\cos \theta & 0 \\
0 & 1 & 0 & h \\
0 & 0 & 0 & 1
\end{bmatrix}\label{eq:matriz_rotacao_t01}
\end{equation}

\begin{equation}
T^{0}_{2} = \begin{bmatrix}
\cos\theta\cos\phi - \sin\theta\sin\phi & -\cos\theta\sin\phi & \cos\theta\sin\phi+\sin\theta\cos\phi & \sin\theta(-\sin\phi) \\
\cos\theta\sin\phi + \sin\theta\cos\phi & \cos\theta\cos\phi & \sin\theta\sin\phi-\cos\theta\cos\phi & \sin\theta\cos\phi \\
0 & 1 & 0 & h-d \\
0 & 0 & 0 & 1
\end{bmatrix}\label{eq:matriz_rotacao_t02}
\end{equation}

\begin{equation}
T^{0}_{3} = \begin{bmatrix}
\cos\theta\cos\phi - \sin\theta\sin\phi & -\cos\theta\sin\phi & \cos\theta\sin\phi+\sin\theta\cos\phi & l-\sin\theta\sin\phi \\
\cos\theta\sin\phi + \sin\theta\cos\phi & \cos\theta\cos\phi & \sin\theta\sin\phi-\cos\theta\cos\phi & \sin\theta\cos\phi \\
0 & 1 & 0 & h-d \\
0 & 0 & 0 & 1
\end{bmatrix}\label{eq:matriz_rotacao_t03}
\end{equation}

\section{Estimação e Rastreio de Satélites}\label{sec:estimation}
Segundo a explicação de Ford \citeyear{Ford2008}, cada satélite possui um número de catalogação que é utilizada para registrar informações básicas sobre a espaçonave. Embora algumas identificações, como nome e código de catalogação, são inalteradas durante sua vida útil, informações de órbita devem ser atualizadas constantemente por serem dinâmicas.

Agências como a North American Aerospace Defense Command (NORAD) e a National Aeronautics and Space Administration (NASA) utilizam radares e outras formas de medição para determinar a posição e órbita exata de satélites, mantendo um rastreio completo do céu.
Entre as métricas obtidas das observações estão os conhecidos elementos keplerianos. Esses elementos são informações como inclinação, excentricidade, decaimento de órbita, e perigeu \cite{soler1994}.
A partir dos keplerianos, é possível estipular a posição do satélite no espaço em relação a um determinado tempo, passado ou futuro \cite{Ford2008}.
Softwares utilizam dessas informações para determinar passagens de diversos satélites e verificar quando estarão acima do horizonte, além de determinar o azimute e a elevação que a antena da estação de solo deverá ter para estar apontada para o satélite.

Apesar de possuir a posição exata dos satélites a partir dos elementos orbitais, os softwares de rastreio de satélites normalmente reduzem a taxa de atualização de envio de dados, enviando uma nova informação ao sistema de controle da antena a cada um segundo.
Isso faz com que a informação chegue ao rotor de forma esporádica e sem muita precisão. O salto entre ângulos faz com que o mecanismo tenha que sair de seu estado estacionário, acelerar rapidamente, e parar novamente. Essa ação faz com que o sistema sofra maiores estresses, além de dificultar o alinhamento de antenas de feixe fechado que precisam de grande precisão em seu apontamento ao alvo.
Para reduzir este efeito, é necessário tratar os dados enviados de forma a estimar a trajetória do satélite. Com essa estimação, é possível criar uma trajetória que possua um movimento suave durante o rastreio.
Outro fator que limita o uso do método tradicional de envio de dados é o de que o rotor não é capaz de continuar o rastreio de forma independente caso o sistema perca conexão com o aplicativo principal.
Utilizando sistemas que estimem a posição do satélite, é possível fazer com que o rotor continue o rastreio por determinado período de tempo antes de começar a divergir da posição real, fazendo com que o sistema seja menos suscetível a erros de comunicação.

Um último ponto que justifica a utilização de algoritmos estimadores de trajetória é para passagens de satélites próximas ao zênite (elevações próximas de $90^\circ$), que atingem grandes velocidades angulares.
Como os softwares continuam a enviar a posição dos satélites periodicamente, nos casos de passagem próxima de zênite, há uma grande diferença de apontamento entre a última posição enviada e a posição real do satélite.
Isso faz com que uma condição que deveria permitir a melhor recepção possível, pela falta de obstruções e com menos atmosfera para atenuação, pode ser afetada pelo desapontamento da antena ao alvo.
Com o uso de um filtro preditor, é possível obter a velocidade do satélite durante a passagem e permitir um apontamento mais preciso, garantindo uma melhor recepção de sinal.

Segundo Ekstrand \citeyear{ekstrand2012}, existem várias técnicas para a estimação da posição de um alvo ao longo do tempo. A primeira e mais simples é de enviar ao controlador dos motores a posição recebida do aplicativo e replicá-la na antena. Porém, a desvantagem desse método é que a estrutura sofre saltos grandes de posição, além de que a posição da antena ficará estática se o rotor perder a conexão com o software de rastreio.
Uma outra técnica é utilizar um filtro Kalman, que possui camadas de previsão e correção recursiva para fazer com que o Mínimo Erro Quadrático Médio seja mínimo em relação a um modelo inicial. E o problema com o Filtro Kalman para esse caso é que ele é relativamente exigente em quesitos de processos, pois precisa recorrentemente atualizar as matrizes de ganhos \cite{ekstrand2012}.
Como é desejado que o projeto funcione completamente embarcado em um microcontrolador, esse tempo maior de processo pode causar demora no controle dos motores e fazer o sistema perder o rastreio do satélite. Um terceiro sistema com harmonia entre sua capacidade preditiva e seu tempo de processamento é o filtro $\alpha-\beta$ e seus derivados, que utiliza coeficientes constantes (diferentemente dos coeficientes varíaveis do filtro Kalman \cite{ekstrand2012}) para corrigir as variáveis do modelo, mantendo a característica preditiva e mantendo baixo tempo de processamento \cite{wu2009}.

Segundo Tenne \citeyear{tenne2000} e Wu \citeyear{wu2009}, filtros $\alpha-\beta$ possuem diferentes ordens. O primeiro tipo é o $\alpha-\beta$, sendo um filtro de segunda ordem inicialmente utilizado para rastrear alvos através de radares. Esse filtro possui dois coeficientes, sendo $\alpha$ o coeficiente responsável por prever a variação de posição e $\beta$ responsável por prever a velocidade do sistema, que deve ser constante para o bom funcionamento do filtro.
A segunda forma do filtro é o $\alpha-\beta-\gamma$, sendo um filtro de terceira ordem que, além de prever posição e velocidade, pode prever também a aceleração do sistema. O último tipo de filtro mais comum é o $\alpha-\beta-\gamma-\delta$, capaz de prever taxa de variação da aceleração.
Para o escopo do projeto envolvendo o rastreio de objetos em trajetórias circulares e para a projeção de posição descrita na seção \ref{sec:ground_tracking}, um bom compromisso entre manter o rastreio da variação de velocidade (aceleração) e não necessitar de cálculos extras é utilizar o filtro $\alpha-\beta-\gamma$, que é previsto para se encaixar melhor às necessidades do controle do pedestal.
Um filtro $\alpha-\beta$, em teoria, não será ideal porque é esperada uma grande variação de velocidade vista pela estação de solo enquanto ocorrer o rastreio do satélite, gerando um erro de regime permanente pela aceleração envolvida em trajetórias circulares \cite{tenne2000}.
Em contrapartida, o filtro $\alpha-\beta-\gamma-\delta$ é mais utilizado quando há uma grande variação de aceleração \cite{wu2009}. Não é o caso para o projeto, já que é esperado que a aceleração aumente levemente enquanto o satélite cruza o horizonte em direção à elevação máxima e diminua enquanto ele estiver se deslocando à outra região do horizonte em relação à estação de solo. Então a variação de aceleração é tão pequena que não justifica o maior processamento necessário.

Utilizando como referência a modelagem feita por \cite{tenne2000}, o filtro $\alpha-\beta-\gamma$ pode ser descrito por duas séries de equação: uma para os valores preditos e outra para os coeficientes estimados a partir dos dados recebidos. Os valores possuem um subscrito para indicar o que eles representam. O subscrito $s$ está relacionado aos dados suavizados, $p$ em relação aos dados preditos, e $o$ relacionado aos dados observados (com a posição exata do objeto). As equações de predição e suavização são dadas pelas fórmulas \eqref{eq:x_p}, \eqref{eq:v_p}, \eqref{eq:x_s}, \eqref{eq:v_s} e \eqref{eq:a_s}.
\begin{align}
x_p(k+1)=x_s(k)+Tv_s(k)+\frac{1}{2}T^2a_s(k)\label{eq:x_p} \\
v_p(k+1) = v_s(k)+Ta_s(k)\label{eq:v_p} \\
x_s(k) = x_p(k)+\alpha(x_o(k)-x_p(k))\label{eq:x_s} \\
v_s(k) = v_p(k)+\frac{\beta}{T}(x_o(k)-x_p(k))\label{eq:v_s} \\
a_s(k) = a_p(k)+\frac{\gamma}{2T^2}(x_o(k)-x_p(k))\label{eq:a_s}
\end{align}
Para a modelagem do filtro $\alpha-\beta$, basta considerar o fator $\gamma$ equivale a 0.

Como \cite{tenne2000} e \cite{sighencea2022} propõem, é possível fazer a transformada Z a partir das equações em tempo discreto \eqref{eq:x_p} até \eqref{eq:a_s} considerando as relações \eqref{eq:igualdade_a_p} e \eqref{eq:transform_z_a_s_k-1}, resultando nas fórmulas \eqref{eq:x_p_k_to_z} a \eqref{eq:a_s_z}.
\begin{align}
a_p(k) = a_s(k-1) \label{eq:igualdade_a_p} \\
\mathcal{Z}[a_s(k-1)] = z^{-1}A_s(z) = \frac{1}{z}A_s(z) \label{eq:transform_z_a_s_k-1} \\
zX_p(z) - zx_p(0) =X_s(z)+TV_s(z)+\frac{1}{2}T^2A_s(z)\label{eq:x_p_k_to_z} \\
zV_p(z) - zv_p(0) = V_s(z)+TA_s(z)\label{eq:v_p_k_to_z} \\
X_s(z) = X_p(z)+\alpha[X_o(z)-X_p(z)]\label{eq:x_s_z} \\
V_s(z) = V_p(z)+\frac{\beta}{T}[X_o(z)-X_p(z)]\label{eq:v_s_z} \\
A_s(z) = \frac{1}{z}A_s(z)+\frac{\gamma}{2T^2}[X_o(z)-X_p(z)]\label{eq:a_s_z}
\end{align}

A partir das equações, é possível resolvê-las para $\frac{x_p}{x_o}$, obtendo a razão de polinômios evidenciada na equação \eqref{eq:g(z)_alpha_beta_gamma_pols}.

\begin{equation}
G(z) = \frac{X_p(z)}{X_o(z)} = \frac{\alpha+(-2\alpha-\beta+\frac{1}{4}\gamma)z+(\alpha+\beta+\frac{1}{4}\gamma)z^2}{z^3+(\alpha+\beta+\frac{1}{4}\gamma-3)z^2+(-2\alpha-\beta+\frac{1}{4}\gamma+3)z+\alpha-1} \label{eq:g(z)_alpha_beta_gamma_pols}
\end{equation}
Além disso, é possível obter a função de transferência, utilizando a dedução de \cite{ekstrand2012}. A função de transferência em tempo discreto tem a forma apresentada na equação \eqref{eq:g(z)_alpha_beta_gamma}.
\begin{equation}
G(z) = \frac{\alpha z^2+(\beta - \alpha)z}{z^2+(\alpha+\beta-2)z+1- \alpha} \label{eq:g(z)_alpha_beta_gamma}
\end{equation}
Utilizando o polinômio característico do denominador de \eqref{eq:g(z)_alpha_beta_gamma}, \cite{tenne2000} utiliza o Teste da Estabilidade de Jury.
Esse teste é efetuado utilizando os coeficientes do denominador da função de transferência e é capaz de garantir que os polos se encontrem dentro do círculo unitário do plano Z.
Considerando uma função de transferência com denominador de ordem $n$ na forma da equação \eqref{eq:denominador_polinomio},
\begin{equation}
P(z) = a_nz^n + a_{n-1}z^{n-1} + ... + a_1z + a_0 \label{eq:denominador_polinomio}
\end{equation}

Segundo Sighencea \citeyear{sighencea2022}, o critério de Jury é facilmente encontrado utilizando uma Tabela de auxílio para determinar as condições de estabilidade.
Um sistema de segunda ordem, de acordo com \cite{sighencea2022}, possui somente uma linha para determinar o critério de estabilidade.
Para cada ordem adicional, serão necessárias duas linhas a mais na Tabela \ref{tab:criterio_Jury}.
Sendo assim, um  sistema de ordem $n$ como visto na equação \eqref{eq:denominador_polinomio}, possui um critério de estabilidade como o visto na Tabela \ref{tab:criterio_Jury}.
\begin{table}[htbp]
\centering
\caption{Critério de estabilidade de Jury para um sistema de ordem $n$}
\begin{tabular}{ccccc}
    \hline
    $z^0$ & $z^1$ & $...$ & $z^{n-1}$ & $z^n$ \\
    \hline
    $a_0$ & $a_1$ & $...$ & $a_{n-1}$ & $a_n$ \\
    $a_n$ & $a_{n-1}$ & $...$ & $a_1$ & $a_0$ \\
    $b_0$ & $b_1$ & $...$ & $b_{n-1}$ &  \\
    $b_{n-1}$ & $b_{n-2}$ & $...$ & $b_0$ &  \\
    $c_0$ & $c_1$ & $...$ &  &  \\
    $c_{n-2}$ & $c_{n-1}$ & $...$ &  &  \\
    $...$ & $...$ & $...$ & $...$ & $...$ \\
    $m_0$ & $m_1$ & $m_2$ &  &
\end{tabular}
\label{tab:criterio_Jury}
\end{table}

Os coeficientes das linhas seguintes no critério de estabilidade de Jury é calculado utilizando as equações \eqref{eq:coef_bk}, \eqref{eq:coef_ck} e as demais até resultar em três coeficientes no final da Tabela \ref{tab:criterio_Jury}.
\begin{align}
b_k = \begin{vmatrix}
a_0 & a_{n-k} \\
a_n & a_k
\end{vmatrix} \label{eq:coef_bk} \\
c_k = \begin{vmatrix}
b_0 & b_{n-1-k} \\
b_{n-1} & b_k
\end{vmatrix} \label{eq:coef_ck}
\end{align}

A partir dos resultados obtidos, é possível garantir que o polinômio é estável, ou seja, não possui raízes fora do círculo unitário.
Segundo Sighencea \citeyear{sighencea2022}, um polinômio de ordem $n$ precisa satisfazer $n-1$ condições.
As equações \eqref{eq:valor_positivo_Jury} e \eqref{eq:valor_negativo_Jury} são conhecidas como condições necessárias para a estabilidade,
enquanto as equações \eqref{eq:satisfazer_Jury_ini} a \eqref{eq:satisfazer_Jury_fim} são condições suficientes para a estabilidade.
\begin{align}
    G(1) > 0 \label{eq:valor_positivo_Jury} \\
    (-1)^n G(-1) > 0 \label{eq:valor_negativo_Jury} \\
    \left|a_0\right| < \left|a_n\right| \label{eq:satisfazer_Jury_ini} \\
    \left|b_0\right| > \left|b_{n-1}\right| \\
    \left|c_0\right| > \left|c_{n-2}\right| ... \left|m_0\right| > \left|m_2\right| \label{eq:satisfazer_Jury_fim} \\
\end{align}

Utilizando variáveis genéricas para o denominador em \eqref{eq:g(z)_alpha_beta_gamma} e usando o critério de estabilidade de Jury, é possível obter as equações \eqref{eq:alpha_lim}, \eqref{eq:beta_lim} e \eqref{eq:gamma_lim} para que os coeficientes do filtro $\alpha-\beta-\gamma$ estejam dentro da região de estabilidade.
\begin{align}
0<\alpha<2,                             \label{eq:alpha_lim} \\
0<\beta<4-2\alpha,                      \label{eq:beta_lim}  \\
0<\gamma<\frac{4\alpha\beta}{2-\alpha}. \label{eq:gamma_lim}
\end{align}
Durante o desenvolvido do projeto, esses valores de limite irão ser utilizados para garantir a estabilidade e convergência do filtro.
