MuriloVAlves/TG/Docs/TG_IAR_Dissertacao/extras/dados.tex

% ---
% Informações de dados para CAPA e FOLHA DE ROSTO
% ---
\titulo{Modelagem Cinemática, Filtragem Preditiva e Simulação de um Pedestal Azimute-Elevação com Antena para Rastreio de Satélite}
\autor{Murilo Valentim Alves}
\local{Santo André - SP}
\data{23 de Outubro de 2026}
\orientador[Orientadora:]{Elvira Rafikova}
\coorientador[Coorientadora:]{Ana Paula Pagotti}
\instituicao{%
  Universidade Federal do ABC -- UFABC
  \par
  Centro de Engenharia, Modelagem e Ciências Sociais Aplicadas 
  \par
  Programa de Graduação em Engenharia
de Instrumentação, Automação e Robótica}
\tipotrabalho{Dissertação (Graduação)}
% O preambulo deve conter o tipo do trabalho, o objetivo,
% o nome da instituição e a área de concentração
\preambulo{\textbf{Trabalho de Graduação} apresentado ao Bacharelado em Engenharia de Instrumentação, Automação e Robótica (área de concentração: Sistemas Inteligentes), como parte dos requisitos necessários para a obtenção do Título de Engenheiro em Instrumentação, Automação e Robótica.}
% ---
