MuriloVAlves/TG/Docs/TG_IAR_Dissertacao/pretextual/agradecimentos.tex

% ---
% Agradecimentos
% ---
\begin{agradecimentos}
Gostaria de iniciar essa seção agradecendo primeiramente a Deus, por ter guiado meus passos e colocado em minha frente pessoas bondosas que despenderam parte de seu tempo para me ensinar e me direcionar para portas que nunca imaginei alcançar.

Agradeço também aos meus avós que sempre aturaram as minhas bagunças ao desmontar equipamentos eletrônicos no chão da sala e espalhar peças por todos os móveis da casa.
Gostaria de agradecer especialmente ao meu avô que, apesar de infelizmente vir a falecer durante a minha graduação, sempre me fez exercitar a curiosidade e a perseverança ao abrir e reparar equipamentos em seu tempo livre.
Tive a oportunidade de, ainda no tempo de vida dele, ajudá-lo com as minhas novas técnicas de solda que havia aprendido em meu curso técnico de eletrônica, solda essa que ele executavam tão bem com somente seu conhecimento de vivência.

Também agradeço a todos meus familiares, mas principalmente à minha mãe, que sempre zelou pelo meu conhecimento e acreditou em mim em momentos que eu me sentia sem chão, e ao meu pai, que sempre me ensinou sobre humildade, reconhecimento ao próximo, e demonstrou ser um exímio construtor de antenas quando eu lhe pedi ajuda.
Espero tê-los honrado seguindo seus ensinamentos e espero que eles continuem ouvido por muitos anos os meus feitos acadêmicos e profissionais.

E por último, mas não menos importante, gostaria de agradecer a minha namorada, que abriu mão de diversos encontros no final de semana para permitir me dedicar à conclusão desse trabalho.

\end{agradecimentos}
%% ---
