MuriloVAlves/TG/Docs/TG_IAR_Dissertacao/pretextual/dedicatoria.tex

% ---
% Dedicatória
% ---
\cleardoublepage
\begin{dedicatoria}
   \vspace*{\fill}
   \centering
   \noindent
   \textit{Dedico este trabalho a todas as pessoas que tiveram a oportunidade de admirar um céu estrelado e ver a beleza de um mundo que ainda não podemos alcançar. } 
   \vspace*{\fill}
\end{dedicatoria}
% ---
