MuriloVAlves/TG/Docs/TG_IAR_Dissertacao/pretextual/epigrafe.tex

% ---
% Epígrafe
% ---
\begin{epigrafe}
    \vspace*{\fill}
	\begin{flushright}
		\textit{``Mais do que de máquinas, precisamos de humanidade. \\
		Mais do que de inteligência, precisamos de afeição e doçura. \\
		Sem essas virtudes, a vida será de violência e tudo será perdido.''\\
		          (Charles Chaplin)}
	\end{flushright}
\end{epigrafe}
% ---
