MuriloVAlves/TG/Docs/TG_IAR_Dissertacao/capitulos/estadodaarte.tex

\chapter{Estado da Arte}\label{cap:estArte}

A principal aplicação de sistemas de rastreio automático está relacionada a veículos aéreos não tripulados (VANTs, ou UAVs em inglês), com o intuito de aumentar a distância de operação com relação à base em solo \cite{nugroho2018} \cite{kim2023}.Para rastreio de satélites, existem diversos trabalhos focados em modelar o funcionamento de antenas baseadas em barcos e navios \cite{wang2016} \cite{ueba2016} \cite{gholamiomali2024}. 

\section{Trabalhos Relacionados a Isto}\label{sec:primTrab}
\addcontentsline{toc}{section}{Trabalhos Relacionados a Isto}

\lipsum[34-36]
