MuriloVAlves/TG/Docs/TG_IAR_Dissertacao/capitulos/referencias.tex

% ---
\chapter{Uso de referências bibliográficas}
% ---

A formatação das referências bibliográficas conforme as regras da ABNT são um
dos principais objetivos do \abnTeX. Consulte os manuais
\citeonline{abntex2cite} e \citeonline{abntex2cite-alf} para obter informações
sobre como utilizar as referências bibliográficas.

%-
\subsection{Acentuação de referências bibliográficas}
%-

Normalmente não há problemas em usar caracteres acentuados em arquivos
bibliográficos (\texttt{*.bib}). Na~\autoref{Tabela-acentos} você encontra alguns exemplos das conversões mais importantes. Preste atenção especial para `ç' e `í'
que devem estar envoltos em chaves. A regra geral é sempre usar a acentuação
neste modo quando houver conversão para letras maiúsculas.

\begin{table}[htbp]
\caption{Tabela de conversão de acentuação.}
\label{Tabela-acentos}

\begin{center}
\begin{tabular}{ll}\hline\hline
acento & \textsf{bibtex}\\
à á ã & \verb+\`a+ \verb+\'a+ \verb+\~a+\\
í & \verb+{\'\i}+\\
ç & \verb+{\c c}+\\
\hline\hline
\end{tabular}
\end{center}
\end{table}

% ---
\section{Deu pau em algo?}
% ---

Consulte a FAQ com perguntas frequentes e comuns no portal do \abnTeX:
\url{https://code.google.com/p/abntex2/wiki/FAQ}.

Inscreva-se no grupo de usuários \LaTeX:
\url{http://groups.google.com/group/latex-br}, tire suas dúvidas e ajude a galera se tiver tudo certo.
