MuriloVAlves/TG/Dados/scope_0.png

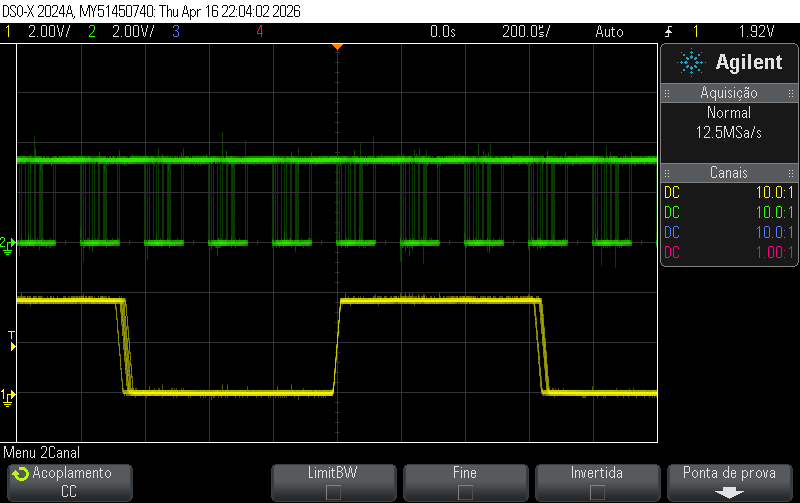
Dados/scope_0.png
