MuriloVAlves/TG/Dados/scope_1.png

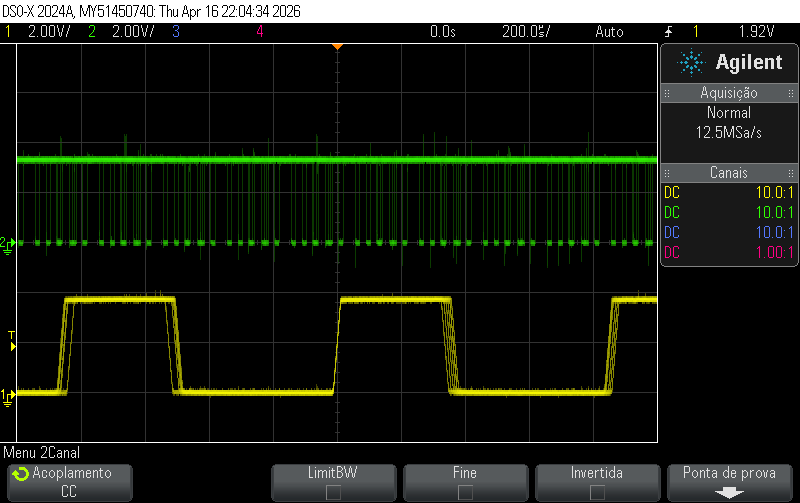
Dados/scope_1.png
