MuriloVAlves/TG/Dados/scope_2.png

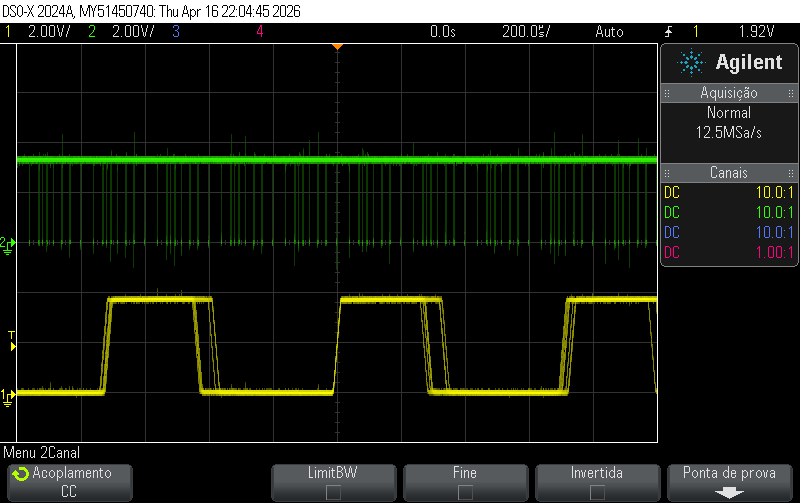
Dados/scope_2.png
