MuriloVAlves/TG/Dados/scope_3.png

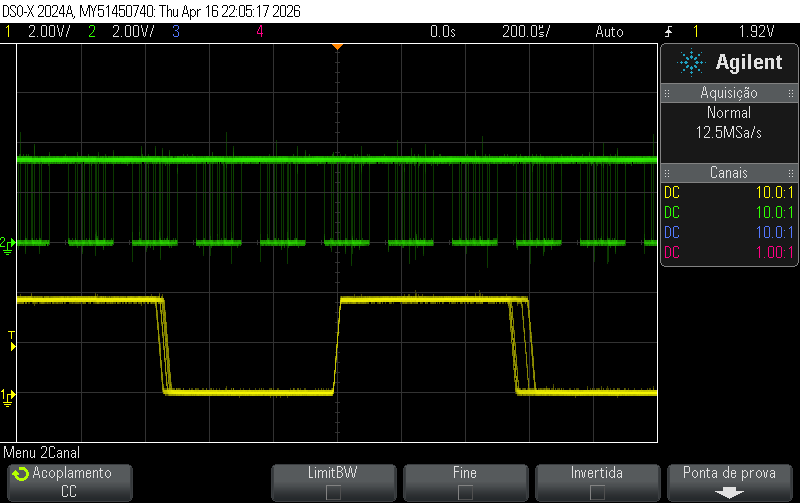
Dados/scope_3.png
