MuriloVAlves/TG/Dados/scope_5.png

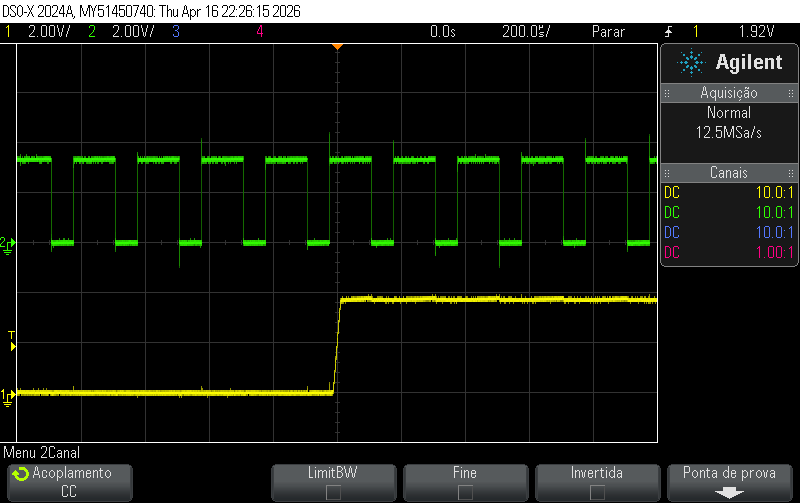
Dados/scope_5.png
