MuriloVAlves/TG/Dados/scope_6.png

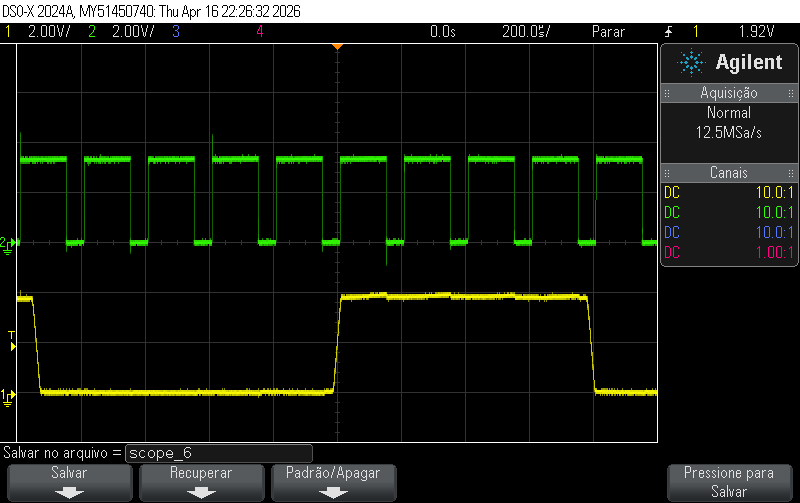
Dados/scope_6.png
