MuriloVAlves/TG/Dados/scope_7.png

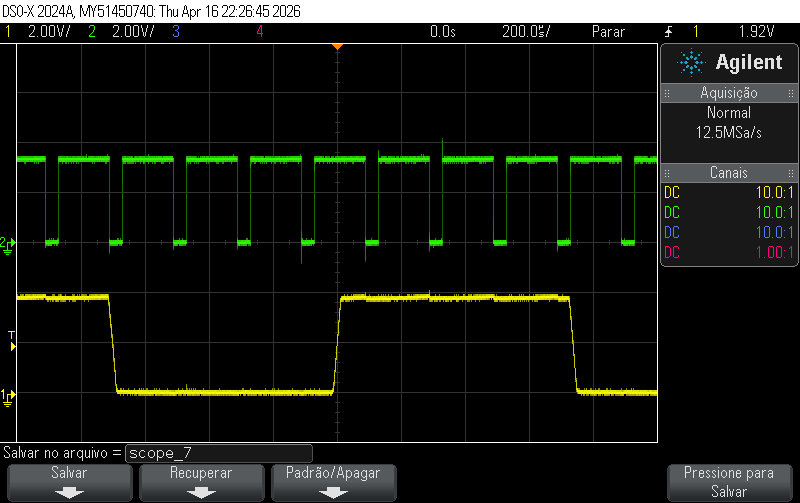
Dados/scope_7.png
