MuriloVAlves/TG/Docs/TG_IAR_Dissertacao/figs/curva_motor_crescente.png

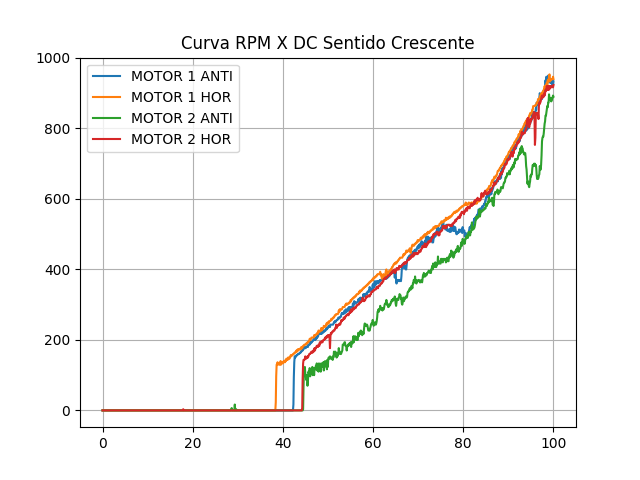
Docs/TG_IAR_Dissertacao/figs/curva_motor_crescente.png
