MuriloVAlves/TG/Docs/TG_IAR_Dissertacao/figs/curva_motor_decrescente.png

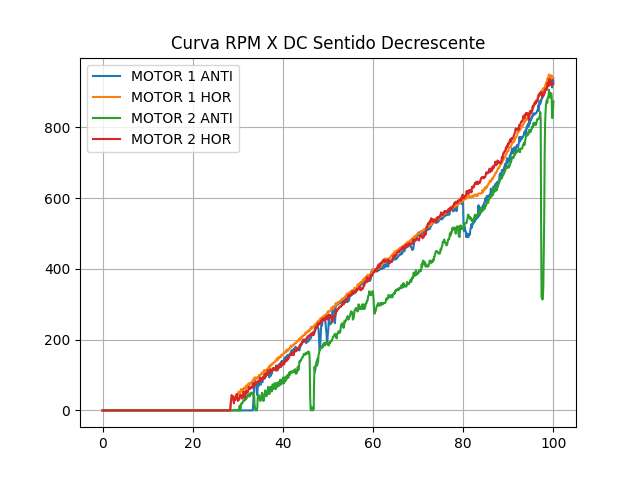
Docs/TG_IAR_Dissertacao/figs/curva_motor_decrescente.png
