MuriloVAlves/TG/Docs/TG_IAR_Dissertacao/figs/Fases_Canais_Encoder.png

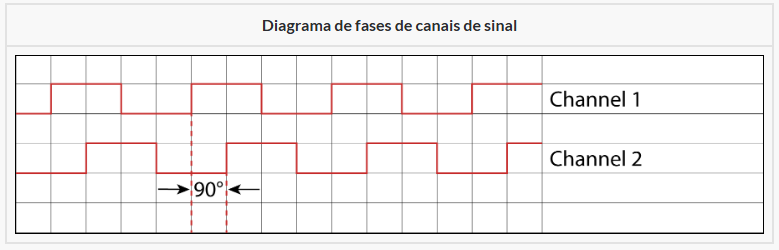
Docs/TG_IAR_Dissertacao/figs/Fases_Canais_Encoder.png
