MuriloVAlves/TG/Docs/TG_IAR_Dissertacao/figs/pedestal_proxy.png

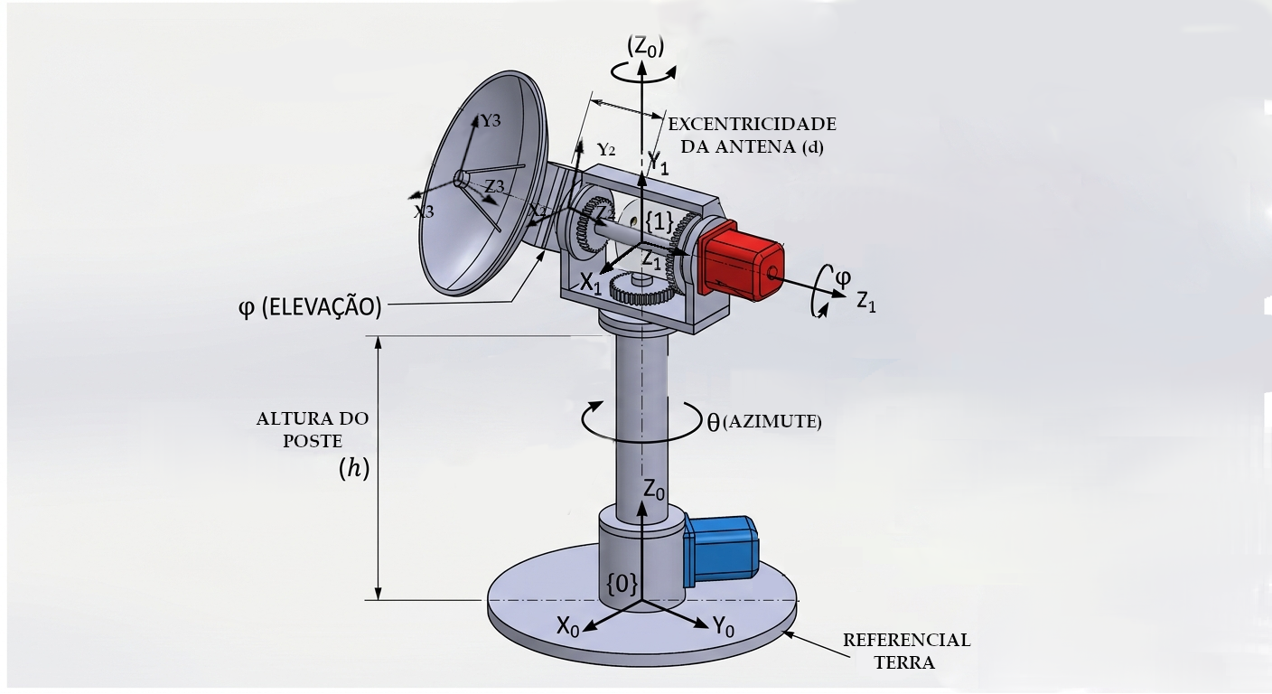
Docs/TG_IAR_Dissertacao/figs/pedestal_proxy.png
