MuriloVAlves/TG/CAD_Models/Full assembly/meshes/Part_1_3.stl

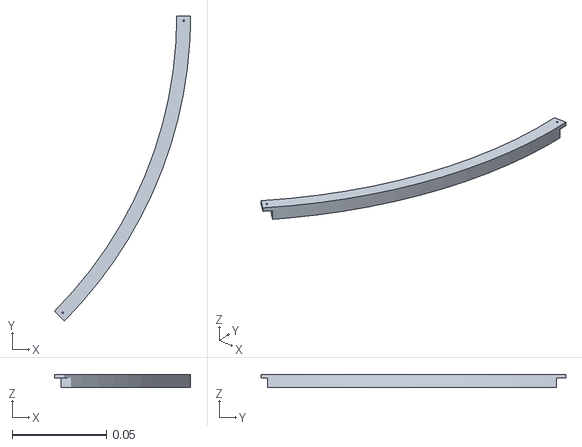
[picture p25: CAD file, 2026-11-08]
CAD_Models/Full assembly/meshes/Part_1_3.stl
0.0724 x 0.162 x 0.007
