MuriloVAlves/TG/CAD_Models/Full assembly/meshes/stator.stl

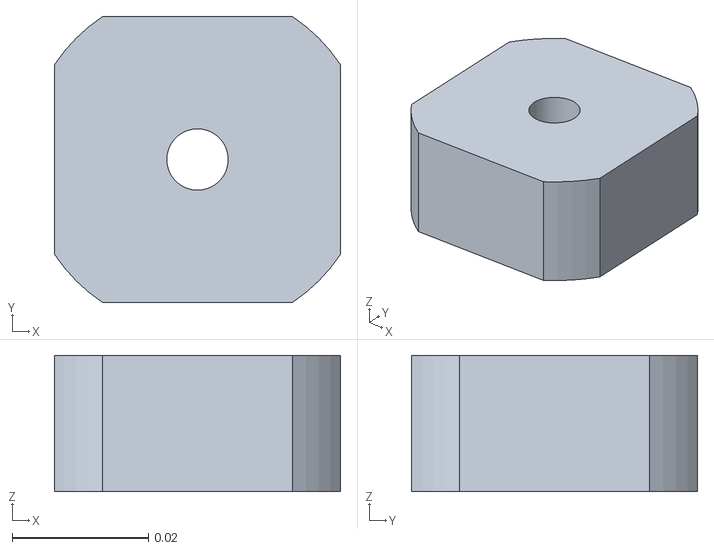
[picture p26: CAD file, 2026-11-08]
CAD_Models/Full assembly/meshes/stator.stl
0.042 x 0.042 x 0.02
