MuriloVAlves/TG/MuJoCo/antenna/assets/part_2.stl

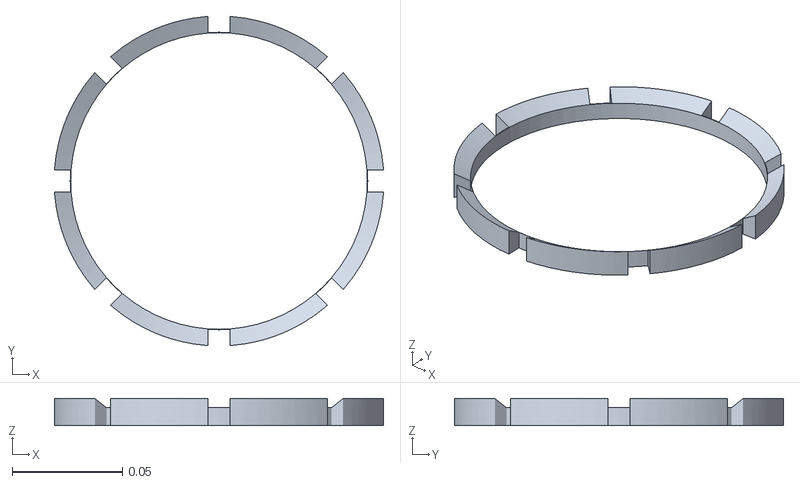
[picture p27: CAD file, 2026-10-11]
MuJoCo/antenna/assets/part_2.stl
0.149 x 0.149 x 0.0123
