MuriloVAlves/TG/CAD_Models/Full assembly/meshes/Part_1_6.stl

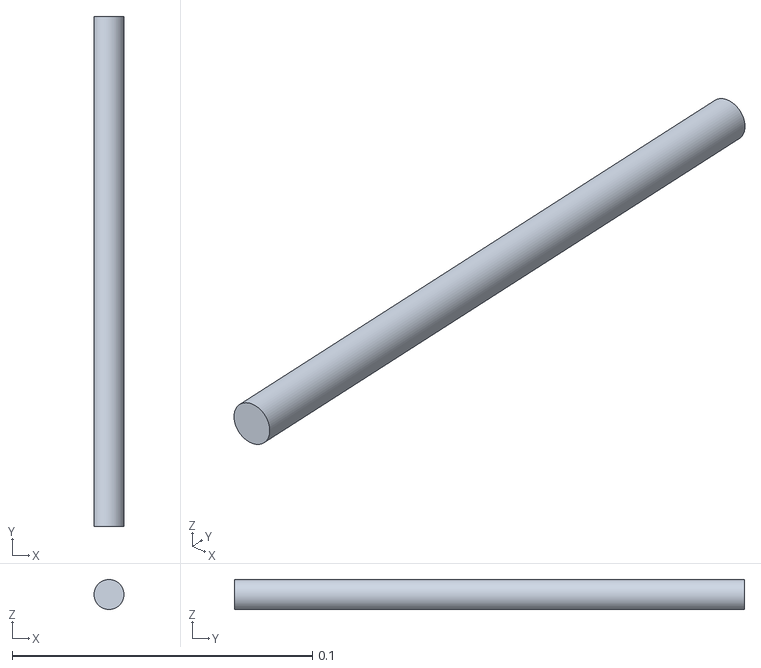
[picture p28: CAD file, 2026-11-08]
CAD_Models/Full assembly/meshes/Part_1_6.stl
0.00999 x 0.17 x 0.01
