MuriloVAlves/TG/MuJoCo/antenna/assets/connector.stl

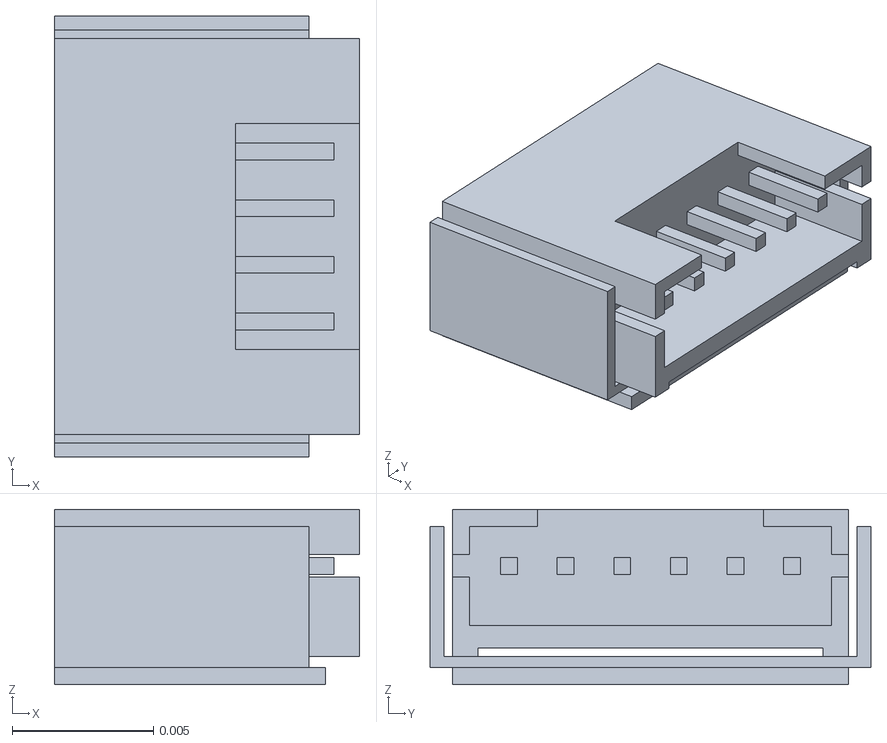
[picture p29: CAD file, 2026-10-11]
MuJoCo/antenna/assets/connector.stl
0.0108 x 0.0156 x 0.0062
