MuriloVAlves/TG/CAD_Models/Full assembly/meshes/Base_Pole.stl

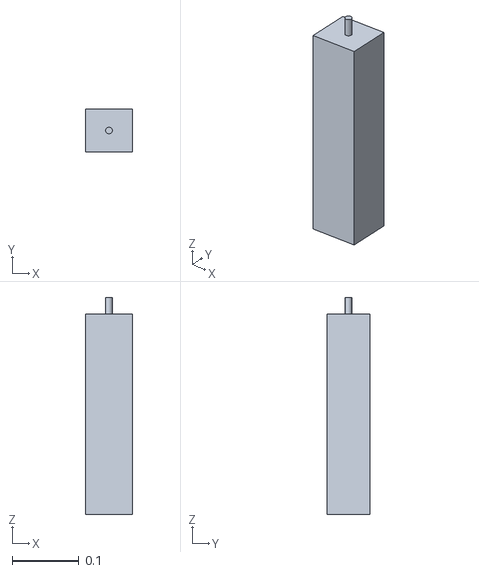
[picture p30: CAD file, 2026-11-08]
CAD_Models/Full assembly/meshes/Base_Pole.stl
0.07 x 0.065 x 0.325
