MuriloVAlves/TG/MuJoCo/antenna/assets/part_1__3.stl

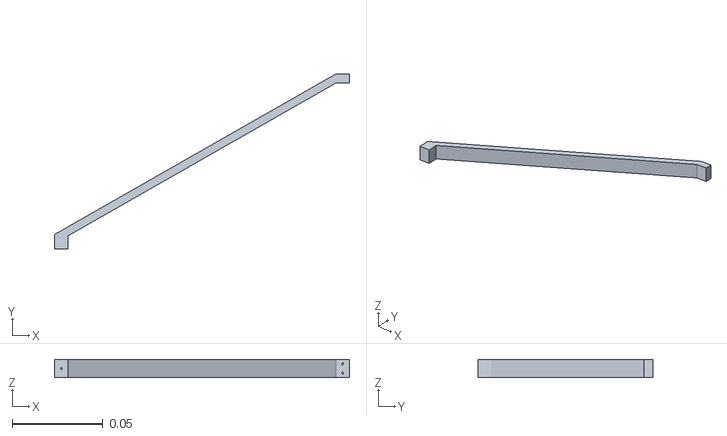
[picture p31: CAD file, 2026-10-11]
MuJoCo/antenna/assets/part_1__3.stl
0.162 x 0.0962 x 0.01
