MuriloVAlves/TG/CAD_Models/Full assembly/meshes/shaft.stl

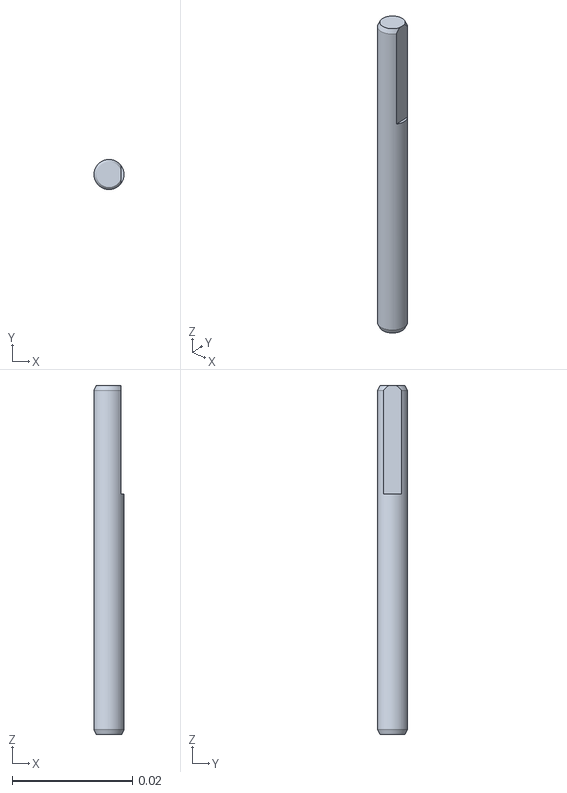
[picture p32: CAD file, 2026-11-08]
CAD_Models/Full assembly/meshes/shaft.stl
0.005 x 0.00499 x 0.058
