MuriloVAlves/TG/CAD_Models/Full assembly/meshes/front_bearing.stl

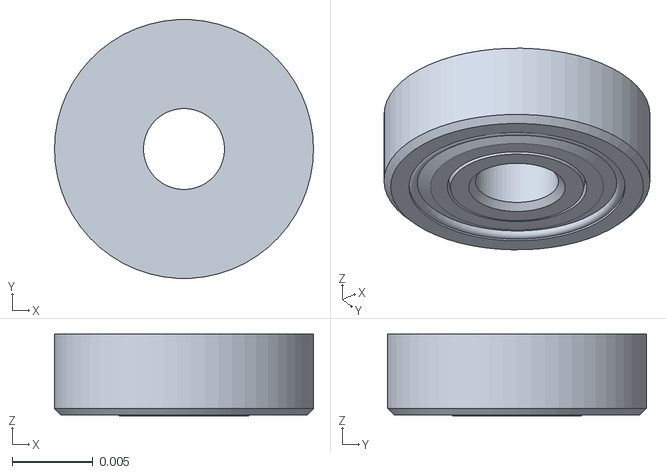
[picture p33: CAD file, 2026-11-08]
CAD_Models/Full assembly/meshes/front_bearing.stl
0.016 x 0.016 x 0.00505
