MuriloVAlves/TG/MuJoCo/antenna/assets/part_1__7.stl

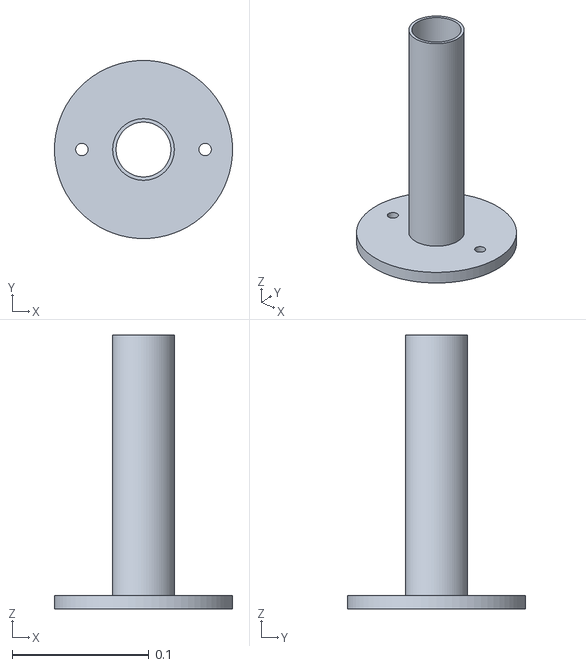
[picture p34: CAD file, 2026-10-11]
MuJoCo/antenna/assets/part_1__7.stl
0.13 x 0.13 x 0.2
