MuriloVAlves/TG/CAD_Models/Full assembly/meshes/Part_6.stl

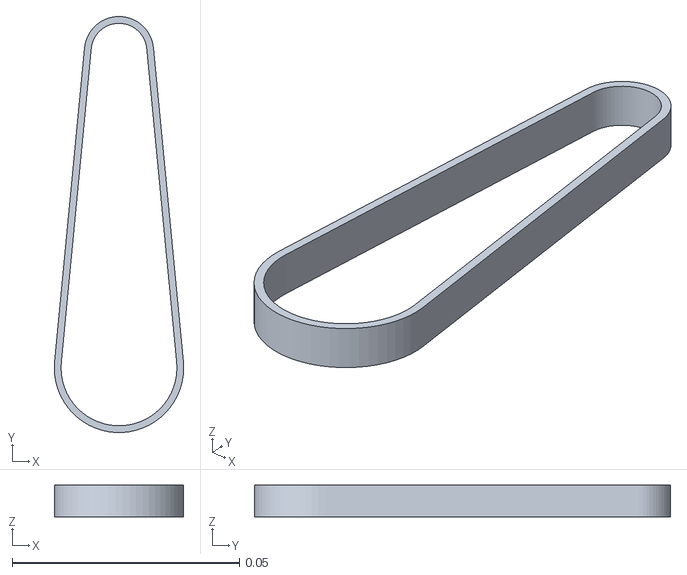
[picture p35: CAD file, 2026-11-08]
CAD_Models/Full assembly/meshes/Part_6.stl
0.0285 x 0.0916 x 0.007
