MuriloVAlves/TG/CAD_Models/Full assembly/meshes/Bush_12_10_Standard__Cut_Extrude2.stl

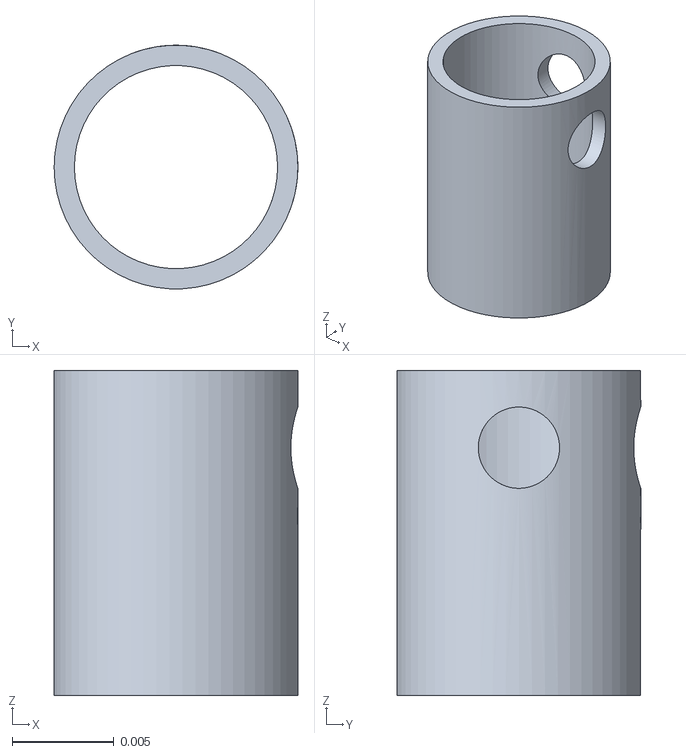
[picture p36: CAD file, 2026-11-08]
CAD_Models/Full assembly/meshes/Bush_12_10_Standard__Cut_Extrude2.stl
0.012 x 0.012 x 0.016
