MuriloVAlves/TG/MuJoCo/antenna/assets/part_1__11.stl

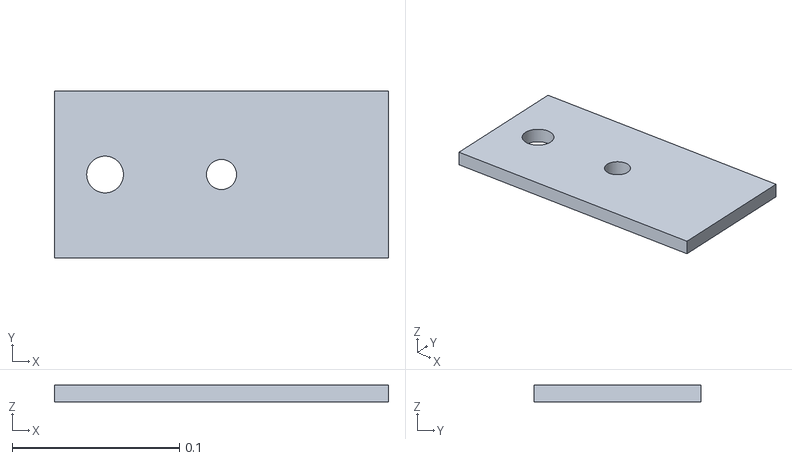
[picture p37: CAD file, 2026-10-11]
MuJoCo/antenna/assets/part_1__11.stl
0.2 x 0.1 x 0.01
