MuriloVAlves/TG/MuJoCo/antenna/assets/part_1__2.stl

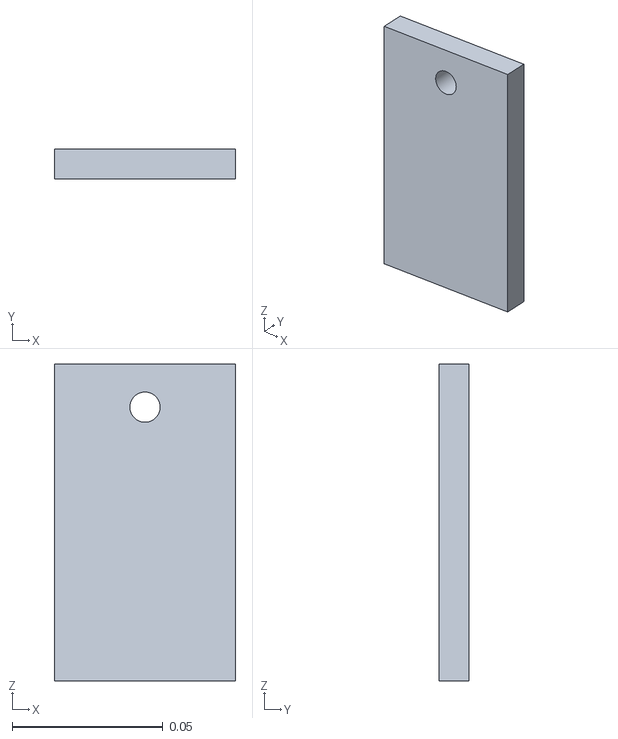
[picture p38: CAD file, 2026-10-11]
MuJoCo/antenna/assets/part_1__2.stl
0.06 x 0.01 x 0.105
