MuriloVAlves/TG/CAD_Models/Full assembly/meshes/Part_1_2.stl

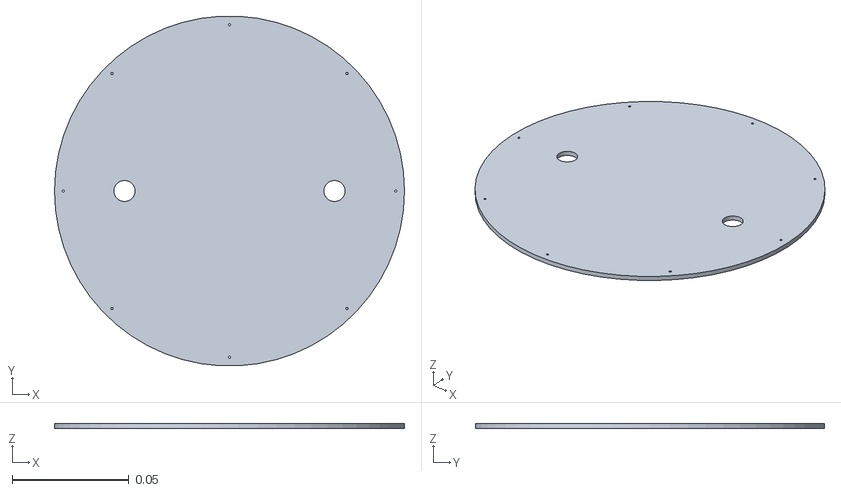
[picture p39: CAD file, 2026-11-08]
CAD_Models/Full assembly/meshes/Part_1_2.stl
0.15 x 0.15 x 0.002
