MuriloVAlves/TG/CAD_Models/Full assembly/meshes/Part_1_7.stl

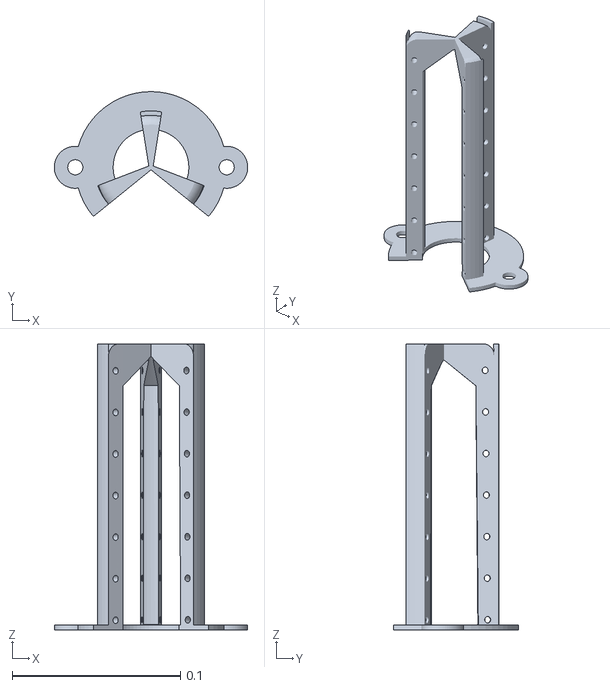
[picture p40: CAD file, 2026-11-08]
CAD_Models/Full assembly/meshes/Part_1_7.stl
0.115 x 0.0742 x 0.17
