MuriloVAlves/TG/MuJoCo/antenna/assets/base_pole.stl

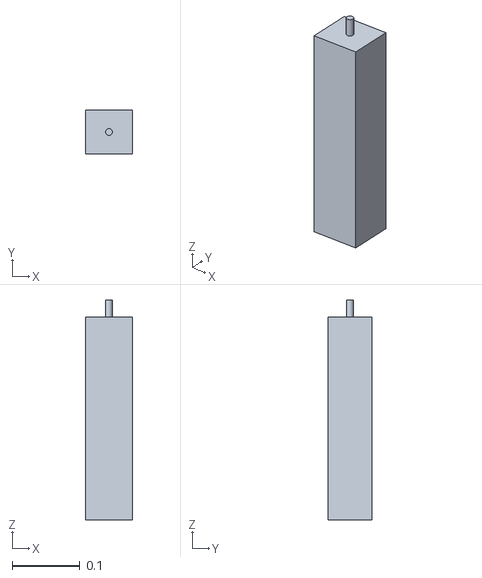
[picture p41: CAD file, 2026-10-11]
MuJoCo/antenna/assets/base_pole.stl
0.07 x 0.065 x 0.325
