MuriloVAlves/TG/CAD_Models/Full assembly/meshes/Part_1_8.stl

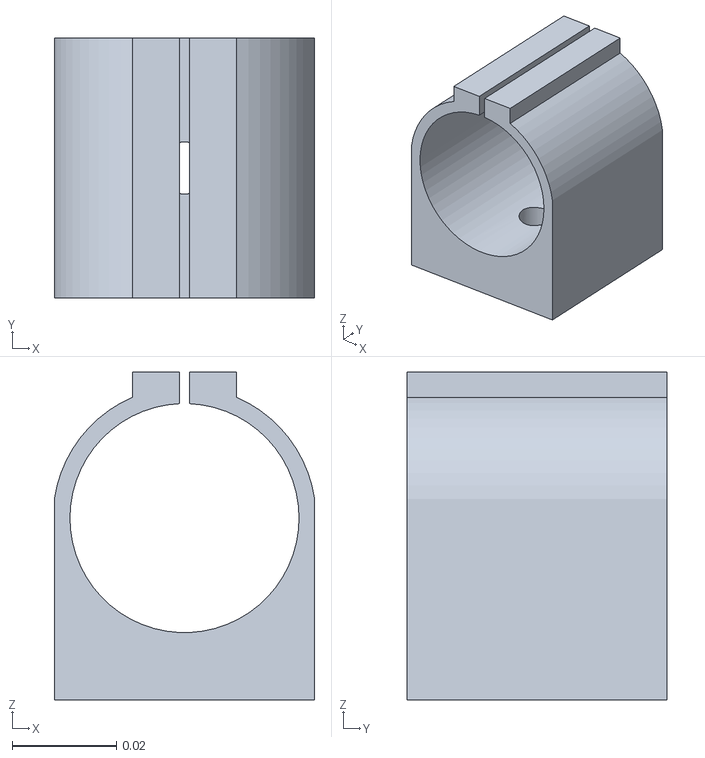
[picture p42: CAD file, 2026-11-08]
CAD_Models/Full assembly/meshes/Part_1_8.stl
0.05 x 0.05 x 0.063
