MuriloVAlves/TG/MuJoCo/antenna/assets/front_end_cap.stl

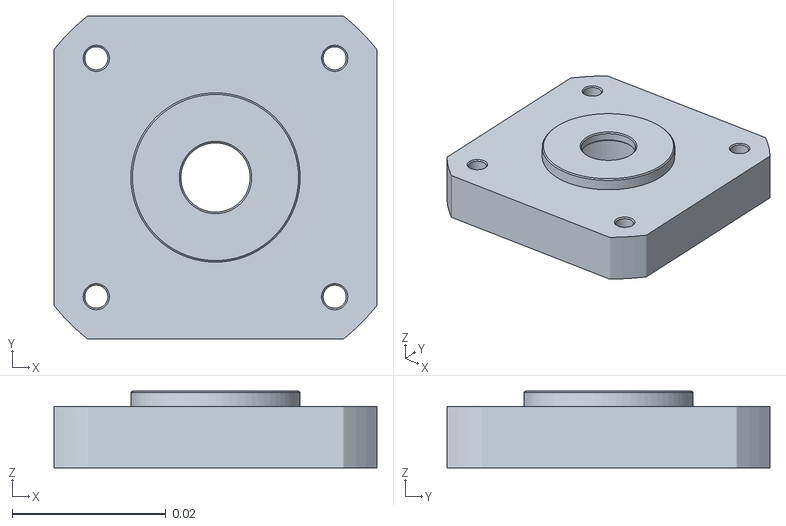
[picture p43: CAD file, 2026-10-11]
MuJoCo/antenna/assets/front_end_cap.stl
0.042 x 0.042 x 0.01
