MuriloVAlves/TG/MuJoCo/antenna/assets/rear_end_cap.stl

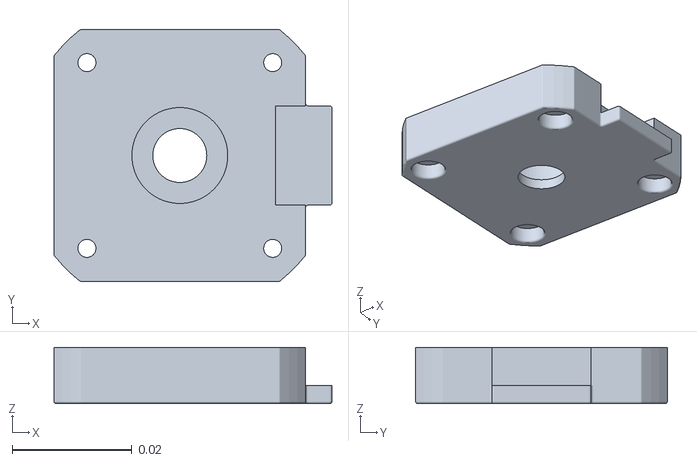
[picture p44: CAD file, 2026-10-11]
MuJoCo/antenna/assets/rear_end_cap.stl
0.0464 x 0.042 x 0.0094
