MuriloVAlves/TG/CAD_Models/Full assembly/meshes/Part_1_1.stl

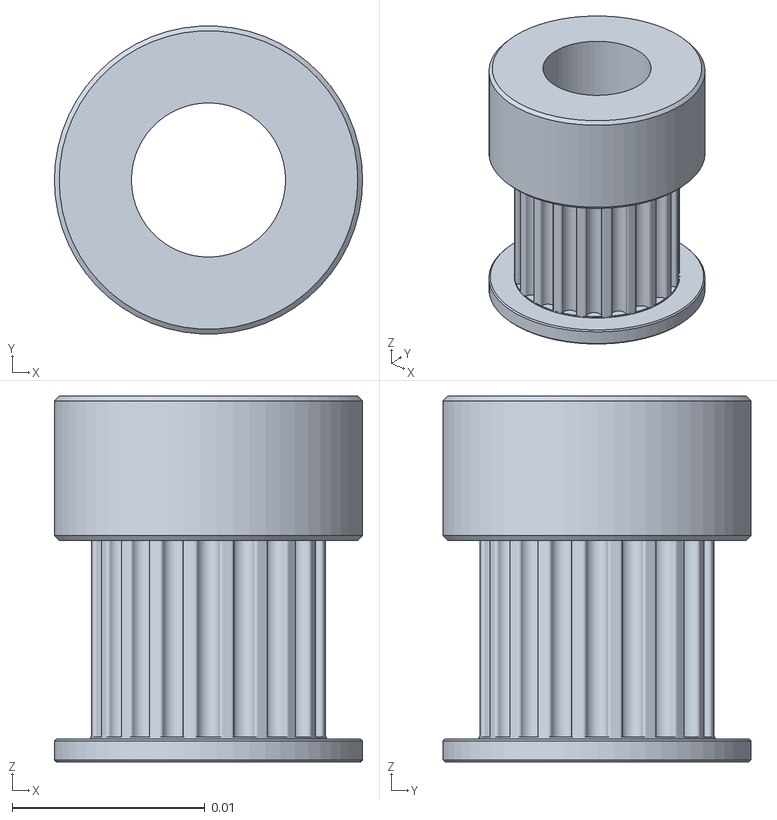
[picture p45: CAD file, 2026-11-08]
CAD_Models/Full assembly/meshes/Part_1_1.stl
0.016 x 0.016 x 0.019
