MuriloVAlves/TG/(list of files, cad)

Other CAD files:
CAD_Models/Full assembly.stl
MuJoCo/antenna/assets/part_1__4.stl
MuJoCo/antenna/assets/stator.stl
MuJoCo/antenna/assets/bush_12_10_standard__cut_extrude2.stl
CAD_Models/Full assembly/meshes/rear_bearing.stl
MuJoCo/antenna/assets/part_1__8.stl
CAD_Models/Full assembly/meshes/Part_1_4.stl
MuJoCo/antenna/assets/part_1__5.stl
MuJoCo/antenna/assets/shaft.stl
CAD_Models/Full assembly/meshes/Part_1_5.stl
MuJoCo/antenna/assets/part_1__9.stl
CAD_Models/Full assembly/meshes/Part_2.stl
CAD_Models/Full assembly/meshes/front_end_cap.stl
MuJoCo/antenna/assets/part_1__6.stl
CAD_Models/Full assembly/meshes/connector.stl
CAD_Models/Full assembly/meshes/Part_1.stl
CAD_Models/Full assembly/meshes/rear_end_cap.stl
MuJoCo/antenna/assets/front_bearing.stl
MuJoCo/antenna/assets/part_6.stl
CAD_Models/Full assembly/meshes/Base_Plate.stl
MuJoCo/antenna/assets/part_1.stl
CAD_Models/Full assembly/meshes/M3x10_Screw.stl
CAD_Models/Full assembly/meshes/Misumi_40T__Boss_Extrude6.stl
CAD_Models/Full assembly/meshes/Misumi_40T__Cut_Extrude6.stl
MuJoCo/antenna/assets/m3x10_screw.stl
MuJoCo/antenna/assets/misumi_40t__cut_extrude6.stl
MuJoCo/antenna/assets/zarysy_zębów_misumi_40t__boss_extrude6.stl
MuJoCo/antenna/assets/zarysy_zębów_misumi_40t__cut_extrude6.stl
