MuriloVAlves/TG/Docs/TG_IAR_Dissertacao/figs/Setup_Motor.jpeg

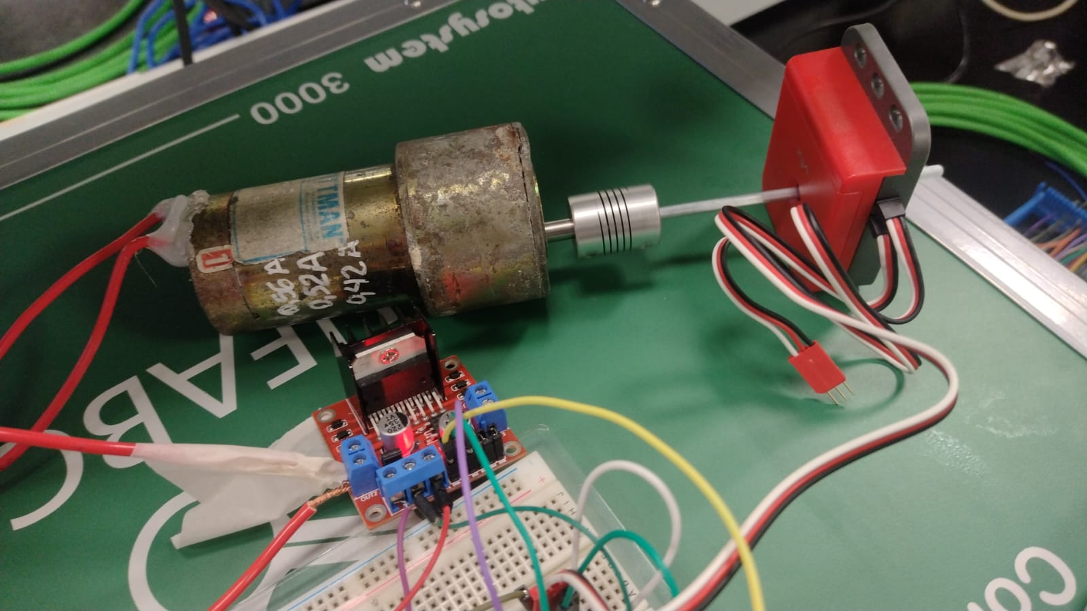
Docs/TG_IAR_Dissertacao/figs/Setup_Motor.jpeg
