MuriloVAlves/TG/MuJoCo/antenna/robot.xml

<?xml version="1.0" ?>
<!-- Generated using onshape-to-robot -->
<!-- Onshape https://cad.onshape.com/documents/5ecb8bbd2c20cf562112987a/w/2327029247a002ebebdb7eed/e/1c733580a1c5c2ff674dc995 -->
<mujoco model="antenna">
  <compiler angle="radian" meshdir="assets" autolimits="true"/>
  <default>
    <default class="antenna">
      <joint frictionloss="0.1" armature="0.005"/>
      <position kp="50" dampratio="1"/>
      <default class="visual">
        <geom type="mesh" contype="0" conaffinity="0" group="2"/>
      </default>
      <default class="collision">
        <geom group="3"/>
      </default>
    </default>
  </default>
  <worldbody>
    <!-- Link base_pole -->
    <body name="base_pole" pos="0 0 0.32" quat="1 0 0 0" childclass="antenna">
      <inertial pos="0.0961226 0.0348166 -0.170945" mass="0.574125" fullinertia="0.00452339 0.00455564 0.000435957 -6.397e-09 0 -0"/>
      <!-- Part base_pole -->
      <geom type="mesh" class="visual" pos="0.0961226 0.0348166 -0.321178" quat="1 0 -0 9.91886e-05" mesh="base_pole" material="base_pole_material"/>
      <geom type="mesh" class="collision" pos="0.0961226 0.0348166 -0.321178" quat="1 0 -0 9.91886e-05" mesh="base_pole" material="base_pole_material"/>
      <!-- Link mechanism -->
      <body name="mechanism" pos="0.0961226 0.0348166 -0.0211781" quat="0 0.600458 -0.799656 0">
        <!-- Joint from base_pole to mechanism -->
        <joint axis="0 0 1" name="azimuth" type="hinge"/>
        <inertial pos="-0.00383615 -0.0131987 -0.0451761" mass="0.523349" fullinertia="0.00153511 0.000552621 0.00143459 -0.000311897 1.18562e-05 4.0452e-05"/>
        <!-- Part misumi_40t__boss_extrude6 -->
        <geom type="mesh" class="visual" pos="-0 0 -0.0052" quat="0 0.990016 -0.140953 -0" mesh="misumi_40t__boss_extrude6" material="misumi_40t__boss_extrude6_material"/>
        <geom type="mesh" class="collision" pos="-0 0 -0.0052" quat="0 0.990016 -0.140953 -0" mesh="misumi_40t__boss_extrude6" material="misumi_40t__boss_extrude6_material"/>
        <!-- Part misumi_40t__cut_extrude6 -->
        <geom type="mesh" class="visual" pos="0 -0 -0.0052" quat="0 0.990016 -0.140953 -0" mesh="misumi_40t__cut_extrude6" material="misumi_40t__cut_extrude6_material"/>
        <geom type="mesh" class="collision" pos="0 -0 -0.0052" quat="0 0.990016 -0.140953 -0" mesh="misumi_40t__cut_extrude6" material="misumi_40t__cut_extrude6_material"/>
        <!-- Part misumi_40t__boss_extrude6_2 -->
        <geom type="mesh" class="visual" pos="-0.00305092 -0.0104973 -0.11571" quat="0.0996686 0.0996686 0.700047 0.700047" mesh="misumi_40t__boss_extrude6" material="misumi_40t__boss_extrude6_material"/>
        <geom type="mesh" class="collision" pos="-0.00305092 -0.0104973 -0.11571" quat="0.0996686 0.0996686 0.700047 0.700047" mesh="misumi_40t__boss_extrude6" material="misumi_40t__boss_extrude6_material"/>
        <!-- Part part_6 -->
        <geom type="mesh" class="visual" pos="-0.00305092 -0.0104973 -0.11571" quat="0.0996686 0.0996686 0.700047 0.700047" mesh="part_6" material="part_6_material"/>
        <geom type="mesh" class="collision" pos="-0.00305092 -0.0104973 -0.11571" quat="0.0996686 0.0996686 0.700047 0.700047" mesh="part_6" material="part_6_material"/>
        <!-- Part part_1 -->
        <geom type="mesh" class="visual" pos="0 -0 -0.0036" quat="0 0.990016 -0.140953 0" mesh="part_1" material="part_1_material"/>
        <geom type="mesh" class="collision" pos="0 -0 -0.0036" quat="0 0.990016 -0.140953 0" mesh="part_1" material="part_1_material"/>
        <!-- Part misumi_40t__cut_extrude6_2 -->
        <geom type="mesh" class="visual" pos="-0.00305092 -0.0104973 -0.11571" quat="0.0996686 0.0996686 0.700047 0.700047" mesh="misumi_40t__cut_extrude6" material="misumi_40t__cut_extrude6_material"/>
        <geom type="mesh" class="collision" pos="-0.00305092 -0.0104973 -0.11571" quat="0.0996686 0.0996686 0.700047 0.700047" mesh="misumi_40t__cut_extrude6" material="misumi_40t__cut_extrude6_material"/>
        <!-- Part bush_12_10_standard__cut_extrude2 -->
        <geom type="mesh" class="visual" pos="0 0 0" quat="0 1 0 0" mesh="bush_12_10_standard__cut_extrude2" material="bush_12_10_standard__cut_extrude2_material"/>
        <geom type="mesh" class="collision" pos="0 0 0" quat="0 1 0 0" mesh="bush_12_10_standard__cut_extrude2" material="bush_12_10_standard__cut_extrude2_material"/>
        <!-- Part part_1_2 -->
        <geom type="mesh" class="visual" pos="-0.00335792 -0.0115535 -0.11571" quat="0.0996686 0.0996686 0.700047 0.700047" mesh="part_1" material="part_1_material"/>
        <geom type="mesh" class="collision" pos="-0.00335792 -0.0115535 -0.11571" quat="0.0996686 0.0996686 0.700047 0.700047" mesh="part_1" material="part_1_material"/>
        <!-- Part part_6_2 -->
        <geom type="mesh" class="visual" pos="-0 0 -0.0052" quat="0 0.990016 -0.140953 -0" mesh="part_6" material="part_6_material"/>
        <geom type="mesh" class="collision" pos="-0 0 -0.0052" quat="0 0.990016 -0.140953 -0" mesh="part_6" material="part_6_material"/>
        <!-- Part bush_12_10_standard__cut_extrude2_2 -->
        <geom type="mesh" class="visual" pos="-0.00305092 -0.0104973 -0.11571" quat="0.0996686 0.0996686 0.700047 0.700047" mesh="bush_12_10_standard__cut_extrude2" material="bush_12_10_standard__cut_extrude2_material"/>
        <geom type="mesh" class="collision" pos="-0.00305092 -0.0104973 -0.11571" quat="0.0996686 0.0996686 0.700047 0.700047" mesh="bush_12_10_standard__cut_extrude2" material="bush_12_10_standard__cut_extrude2_material"/>
        <!-- Part part_1_3 -->
        <geom type="mesh" class="visual" pos="-0.0405848 -0.0321476 -0.025" quat="0 0.990016 -0.140953 -0" mesh="part_1__2" material="part_1__2_material"/>
        <geom type="mesh" class="collision" pos="-0.0405848 -0.0321476 -0.025" quat="0 0.990016 -0.140953 -0" mesh="part_1__2" material="part_1__2_material"/>
        <!-- Part part_1_4 -->
        <geom type="mesh" class="visual" pos="-0.0158669 0.0528986 -0.025" quat="0 0.990016 -0.140953 -0" mesh="part_1__2" material="part_1__2_material"/>
        <geom type="mesh" class="collision" pos="-0.0158669 0.0528986 -0.025" quat="0 0.990016 -0.140953 -0" mesh="part_1__2" material="part_1__2_material"/>
        <!-- Part base_plate -->
        <geom type="mesh" class="visual" pos="0 -0 -0.015" quat="0 -0.799716 -0.600379 0" mesh="base_plate" material="base_plate_material"/>
        <geom type="mesh" class="collision" pos="0 -0 -0.015" quat="0 -0.799716 -0.600379 0" mesh="base_plate" material="base_plate_material"/>
        <!-- Part front_bearing -->
        <geom type="mesh" class="visual" pos="-0.0194554 -0.0669401 -0.0278" quat="0 0.600379 -0.799716 0" mesh="front_bearing" material="front_bearing_material"/>
        <geom type="mesh" class="collision" pos="-0.0194554 -0.0669401 -0.0278" quat="0 0.600379 -0.799716 0" mesh="front_bearing" material="front_bearing_material"/>
        <!-- Part rear_bearing -->
        <geom type="mesh" class="visual" pos="-0.0194554 -0.0669401 -0.0558" quat="0.799716 0 0 0.600379" mesh="rear_bearing" material="rear_bearing_material"/>
        <geom type="mesh" class="collision" pos="-0.0194554 -0.0669401 -0.0558" quat="0.799716 0 0 0.600379" mesh="rear_bearing" material="rear_bearing_material"/>
        <!-- Part m3x10_screw -->
        <geom type="mesh" class="visual" pos="-0.000245415 -0.0563819 -0.0604" quat="0 0.600379 -0.799716 0" mesh="m3x10_screw" material="m3x10_screw_material"/>
        <geom type="mesh" class="collision" pos="-0.000245415 -0.0563819 -0.0604" quat="0 0.600379 -0.799716 0" mesh="m3x10_screw" material="m3x10_screw_material"/>
        <!-- Part front_end_cap -->
        <geom type="mesh" class="visual" pos="-0.0194554 -0.0669401 -0.033" quat="0.799716 0 0 0.600379" mesh="front_end_cap" material="front_end_cap_material"/>
        <geom type="mesh" class="collision" pos="-0.0194554 -0.0669401 -0.033" quat="0.799716 0 0 0.600379" mesh="front_end_cap" material="front_end_cap_material"/>
        <!-- Part shaft -->
        <geom type="mesh" class="visual" pos="-0.0194554 -0.0669401 -0.0596" quat="0.799716 0 0 0.600379" mesh="shaft" material="shaft_material"/>
        <geom type="mesh" class="collision" pos="-0.0194554 -0.0669401 -0.0596" quat="0.799716 0 0 0.600379" mesh="shaft" material="shaft_material"/>
        <!-- Part m3x10_screw_2 -->
        <geom type="mesh" class="visual" pos="-0.0300136 -0.04773 -0.0604" quat="0 0.600379 -0.799716 0" mesh="m3x10_screw" material="m3x10_screw_material"/>
        <geom type="mesh" class="collision" pos="-0.0300136 -0.04773 -0.0604" quat="0 0.600379 -0.799716 0" mesh="m3x10_screw" material="m3x10_screw_material"/>
        <!-- Part connector -->
        <geom type="mesh" class="visual" pos="-0.0194554 -0.0669401 -0.0624" quat="0.799716 0 0 0.600379" mesh="connector" material="connector_material"/>
        <geom type="mesh" class="collision" pos="-0.0194554 -0.0669401 -0.0624" quat="0.799716 0 0 0.600379" mesh="connector" material="connector_material"/>
        <!-- Part rear_end_cap -->
        <geom type="mesh" class="visual" pos="-0.0194554 -0.0669401 -0.0624" quat="0.799716 0 0 0.600379" mesh="rear_end_cap" material="rear_end_cap_material"/>
        <geom type="mesh" class="collision" pos="-0.0194554 -0.0669401 -0.0624" quat="0.799716 0 0 0.600379" mesh="rear_end_cap" material="rear_end_cap_material"/>
        <!-- Part m3x10_screw_3 -->
        <geom type="mesh" class="visual" pos="-0.0386654 -0.0774982 -0.0604" quat="0 0.600379 -0.799716 0" mesh="m3x10_screw" material="m3x10_screw_material"/>
        <geom type="mesh" class="collision" pos="-0.0386654 -0.0774982 -0.0604" quat="0 0.600379 -0.799716 0" mesh="m3x10_screw" material="m3x10_screw_material"/>
        <!-- Part m3x10_screw_4 -->
        <geom type="mesh" class="visual" pos="-0.00889723 -0.0861501 -0.0604" quat="0 0.600379 -0.799716 0" mesh="m3x10_screw" material="m3x10_screw_material"/>
        <geom type="mesh" class="collision" pos="-0.00889723 -0.0861501 -0.0604" quat="0 0.600379 -0.799716 0" mesh="m3x10_screw" material="m3x10_screw_material"/>
        <!-- Part stator -->
        <geom type="mesh" class="visual" pos="-0.0194554 -0.0669401 -0.053" quat="0.799716 0 0 0.600379" mesh="stator" material="stator_material"/>
        <geom type="mesh" class="collision" pos="-0.0194554 -0.0669401 -0.053" quat="0.799716 0 0 0.600379" mesh="stator" material="stator_material"/>
        <!-- Part front_bearing_2 -->
        <geom type="mesh" class="visual" pos="0.00328445 0.0113008 -0.046" quat="0.424532 -0.565485 -0.424532 -0.565485" mesh="front_bearing" material="front_bearing_material"/>
        <geom type="mesh" class="collision" pos="0.00328445 0.0113008 -0.046" quat="0.424532 -0.565485 -0.424532 -0.565485" mesh="front_bearing" material="front_bearing_material"/>
        <!-- Part rear_bearing_2 -->
        <geom type="mesh" class="visual" pos="0.011099 0.0381882 -0.046" quat="0.424532 0.565485 0.424532 -0.565485" mesh="rear_bearing" material="rear_bearing_material"/>
        <geom type="mesh" class="collision" pos="0.011099 0.0381882 -0.046" quat="0.424532 0.565485 0.424532 -0.565485" mesh="rear_bearing" material="rear_bearing_material"/>
        <!-- Part m3x10_screw_5 -->
        <geom type="mesh" class="visual" pos="-0.00250129 0.0469313 -0.0615" quat="0.424532 -0.565485 -0.424532 -0.565485" mesh="m3x10_screw" material="m3x10_screw_material"/>
        <geom type="mesh" class="collision" pos="-0.00250129 0.0469313 -0.0615" quat="0.424532 -0.565485 -0.424532 -0.565485" mesh="m3x10_screw" material="m3x10_screw_material"/>
        <!-- Part front_end_cap_2 -->
        <geom type="mesh" class="visual" pos="0.00473572 0.0162941 -0.046" quat="0.424532 0.565485 0.424532 -0.565485" mesh="front_end_cap" material="front_end_cap_material"/>
        <geom type="mesh" class="collision" pos="0.00473572 0.0162941 -0.046" quat="0.424532 0.565485 0.424532 -0.565485" mesh="front_end_cap" material="front_end_cap_material"/>
        <!-- Part shaft_2 -->
        <geom type="mesh" class="visual" pos="0.0121595 0.0418372 -0.046" quat="0.424532 0.565485 0.424532 -0.565485" mesh="shaft" material="shaft_material"/>
        <geom type="mesh" class="collision" pos="0.0121595 0.0418372 -0.046" quat="0.424532 0.565485 0.424532 -0.565485" mesh="shaft" material="shaft_material"/>
        <!-- Part m3x10_screw_6 -->
        <geom type="mesh" class="visual" pos="0.0272669 0.0382795 -0.0615" quat="0.424532 -0.565485 -0.424532 -0.565485" mesh="m3x10_screw" material="m3x10_screw_material"/>
        <geom type="mesh" class="collision" pos="0.0272669 0.0382795 -0.0615" quat="0.424532 -0.565485 -0.424532 -0.565485" mesh="m3x10_screw" material="m3x10_screw_material"/>
        <!-- Part connector_2 -->
        <geom type="mesh" class="visual" pos="0.012941 0.0445259 -0.046" quat="0.424532 0.565485 0.424532 -0.565485" mesh="connector" material="connector_material"/>
        <geom type="mesh" class="collision" pos="0.012941 0.0445259 -0.046" quat="0.424532 0.565485 0.424532 -0.565485" mesh="connector" material="connector_material"/>
        <!-- Part rear_end_cap_2 -->
        <geom type="mesh" class="visual" pos="0.012941 0.0445259 -0.046" quat="0.424532 0.565485 0.424532 -0.565485" mesh="rear_end_cap" material="rear_end_cap_material"/>
        <geom type="mesh" class="collision" pos="0.012941 0.0445259 -0.046" quat="0.424532 0.565485 0.424532 -0.565485" mesh="rear_end_cap" material="rear_end_cap_material"/>
        <!-- Part m3x10_screw_7 -->
        <geom type="mesh" class="visual" pos="0.0272669 0.0382795 -0.0305" quat="0.424532 -0.565485 -0.424532 -0.565485" mesh="m3x10_screw" material="m3x10_screw_material"/>
        <geom type="mesh" class="collision" pos="0.0272669 0.0382795 -0.0305" quat="0.424532 -0.565485 -0.424532 -0.565485" mesh="m3x10_screw" material="m3x10_screw_material"/>
        <!-- Part m3x10_screw_8 -->
        <geom type="mesh" class="visual" pos="-0.00250129 0.0469313 -0.0305" quat="0.424532 -0.565485 -0.424532 -0.565485" mesh="m3x10_screw" material="m3x10_screw_material"/>
        <geom type="mesh" class="collision" pos="-0.00250129 0.0469313 -0.0305" quat="0.424532 -0.565485 -0.424532 -0.565485" mesh="m3x10_screw" material="m3x10_screw_material"/>
        <!-- Part stator_2 -->
        <geom type="mesh" class="visual" pos="0.0103175 0.0354994 -0.046" quat="0.424532 0.565485 0.424532 -0.565485" mesh="stator" material="stator_material"/>
        <geom type="mesh" class="collision" pos="0.0103175 0.0354994 -0.046" quat="0.424532 0.565485 0.424532 -0.565485" mesh="stator" material="stator_material"/>
        <!-- Link antenna -->
        <body name="antenna" pos="-0.0117768 -0.0405203 -0.11571" quat="0.565485 0.424532 -0.565485 0.424532">
          <!-- Joint from mechanism to antenna -->
          <joint axis="0 0 1" name="elevation" type="hinge"/>
          <inertial pos="-5.2974e-05 -0.0842307 -0.18719" mass="0.693894" fullinertia="0.00812005 0.0077791 0.00760358 -2.63093e-06 2.00593e-06 -0.000430481"/>
          <!-- Part part_1_5 -->
          <geom type="mesh" class="visual" pos="-0.000643249 -0.14 -0.034829" quat="0 0.722835 -0 0.69102" mesh="part_1__3" material="part_1__3_material"/>
          <geom type="mesh" class="collision" pos="-0.000643249 -0.14 -0.034829" quat="0 0.722835 -0 0.69102" mesh="part_1__3" material="part_1__3_material"/>
          <!-- Part part_1_6 -->
          <geom type="mesh" class="visual" pos="0.000197883 -0.0797586 -0.195463" quat="0.657706 0.657706 -0.259659 0.259659" mesh="part_1__4" material="part_1__4_material"/>
          <geom type="mesh" class="collision" pos="0.000197883 -0.0797586 -0.195463" quat="0.657706 0.657706 -0.259659 0.259659" mesh="part_1__4" material="part_1__4_material"/>
          <!-- Part part_1_7 -->
          <geom type="mesh" class="visual" pos="-0.000213991 -0.0797586 -0.195027" quat="0.491529 0.491529 0.50833 -0.50833" mesh="part_1__4" material="part_1__4_material"/>
          <geom type="mesh" class="collision" pos="-0.000213991 -0.0797586 -0.195027" quat="0.491529 0.491529 0.50833 -0.50833" mesh="part_1__4" material="part_1__4_material"/>
          <!-- Part part_1_8 -->
          <geom type="mesh" class="visual" pos="8.24797e-05 -0.0797586 -0.194724" quat="0.280977 0.280977 -0.648885 0.648885" mesh="part_1__4" material="part_1__4_material"/>
          <geom type="mesh" class="collision" pos="8.24797e-05 -0.0797586 -0.194724" quat="0.280977 0.280977 -0.648885 0.648885" mesh="part_1__4" material="part_1__4_material"/>
          <!-- Part part_1_9 -->
          <geom type="mesh" class="visual" pos="-0.000213875 -0.0797586 -0.194853" quat="0.259771 0.259771 0.657662 -0.657662" mesh="part_1__4" material="part_1__4_material"/>
          <geom type="mesh" class="collision" pos="-0.000213875 -0.0797586 -0.194853" quat="0.259771 0.259771 0.657662 -0.657662" mesh="part_1__4" material="part_1__4_material"/>
          <!-- Part part_1_10 -->
          <geom type="mesh" class="visual" pos="-5.45e-10 -0.082 -0.194941" quat="0.707107 0.707107 0 0" mesh="part_1__5" material="part_1__5_material"/>
          <geom type="mesh" class="collision" pos="-5.45e-10 -0.082 -0.194941" quat="0.707107 0.707107 0 0" mesh="part_1__5" material="part_1__5_material"/>
          <!-- Part part_1_11 -->
          <geom type="mesh" class="visual" pos="-0.160132 -0.14 -0.195547" quat="0 0.0242405 0 0.999706" mesh="part_1__3" material="part_1__3_material"/>
          <geom type="mesh" class="collision" pos="-0.160132 -0.14 -0.195547" quat="0 0.0242405 0 0.999706" mesh="part_1__3" material="part_1__3_material"/>
          <!-- Part part_1_12 -->
          <geom type="mesh" class="visual" pos="0.112612 -0.14 -0.0810859" quat="0 -0.932532 0 -0.361087" mesh="part_1__3" material="part_1__3_material"/>
          <geom type="mesh" class="collision" pos="0.112612 -0.14 -0.0810859" quat="0 -0.932532 0 -0.361087" mesh="part_1__3" material="part_1__3_material"/>
          <!-- Part part_1_13 -->
          <geom type="mesh" class="visual" pos="0.000210757 -0.0797586 -0.194843" quat="0.507762 0.507762 -0.492115 0.492115" mesh="part_1__4" material="part_1__4_material"/>
          <geom type="mesh" class="collision" pos="0.000210757 -0.0797586 -0.194843" quat="0.507762 0.507762 -0.492115 0.492115" mesh="part_1__4" material="part_1__4_material"/>
          <!-- Part part_1_14 -->
          <geom type="mesh" class="visual" pos="-0 0 -0.108" quat="0 1 0 -0" mesh="part_1__6" material="part_1__6_material"/>
          <geom type="mesh" class="collision" pos="-0 0 -0.108" quat="0 1 0 -0" mesh="part_1__6" material="part_1__6_material"/>
          <!-- Part part_1_15 -->
          <geom type="mesh" class="visual" pos="-3.68e-10 -0.08 -0.194941" quat="0.707107 -0.707107 0 -0" mesh="part_1__7" material="part_1__7_material"/>
          <geom type="mesh" class="collision" pos="-3.68e-10 -0.08 -0.194941" quat="0.707107 -0.707107 0 -0" mesh="part_1__7" material="part_1__7_material"/>
          <!-- Part part_1_16 -->
          <geom type="mesh" class="visual" pos="0.160139 -0.14 -0.194595" quat="0 0.999658 -0 -0.026148" mesh="part_1__3" material="part_1__3_material"/>
          <geom type="mesh" class="collision" pos="0.160139 -0.14 -0.194595" quat="0 0.999658 -0 -0.026148" mesh="part_1__3" material="part_1__3_material"/>
          <!-- Part part_1_17 -->
          <geom type="mesh" class="visual" pos="8.0659e-05 -0.0797586 -0.195156" quat="0.707 0.707 0.0122722 -0.0122722" mesh="part_1__4" material="part_1__4_material"/>
          <geom type="mesh" class="collision" pos="8.0659e-05 -0.0797586 -0.195156" quat="0.707 0.707 0.0122722 -0.0122722" mesh="part_1__4" material="part_1__4_material"/>
          <!-- Part part_1_18 -->
          <geom type="mesh" class="visual" pos="0.000758921 -0.14 -0.355124" quat="0 -0.687481 0 0.726203" mesh="part_1__3" material="part_1__3_material"/>
          <geom type="mesh" class="collision" pos="0.000758921 -0.14 -0.355124" quat="0 -0.687481 0 0.726203" mesh="part_1__3" material="part_1__3_material"/>
          <!-- Part part_1_19 -->
          <geom type="mesh" class="visual" pos="-9.27801e-05 -0.0797586 -0.195152" quat="0.648564 0.648564 0.281716 -0.281716" mesh="part_1__4" material="part_1__4_material"/>
          <geom type="mesh" class="collision" pos="-9.27801e-05 -0.0797586 -0.195152" quat="0.648564 0.648564 0.281716 -0.281716" mesh="part_1__4" material="part_1__4_material"/>
          <!-- Part part_1_20 -->
          <geom type="mesh" class="visual" pos="0.113655 -0.14 -0.307792" quat="0 -0.913253 0 0.407392" mesh="part_1__3" material="part_1__3_material"/>
          <geom type="mesh" class="collision" pos="0.113655 -0.14 -0.307792" quat="0 -0.913253 0 0.407392" mesh="part_1__3" material="part_1__3_material"/>
          <!-- Part part_1_21 -->
          <geom type="mesh" class="visual" pos="-9.21016e-05 -0.0797586 -0.194728" quat="0.011477 0.011477 -0.707014 0.707014" mesh="part_1__4" material="part_1__4_material"/>
          <geom type="mesh" class="collision" pos="-9.21016e-05 -0.0797586 -0.194728" quat="0.011477 0.011477 -0.707014 0.707014" mesh="part_1__4" material="part_1__4_material"/>
          <!-- Part part_2 -->
          <geom type="mesh" class="visual" pos="-1.17e-10 -0.08 -0.194941" quat="0.707107 0.707107 0 0" mesh="part_2" material="part_2_material"/>
          <geom type="mesh" class="collision" pos="-1.17e-10 -0.08 -0.194941" quat="0.707107 0.707107 0 0" mesh="part_2" material="part_2_material"/>
          <!-- Part part_1_22 -->
          <geom type="mesh" class="visual" pos="0 0 -0.085" quat="0.707107 -0.707107 0 0" mesh="part_1__8" material="part_1__8_material"/>
          <geom type="mesh" class="collision" pos="0 0 -0.085" quat="0.707107 -0.707107 0 0" mesh="part_1__8" material="part_1__8_material"/>
          <!-- Part part_1_23 -->
          <geom type="mesh" class="visual" pos="-0.112818 -0.14 -0.308598" quat="0 -0.359344 -0 0.933205" mesh="part_1__3" material="part_1__3_material"/>
          <geom type="mesh" class="collision" pos="-0.112818 -0.14 -0.308598" quat="0 -0.359344 -0 0.933205" mesh="part_1__3" material="part_1__3_material"/>
          <!-- Part part_1_24 -->
          <geom type="mesh" class="visual" pos="-0.113736 -0.14 -0.0822106" quat="0 0.404777 -0 0.914416" mesh="part_1__3" material="part_1__3_material"/>
          <geom type="mesh" class="collision" pos="-0.113736 -0.14 -0.0822106" quat="0 0.404777 -0 0.914416" mesh="part_1__3" material="part_1__3_material"/>
          <!-- Part part_1_25 -->
          <geom type="mesh" class="visual" pos="-1.17e-10 -0.08 -0.194941" quat="0.707107 0.707107 0 0" mesh="part_1__9" material="part_1__9_material"/>
          <geom type="mesh" class="collision" pos="-1.17e-10 -0.08 -0.194941" quat="0.707107 0.707107 0 0" mesh="part_1__9" material="part_1__9_material"/>
        </body>
      </body>
    </body>
  </worldbody>
  <asset>
    <mesh file="stator.stl"/>
    <mesh file="bush_12_10_standard__cut_extrude2.stl"/>
    <mesh file="part_1__7.stl"/>
    <mesh file="part_1__6.stl"/>
    <mesh file="misumi_40t__cut_extrude6.stl"/>
    <mesh file="part_1__4.stl"/>
    <mesh file="part_1__8.stl"/>
    <mesh file="base_plate.stl"/>
    <mesh file="part_1.stl"/>
    <mesh file="part_1__9.stl"/>
    <mesh file="shaft.stl"/>
    <mesh file="misumi_40t__boss_extrude6.stl"/>
    <mesh file="front_end_cap.stl"/>
    <mesh file="rear_end_cap.stl"/>
    <mesh file="connector.stl"/>
    <mesh file="part_2.stl"/>
    <mesh file="front_bearing.stl"/>
    <mesh file="m3x10_screw.stl"/>
    <mesh file="base_pole.stl"/>
    <mesh file="part_1__2.stl"/>
    <mesh file="part_1__5.stl"/>
    <mesh file="part_1__3.stl"/>
    <mesh file="rear_bearing.stl"/>
    <mesh file="part_6.stl"/>
    <material name="base_pole_material" rgba="0.615686 0.811765 0.929412 1"/>
    <material name="misumi_40t__boss_extrude6_material" rgba="0.792157 0.819608 0.933333 1"/>
    <material name="misumi_40t__cut_extrude6_material" rgba="0.792157 0.819608 0.933333 1"/>
    <material name="part_6_material" rgba="0.972549 0.529412 0.00392157 1"/>
    <material name="part_1_material" rgba="0.615686 0.811765 0.929412 1"/>
    <material name="bush_12_10_standard__cut_extrude2_material" rgba="0.792157 0.819608 0.933333 1"/>
    <material name="part_1__2_material" rgba="0.615686 0.811765 0.929412 1"/>
    <material name="base_plate_material" rgba="0.615686 0.811765 0.929412 1"/>
    <material name="front_bearing_material" rgba="0.0980392 0.0980392 0.0980392 1"/>
    <material name="rear_bearing_material" rgba="0.0980392 0.0980392 0.0980392 1"/>
    <material name="m3x10_screw_material" rgba="0.8 0.8 0.8 1"/>
    <material name="front_end_cap_material" rgba="0.0980392 0.0980392 0.0980392 1"/>
    <material name="shaft_material" rgba="0.0980392 0.0980392 0.0980392 1"/>
    <material name="connector_material" rgba="0.0980392 0.0980392 0.0980392 1"/>
    <material name="rear_end_cap_material" rgba="0.0980392 0.0980392 0.0980392 1"/>
    <material name="stator_material" rgba="0.0980392 0.0980392 0.0980392 1"/>
    <material name="part_1__3_material" rgba="0.647059 0.647059 0.647059 1"/>
    <material name="part_1__4_material" rgba="0.768627 0.886275 0.952941 1"/>
    <material name="part_1__5_material" rgba="0.917647 0.917647 0.917647 1"/>
    <material name="part_1__6_material" rgba="0.768627 0.886275 0.952941 1"/>
    <material name="part_1__7_material" rgba="0.498039 0.498039 0.498039 1"/>
    <material name="part_2_material" rgba="0.647059 0.647059 0.647059 1"/>
    <material name="part_1__8_material" rgba="0.615686 0.811765 0.929412 1"/>
    <material name="part_1__9_material" rgba="0.615686 0.811765 0.929412 1"/>
  </asset>
  <actuator>
    <position class="antenna" name="azimuth" joint="azimuth"/>
    <position class="antenna" name="elevation" joint="elevation"/>
  </actuator>
  <equality/>
</mujoco>
