MuriloVAlves/TG/CAD_Models/Full assembly/urdf/full_assembly.urdf

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
<robot name="full_assembly">
    <link name="base_plate">
        <inertial>
            <mass value="0.0813347" />
            <origin xyz="0.00136837 3.66619e-18 -0.005" rpy="0 -0 0" />
            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
        </inertial>
        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
    </link>
    <link name="base_pole">
        <inertial>
            <mass value="0.574125" />
            <origin xyz="1.07192e-18 6.73491e-19 0.150233" rpy="0 -0 0" />
            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
        </inertial>
        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
    </link>
    <link name="bush_12_10_standard__cut_extrude2">
        <inertial>
            <mass value="0.00142383" />
            <origin xyz="-0.00013106 -0.000131061 0.00779632" rpy="0 -0 0" />
            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
        </inertial>
        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
    </link>
    <link name="bush_12_10_standard__cut_extrude2_1">
        <inertial>
            <mass value="0.00142383" />
            <origin xyz="0.00016243 8.9276e-05 0.00779632" rpy="0 -0 2.85875" />
            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
        </inertial>
        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
    </link>
    <link name="connector">
        <inertial>
            <mass value="0.00191702" />
            <origin xyz="0.0202348 2.33313e-16 0.00618763" rpy="0 -0 0" />
            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
        </inertial>
        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
    </link>
    <link name="connector_1">
        <inertial>
            <mass value="0.00191702" />
            <origin xyz="0.0202348 2.33313e-16 0.00618763" rpy="0 -0 0" />
            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
        </inertial>
        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
    </link>
    <link name="cylindrical_1" />
    <link name="cylindrical_2" />
    <link name="front_bearing">
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
    <link name="planar_2" />
    <link name="planar_2_1" />
    <link name="rear_bearing">
        <inertial>
            <mass value="0.00241688" />
            <origin xyz="5.53644e-19 4.70265e-19 8.14988e-05" rpy="0 -0 0" />
            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
        </inertial>
        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
    </link>
    <link name="rear_bearing_1">
        <inertial>
            <mass value="0.00241688" />
            <origin xyz="5.53644e-19 4.70265e-19 8.14988e-05" rpy="0 -0 0" />
            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
        </inertial>
        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
    </link>
    <link name="rear_end_cap">
        <inertial>
            <mass value="0.0371261" />
            <origin xyz="-0.000345693 6.70748e-17 0.00459005" rpy="0 -0 0" />
            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
        </inertial>
        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
    </link>
    <link name="rear_end_cap_1">
        <inertial>
            <mass value="0.0371261" />
            <origin xyz="0.0206543 -9.30471e-16 -0.000309954" rpy="0 -0 0" />
            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
        </inertial>
        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
    </link>
    <link name="rear_end_cap__1__loop_closure">
        <inertial>
            <mass value="1e-09" />
            <origin xyz="-1.07553e-15 0.0206 5.55112e-20" rpy="0 -0 0" />
            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
        </inertial>
    </link>
    <link name="root" />
    <link name="shaft">
        <inertial>
            <mass value="0.00301347" />
            <origin xyz="-3.54304e-05 3.67903e-20 0.0286813" rpy="0 -0 0" />
            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
        </inertial>
        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
    </link>
    <link name="shaft_1">
        <inertial>
            <mass value="0.00301347" />
            <origin xyz="-3.54304e-05 3.67903e-20 0.0286813" rpy="0 -0 0" />
            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
        </inertial>
        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
    </link>
    <link name="stator">
        <inertial>
            <mass value="0.0871447" />
            <origin xyz="2.07078e-17 2.9319e-17 0.01" rpy="0 -0 0" />
            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
        </inertial>
        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
    </link>
    <link name="stator_1">
        <inertial>
            <mass value="0.0871447" />
            <origin xyz="2.07078e-17 2.9319e-17 0.01" rpy="0 -0 0" />
            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
        </inertial>
        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
    </link>
    <joint name="cylindrical_1" type="prismatic">
        <origin xyz="0 0 0.325" rpy="-6.16298e-33 9.81923e-33 -3.14159" />
        <axis xyz="0 0 1" />
        <parent link="base_pole" />
        <child link="cylindrical_1" />
        <limit effort="1" velocity="1" lower="-10000" upper="10000" />
    </joint>
    <joint name="cylindrical_1_1" type="continuous">
        <origin xyz="0 0 0" rpy="0 -0 0" />
        <axis xyz="0 0 1" />
        <parent link="cylindrical_1" />
        <child link="base_plate" />
    </joint>
    <joint name="cylindrical_2" type="prismatic">
        <origin xyz="9.02056e-17 0.06971 0.003" rpy="-1.6263e-16 6.12323e-17 1.57019e-13" />
        <axis xyz="-6.12323e-17 -0 1" />
        <parent link="part_6" />
        <child link="cylindrical_2" />
        <limit effort="1" velocity="1" lower="-10000" upper="10000" />
    </joint>
    <joint name="cylindrical_2_1" type="continuous">
        <origin xyz="0 0 0" rpy="0 -0 0" />
        <axis xyz="-6.12323e-17 -0 1" />
        <parent link="cylindrical_2" />
        <child link="part_1_2" />
    </joint>
    <joint name="dof_azimuth" type="continuous">
        <origin xyz="-2.77556e-17 2.77556e-17 0.3" rpy="9.95786e-29 -1.40021e-28 1.5708" />
        <axis xyz="0 0 -1" />
        <parent link="base_pole" />
        <child link="bush_12_10_standard__cut_extrude2_1" />
    </joint>
    <joint name="dof_elevation" type="continuous">
        <origin xyz="1.38778e-17 -0.085 6.93889e-18" rpy="0 1.5708 3.14159" />
        <axis xyz="-0 -1 -0" />
        <parent link="part_1_13" />
        <child link="part_1_1" />
    </joint>
    <joint name="fastened_1" type="fixed">
        <origin xyz="0 0.075 0" rpy="-1.5708 3.2818e-17 2.57912e-17" />
        <axis xyz="0 0 -1" />
        <parent link="part_1_13" />
        <child link="part_1_20" />
    </joint>
    <joint name="fastened_2" type="fixed">
        <origin xyz="-1.38778e-17 0 -0.01" rpy="-1.22368e-28 1.09572e-28 1.5708" />
        <axis xyz="-0 1.6263e-16 1" />
        <parent link="base_plate" />
        <child link="misumi_40t__cut_extrude6_1" />
    </joint>
    <joint name="fastened_3" type="fixed">
        <origin xyz="-0.06971 6.93889e-18 4.33681e-19" rpy="3.14159 -1.6263e-16 2.43945e-19" />
        <axis xyz="0 0 1" />
        <parent link="base_plate" />
        <child link="front_end_cap" />
    </joint>
    <joint name="fastened_4" type="fixed">
        <origin xyz="0.0513684 0 -1.30104e-18" rpy="-1.6263e-16 1.01812e-28 1.5708" />
        <axis xyz="0 0 -1" />
        <parent link="base_plate" />
        <child link="part_1" />
    </joint>
    <joint name="fastened_5_loop_closure" type="fixed">
        <origin xyz="1.09079e-14 1.44607e-14 0.016" rpy="1.70829e-16 -2.52687e-16 -4.36732e-16" />
        <axis xyz="-0 -0 -1" />
        <parent link="bush_12_10_standard__cut_extrude2" />
        <child link="misumi_40t__cut_extrude6__2__loop_closure" />
    </joint>
    <joint name="fastened_6" type="fixed">
        <origin xyz="1.09079e-14 1.44607e-14 0.0035" rpy="1.91864e-16 -1.40147e-16 -2.01078e-16" />
        <axis xyz="-0 -1.6263e-16 -1" />
        <parent link="misumi_40t__boss_extrude6" />
        <child link="misumi_40t__cut_extrude6" />
    </joint>
    <joint name="fastened_7" type="fixed">
        <origin xyz="0 1.38778e-17 -0.0014" rpy="-1.6263e-16 -6.15636e-33 8.13152e-20" />
        <axis xyz="0 0 1" />
        <parent link="misumi_40t__cut_extrude6_1" />
        <child link="misumi_40t__boss_extrude6_1" />
    </joint>
    <joint name="fixed_node_to_root_joint" type="fixed">
        <origin xyz="0.0961226 0.0348166 -0.321178" rpy="-6.12323e-17 2.25198e-28 0.000198377" />
        <axis xyz="0 0 1" />
        <parent link="root" />
        <child link="base_pole" />
    </joint>
    <joint name="group_1_fastened_joint" type="fixed">
        <origin xyz="0 0 -0.0028" rpy="-3.14159 1.22465e-16 -3.14159" />
        <axis xyz="0 0 1" />
        <parent link="front_end_cap" />
        <child link="front_bearing" />
    </joint>
    <joint name="group_1_fastened_joint_1" type="fixed">
        <origin xyz="2.77556e-17 1.11022e-16 0.0066" rpy="1.2326e-32 -1.2326e-32 2.71051e-20" />
        <axis xyz="-0 -0 -1" />
        <parent link="connector" />
        <child link="rear_bearing" />
    </joint>
    <joint name="group_1_fastened_joint_10" type="fixed">
        <origin xyz="-1.38778e-17 9.71445e-17 0.0052" rpy="3.14159 1.22465e-16 -3.14159" />
        <axis xyz="0 0 1" />
        <parent link="front_end_cap_1" />
        <child link="front_bearing_1" />
    </joint>
    <joint name="group_1_fastened_joint_11" type="fixed">
        <origin xyz="0.021 -9.29812e-16 0.0017" rpy="-5.94534e-45 -7.52309e-37 2.23637e-81" />
        <axis xyz="0 0 1" />
        <parent link="rear_end_cap_1" />
        <child link="rear_bearing_1" />
    </joint>
    <joint name="group_1_fastened_joint_12" type="fixed">
        <origin xyz="-4.16334e-17 -0.031 -5.68989e-16" rpy="7.23598e-44 -2.22976e-76 6.16298e-33" />
        <axis xyz="0 0 1" />
        <parent link="m3x10_screw_6" />
        <child link="m3x10_screw_7" />
    </joint>
    <joint name="group_1_fastened_joint_13" type="fixed">
        <origin xyz="6.93889e-18 -2.91434e-16 0.02" rpy="-5.94534e-45 -7.52309e-37 2.23637e-81" />
        <axis xyz="0 0 1" />
        <parent link="stator_1" />
        <child link="front_end_cap_1" />
    </joint>
    <joint name="group_1_fastened_joint_14" type="fixed">
        <origin xyz="0 2.70617e-16 0.0028" rpy="-5.94534e-45 -7.52309e-37 2.23637e-81" />
        <axis xyz="0 0 1" />
        <parent link="connector_1" />
        <child link="shaft_1" />
    </joint>
    <joint name="group_1_fastened_joint_15" type="fixed">
        <origin xyz="-0.0155 0.0155 0.0326" rpy="7.23598e-44 -2.22976e-76 6.16298e-33" />
        <axis xyz="0 0 1" />
        <parent link="front_bearing_1" />
        <child link="m3x10_screw_6" />
    </joint>
    <joint name="group_1_fastened_joint_16" type="fixed">
        <origin xyz="1.38778e-17 -6.93889e-17 -0.0066" rpy="-5.94534e-45 -7.52309e-37 2.23637e-81" />
        <axis xyz="0 0 1" />
        <parent link="rear_bearing_1" />
        <child link="connector_1" />
    </joint>
    <joint name="group_1_fastened_joint_17" type="fixed">
        <origin xyz="0.031 0.031 5.6205e-16" rpy="7.23598e-44 -2.22976e-76 6.16298e-33" />
        <axis xyz="0 0 1" />
        <parent link="m3x10_screw_7" />
        <child link="m3x10_screw_4" />
    </joint>
    <joint name="group_1_fastened_joint_18" type="fixed">
        <origin xyz="-6.93889e-18 -0.031 -3.26128e-16" rpy="7.23598e-44 -2.22976e-76 6.16298e-33" />
        <axis xyz="0 0 1" />
        <parent link="m3x10_screw_4" />
        <child link="m3x10_screw_5" />
    </joint>
    <joint name="group_1_fastened_joint_19" type="fixed">
        <origin xyz="-1.38778e-17 -3.53884e-16 0.0066" rpy="-5.94534e-45 -7.52309e-37 2.23637e-81" />
        <axis xyz="0 0 1" />
        <parent link="shaft_1" />
        <child link="stator_1" />
    </joint>
    <joint name="group_1_fastened_joint_2" type="fixed">
        <origin xyz="-1.66533e-16 -0.031 6.245e-17" rpy="4.17619e-53 -3.08149e-33 -2.71051e-20" />
        <axis xyz="0 0 1" />
        <parent link="m3x10_screw_2" />
        <child link="m3x10_screw_3" />
    </joint>
    <joint name="group_1_fastened_joint_20" type="fixed">
        <origin xyz="-0.00628774 0.160206 0.0602414" rpy="1.5708 -6.65024e-14 1.56051" />
        <axis xyz="-0 -0 -1" />
        <parent link="part_1_23" />
        <child link="part_1_19" />
    </joint>
    <joint name="group_1_fastened_joint_21" type="fixed">
        <origin xyz="-0.000313684 0.000725082 2.35922e-16" rpy="1.01171e-13 -7.57914e-14 -2.35711" />
        <axis xyz="-0 -0 -1" />
        <parent link="part_1_5" />
        <child link="part_1_18" />
    </joint>
    <joint name="group_1_fastened_joint_22" type="fixed">
        <origin xyz="-2.90492e-06 0.000599826 3.46945e-17" rpy="5.68428e-15 -3.68803e-14 -2.35642" />
        <axis xyz="-0 -0 -1" />
        <parent link="part_1_18" />
        <child link="part_1_14" />
    </joint>
    <joint name="group_1_fastened_joint_23" type="fixed">
        <origin xyz="-0.000312947 0.000286118 -3.1225e-16" rpy="2.77634e-14 3.2665e-14 -2.35447" />
        <axis xyz="-0 -0 -1" />
        <parent link="part_1_14" />
        <child link="part_1_8" />
    </joint>
    <joint name="group_1_fastened_joint_24" type="fixed">
        <origin xyz="-2.34401e-05 0.000424106 -1.5335e-15" rpy="3.47745e-13 2.69907e-13 2.35445" />
        <axis xyz="-0 -0 -1" />
        <parent link="part_1_24" />
        <child link="part_1_22" />
    </joint>
    <joint name="group_1_fastened_joint_25" type="fixed">
        <origin xyz="-4.27941e-10 8.83893e-10 0.002" rpy="6.99544e-30 -1.10369e-59 3.15544e-30" />
        <axis xyz="0 0 1" />
        <parent link="part_1_4" />
        <child link="part_1_15" />
    </joint>
    <joint name="group_1_fastened_joint_26" type="fixed">
        <origin xyz="0.109019 0.117406 0.0602414" rpy="1.5708 1.70364e-13 0.768795" />
        <axis xyz="-0 -0 -1" />
        <parent link="part_1_8" />
        <child link="part_1_12" />
    </joint>
    <joint name="group_1_fastened_joint_27" type="fixed">
        <origin xyz="-0.160116 -0.00595747 0.0602414" rpy="1.5708 1.15449e-13 3.1281" />
        <axis xyz="-0 -0 -1" />
        <parent link="part_1_22" />
        <child link="part_1_16" />
    </joint>
    <joint name="group_1_fastened_joint_28" type="fixed">
        <origin xyz="0.000210758 -9.78346e-05 0.000241359" rpy="-3.14159 6.23787e-14 -1.5395" />
        <axis xyz="-0 -0 -1" />
        <parent link="part_1_10" />
        <child link="part_1_24" />
    </joint>
    <joint name="group_1_fastened_joint_29" type="fixed">
        <origin xyz="-0.159902 -0.06 0.00871725" rpy="1.5708 0.052302 2.75163e-13" />
        <axis xyz="-0 -0 -1" />
        <parent link="part_1_6" />
        <child link="part_1_10" />
    </joint>
    <joint name="group_1_fastened_joint_3" type="fixed">
        <origin xyz="-1.38778e-16 -7.63278e-17 -0.0066" rpy="1.2326e-32 -1.2326e-32 2.71051e-20" />
        <axis xyz="-0 -0 -1" />
        <parent link="stator" />
        <child link="shaft" />
    </joint>
    <joint name="group_1_fastened_joint_30" type="fixed">
        <origin xyz="-0.169013 -5.13478e-16 -0.150353" rpy="0 1.5708 6.68558e-14" />
        <axis xyz="-0 -0 -1" />
        <parent link="part_1_11" />
        <child link="part_1_6" />
    </joint>
    <joint name="group_1_fastened_joint_31" type="fixed">
        <origin xyz="0.0001217 0.000123657 -4.85723e-17" rpy="-4.15526e-14 -5.28746e-15 0.784847" />
        <axis xyz="-0 -0 -1" />
        <parent link="part_1_21" />
        <child link="part_1_23" />
    </joint>
    <joint name="group_1_fastened_joint_32" type="fixed">
        <origin xyz="-0.0402015 -1.17961e-15 0.115627" rpy="2.42007e-14 -0.786371 -1.72006e-14" />
        <axis xyz="-0 -0 -1" />
        <parent link="part_1_7" />
        <child link="part_1_11" />
    </joint>
    <joint name="group_1_fastened_joint_33" type="fixed">
        <origin xyz="-9.27801e-05 0.0797586 0.0351518" rpy="-1.5708 -0.819559 -1.86652e-13" />
        <axis xyz="-0 -0 -1" />
        <parent link="part_1_20" />
        <child link="part_1_21" />
    </joint>
    <joint name="group_1_fastened_joint_34" type="fixed">
        <origin xyz="-0.267545 7.29972e-15 0.126461" rpy="3.14159 -0.776599 3.14159" />
        <axis xyz="-0 -0 -1" />
        <parent link="part_1_19" />
        <child link="part_1_7" />
    </joint>
    <joint name="group_1_fastened_joint_35" type="fixed">
        <origin xyz="-0.159847 -0.0602414 0.0081075" rpy="1.5708 0.771329 3.14159" />
        <axis xyz="-0 -0 -1" />
        <parent link="part_1_16" />
        <child link="part_1_5" />
    </joint>
    <joint name="group_1_fastened_joint_36" type="fixed">
        <origin xyz="-1.17392e-10 0.08 0.0349409" rpy="-1.5708 5.05992e-14 -1.59636e-13" />
        <axis xyz="0 0 1" />
        <parent link="part_1_20" />
        <child link="part_2" />
    </joint>
    <joint name="group_1_fastened_joint_37" type="fixed">
        <origin xyz="-0.168204 -1.80411e-16 -0.151523" rpy="0 1.5708 4.49873e-14" />
        <axis xyz="-0 -0 -1" />
        <parent link="part_1_9" />
        <child link="part_1_17" />
    </joint>
    <joint name="group_1_fastened_joint_38" type="fixed">
        <origin xyz="-0.0408481 6.13398e-15 0.115452" rpy="-3.45776e-14 -0.784984 6.01463e-15" />
        <axis xyz="-0 -0 -1" />
        <parent link="part_1_12" />
        <child link="part_1_9" />
    </joint>
    <joint name="group_1_fastened_joint_39" type="fixed">
        <origin xyz="-2.77556e-17 1.249e-16 9.49954e-11" rpy="6.99544e-30 -1.10369e-59 3.15544e-30" />
        <axis xyz="0 0 1" />
        <parent link="part_2" />
        <child link="part_1_4" />
    </joint>
    <joint name="group_1_fastened_joint_4" type="fixed">
        <origin xyz="-0.0155 0.0155 0.0326" rpy="4.17619e-53 -3.08149e-33 -2.71051e-20" />
        <axis xyz="0 0 1" />
        <parent link="front_bearing" />
        <child link="m3x10_screw_2" />
    </joint>
    <joint name="group_1_fastened_joint_5" type="fixed">
        <origin xyz="0 0 -0.0028" rpy="1.2326e-32 -1.2326e-32 2.71051e-20" />
        <axis xyz="-0 -0 -1" />
        <parent link="shaft" />
        <child link="connector" />
    </joint>
    <joint name="group_1_fastened_joint_6" type="fixed">
        <origin xyz="-2.77556e-17 -1.11022e-16 -0.0066" rpy="1.2326e-32 -1.2326e-32 2.71051e-20" />
        <axis xyz="-0 -0 -1" />
        <parent link="rear_bearing" />
        <child link="rear_end_cap" />
    </joint>
    <joint name="group_1_fastened_joint_7" type="fixed">
        <origin xyz="0.031 0.031 -6.93889e-17" rpy="4.17619e-53 -3.08149e-33 -2.71051e-20" />
        <axis xyz="0 0 1" />
        <parent link="m3x10_screw_3" />
        <child link="m3x10_screw_1" />
    </joint>
    <joint name="group_1_fastened_joint_8" type="fixed">
        <origin xyz="3.05311e-16 -0.031 4.16334e-17" rpy="4.17619e-53 -3.08149e-33 -2.71051e-20" />
        <axis xyz="0 0 1" />
        <parent link="m3x10_screw_1" />
        <child link="m3x10_screw" />
    </joint>
    <joint name="group_1_fastened_joint_9" type="fixed">
        <origin xyz="0 -4.16334e-17 -0.028" rpy="1.2326e-32 -1.2326e-32 2.71051e-20" />
        <axis xyz="-0 -0 -1" />
        <parent link="front_end_cap" />
        <child link="stator" />
    </joint>
    <joint name="planar_1_loop_closure" type="prismatic">
        <origin xyz="-0.0206 0.005 0.021" rpy="0 -1.5708 -1.5708" />
        <axis xyz="1 0 0" />
        <parent link="part_1" />
        <child link="planar_1_loop_closure_1" />
        <limit effort="1" velocity="1" lower="-10000" upper="10000" />
    </joint>
    <joint name="planar_1_loop_closure_1" type="prismatic">
        <origin xyz="0 0 0" rpy="0 -0 0" />
        <axis xyz="0 -1 0" />
        <parent link="planar_1_loop_closure_1" />
        <child link="planar_1_loop_closure" />
        <limit effort="1" velocity="1" lower="-10000" upper="10000" />
    </joint>
    <joint name="planar_1_loop_closure_2" type="continuous">
        <origin xyz="0 0 0" rpy="0 -0 0" />
        <axis xyz="0 0 -1" />
        <parent link="planar_1_loop_closure" />
        <child link="rear_end_cap__1__loop_closure" />
    </joint>
    <joint name="planar_2" type="prismatic">
        <origin xyz="0.0414684 -6.93889e-18 3.90313e-18" rpy="0 -1.5708 5.34034e-28" />
        <axis xyz="0 1 0" />
        <parent link="base_plate" />
        <child link="planar_2_1" />
        <limit effort="1" velocity="1" lower="-10000" upper="10000" />
    </joint>
    <joint name="planar_2_1" type="prismatic">
        <origin xyz="0 0 0" rpy="0 -0 0" />
        <axis xyz="0 0 -1" />
        <parent link="planar_2_1" />
        <child link="planar_2" />
        <limit effort="1" velocity="1" lower="-10000" upper="10000" />
    </joint>
    <joint name="planar_2_2" type="continuous">
        <origin xyz="0 0 0" rpy="0 -0 0" />
        <axis xyz="-1 0 0" />
        <parent link="planar_2" />
        <child link="rear_end_cap_1" />
    </joint>
    <joint name="revolute_1" type="continuous">
        <origin xyz="-6.03684e-16 -3.46945e-17 0.01" rpy="-3.14159 4.36756e-18 -1.5708" />
        <axis xyz="-6.12323e-17 0 1" />
        <parent link="front_end_cap_1" />
        <child link="part_1_3" />
    </joint>
    <joint name="revolute_2" type="continuous">
        <origin xyz="-6.93889e-18 4.16334e-17 -0.013" rpy="1.6263e-16 -6.12574e-17 3.19967e-32" />
        <axis xyz="0 1.6263e-16 1" />
        <parent link="part_1_3" />
        <child link="part_6_1" />
    </joint>
    <joint name="revolute_3" type="continuous">
        <origin xyz="-1.11022e-16 -0.06971 1.38778e-17" rpy="-4.28388e-16 -9.74698e-17 -3.96306e-16" />
        <axis xyz="-0 -0 -1" />
        <parent link="part_6_1" />
        <child link="misumi_40t__boss_extrude6" />
    </joint>
    <joint name="revolute_4_loop_closure" type="continuous">
        <origin xyz="2.77556e-16 0 0.056" rpy="3.14159 -6.12323e-17 -1.5708" />
        <axis xyz="6.12323e-17 0 -1" />
        <parent link="shaft" />
        <child link="part_1__1__loop_closure" />
    </joint>
    <joint name="revolute_5" type="continuous">
        <origin xyz="-1.09218e-14 -1.44468e-14 -0.0035" rpy="1.6263e-16 2.30321e-32 -1.57019e-13" />
        <axis xyz="-0 1.6263e-16 1" />
        <parent link="misumi_40t__boss_extrude6_1" />
        <child link="part_6" />
    </joint>
    <joint name="slider_1" type="prismatic">
        <origin xyz="2.77556e-17 0.00856542 0.09071" rpy="0 1.5708 3.14159" />
        <axis xyz="0 1 0" />
        <parent link="part_1" />
        <child link="part_1_13" />
        <limit effort="1" velocity="1" lower="-10000" upper="10000" />
    </joint>
    <joint name="slider_2" type="prismatic">
        <origin xyz="6.93889e-18 0 -0.0049" rpy="2.10352e-17 1.12567e-16 2.35654e-16" />
        <axis xyz="-0 -0 1" />
        <parent link="misumi_40t__boss_extrude6" />
        <child link="bush_12_10_standard__cut_extrude2" />
        <limit effort="1" velocity="1" lower="-10000" upper="10000" />
    </joint>
</robot>
