MuriloVAlves/TG/(commit log)

2026-02-08 feat - started MuJoCo tests
    [hello.xml, two_links.xml]
2026-02-14 Added antenna pole vector
2026-03-29 Criado cálculo para estipular os melhores parâmetros da antena
2026-04-04 Criado codigo para levantamento de curva de motores
2026-04-06 Started description of encoders and motors
2026-04-20 Added metodology section after motor tests
    [CONVERSAO_MOTOR_1_ANTI_CRESC.xlsx, CONVERSAO_MOTOR_1_ANTI_DECRESC.xlsx, CONVERSAO_MOTOR_1_HOR_CRESC.xlsx, CONVERSAO_MOTOR_1_HOR_DECRESC.xlsx, CONVERSAO_MOTOR_2_ANTI_CRESC.xlsx, CONVERSAO_MOTOR_2_ANTI_DECRESC.xlsx, CONVERSAO_MOTOR_2_HOR_CRESC.xlsx, CONVERSAO_MOTOR_2_HOR_DECRESC.xlsx]
2026-06-16 Added parabolic antenna geometry calculator
2026-08-16 Fixed conceptual error in filter comparation
2026-08-31 Added fast abg filter grid search
2026-09-07 Feature: Added a new way to search for the best filter
2026-09-27 feature - Made changes to the filter tools
2026-11-08 feature - added CAD models
